notaroomba/frost/README.md

# Frost

A computer that fits into an altoids tin!
