notaroomba/frost/BOM.csv

Item | Price | Source
MIPI Camera (WN-WX19) | 10.58 | https://es.aliexpress.com/item/1005008622498846.html
Li-ion Battery | 8.98 | https://es.aliexpress.com/item/1005009973979747.html
Small Display 2.28 in | 6.4 | https://es.aliexpress.com/item/1005006185077108.html
