notaroomba/frost/hardware/board/assets/frost-Memory and Storage.pdf

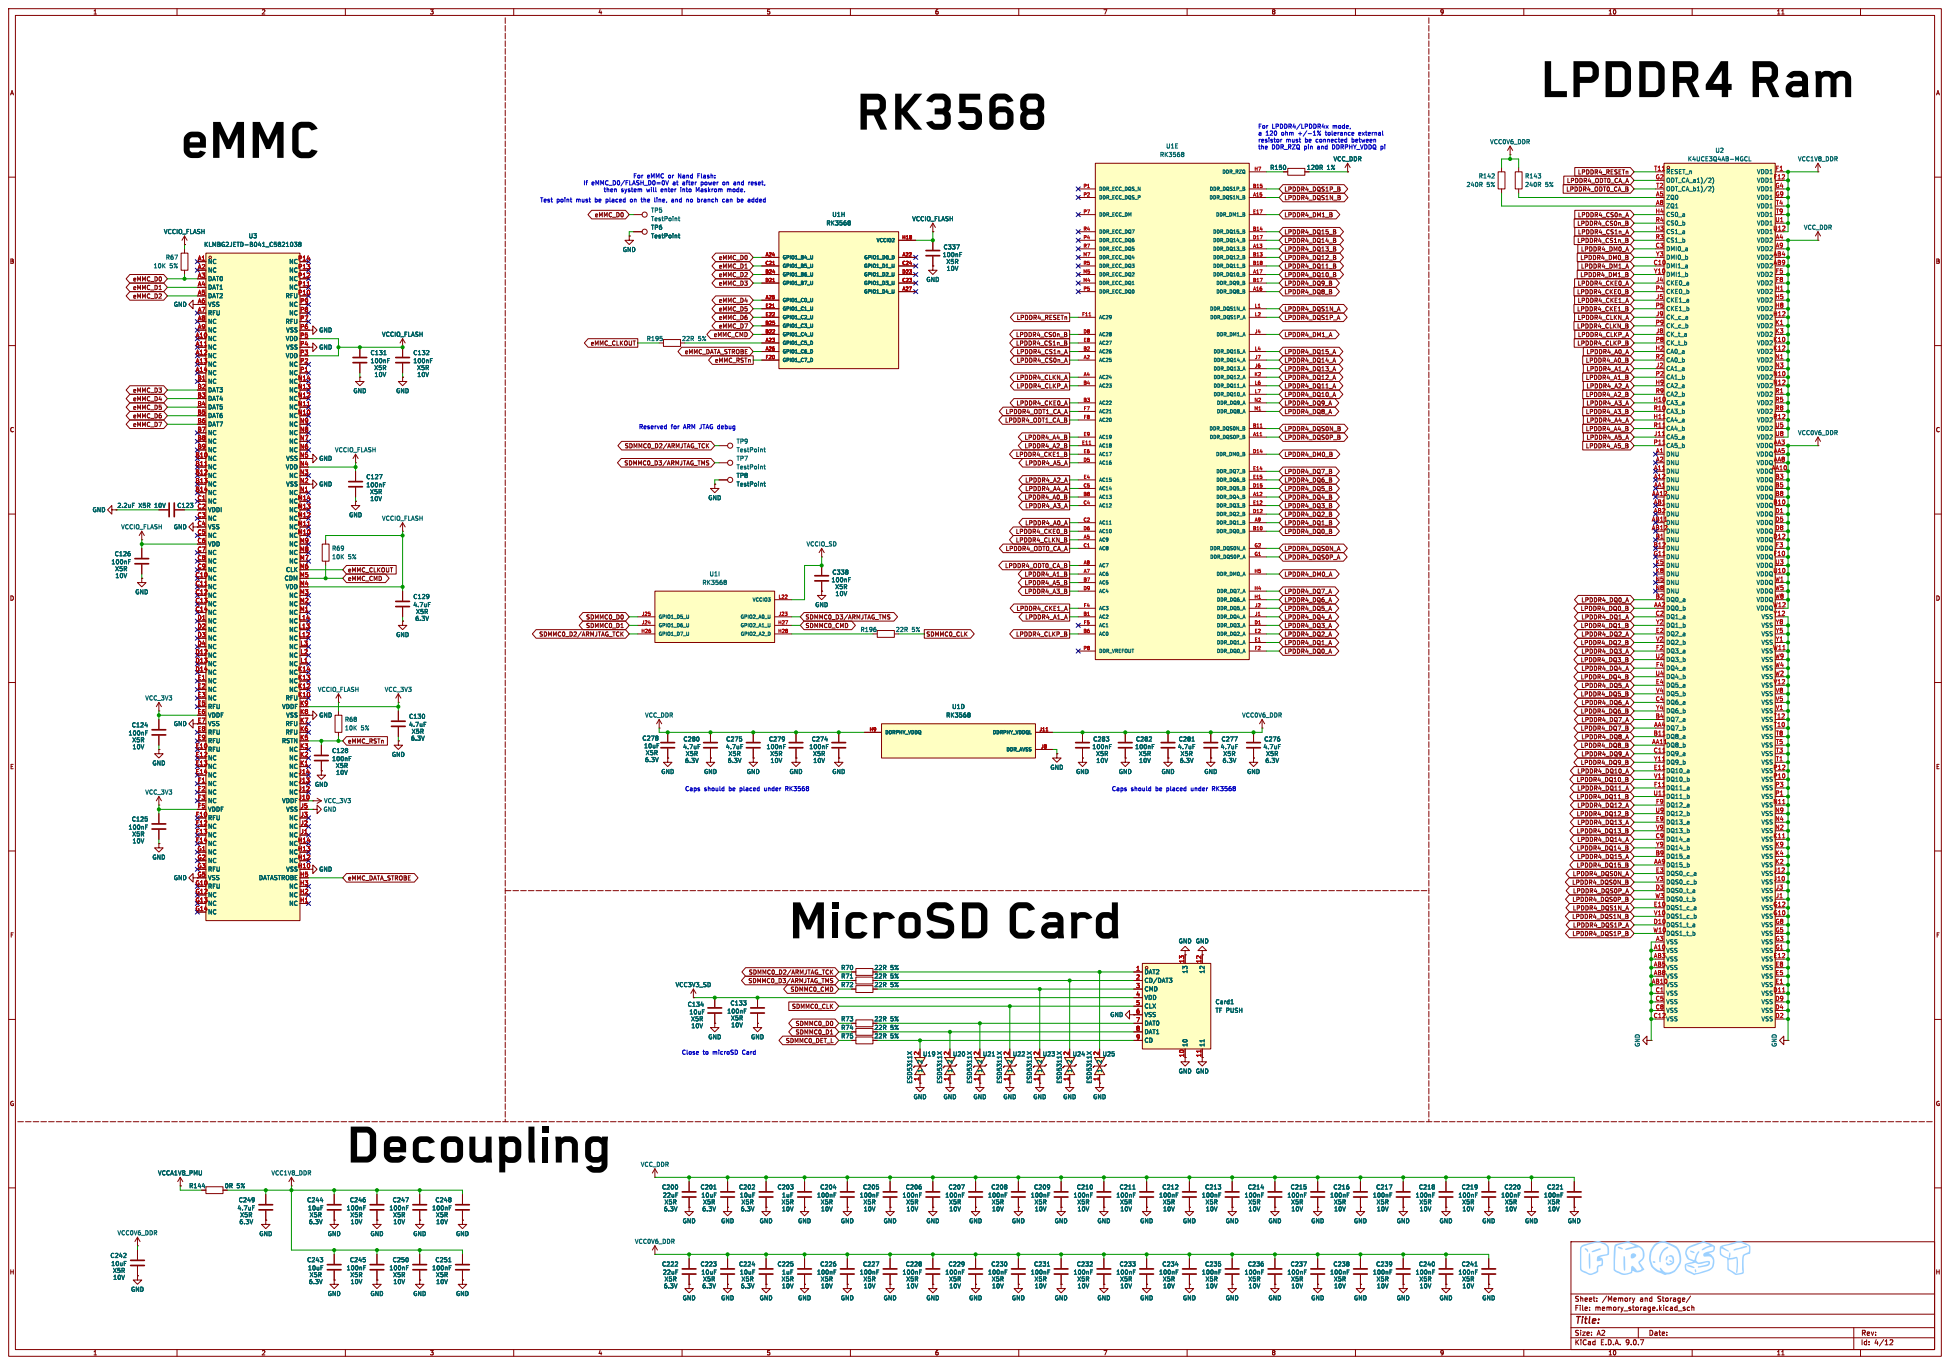
[picture p1: page 1]

RK3568 eMMC
then system will enter into Maskrom mode. Test point must be placed on the line, and no branch can be added Decoupling

the DDR_RZQ pin and DDRPHY_VDDQ pi

NCP14 NCP13 NCP12 NCP11 RFUP10 NC P9 NC P8 RFU P7 VSS P6 VDD P5 VSS P4 VDD P3 NC P2 NC P1 NCN14 NCN13 NCN12 NCN11 NCN10 NC N9 NC N8 NC N7 NC N6 VSS N5 VDD N4 NC N3 VSS N2 NC N1 NCM14 NCM13 NCM12 NCM11 NCM10 NC M9 NC M8 NC M7 CLK M6 CDM M5 VDD M4 NC M3 NC M2 NC M1 NCL14 NCL13 NCL12 NC L3 NC L2 NC L1 NCK14 NCK13 NCK12 RFUK10 VDDF K9 VSS K8 RFU K7 RFU K6 RSTN K5 NC K3 NC K2 NC K1 NCJ14 NCJ13 NCJ12 VDDFJ10 VSS J5 NC J3 NC J2 NC J1 NCH14 NCH13 NCH12 VSSH10 DATASTROBEH5 NC H3 NC H2 NC H1

VCCIO_FLASH
NC A1 NC A2 DAT0 A3 DAT1 A4 DAT2 A5 VSS A6 RFU A7 NC A8 NC A9 NC A10 NC A11 NC A12 NC A13 NC A14 NC B1 DAT3 B2 DAT4 B3 DAT5 B4 DAT6 B5 DAT7 B6 NC B7 NC B8 NC B9 NC B10 NC B11 NC B12 NC B13 NC B14 NC C1 VDDI C2 NC C3 VSS C4 NC C5 VDD C6 NC C7 NC C8 NC C9 NC C10 NC C11 NC C12 NC C13 NC C14 NC D1 NC D2 NC D3 NC D4 NC D12 NC D13 NC D14 NC E1 NC E2 NC E3 RFU E5 VDDF E6 VSS E7 RFU E8 RFU E9 RFU E10 NC E12 NC E13 NC E14 NC F1 NC F2 NC F3 VDDF F5 RFU F10 NC F12 NC F13 NC F14 NC G1 NC G2 RFU G3 VSS G5 RFU G10 NC G12 NC G13 NC G14
GND GND

U3 KLMBG2JETD-B041_C5821038

Reserved for ARM JTAG debug
6.3VGND GND

U3 VDDQ
U10 VDDQ W1 VDDQ W5 VDDQ W8 VDDQW12 VSS
