notaroomba/frost/hardware/board/assets/frost-Power.pdf

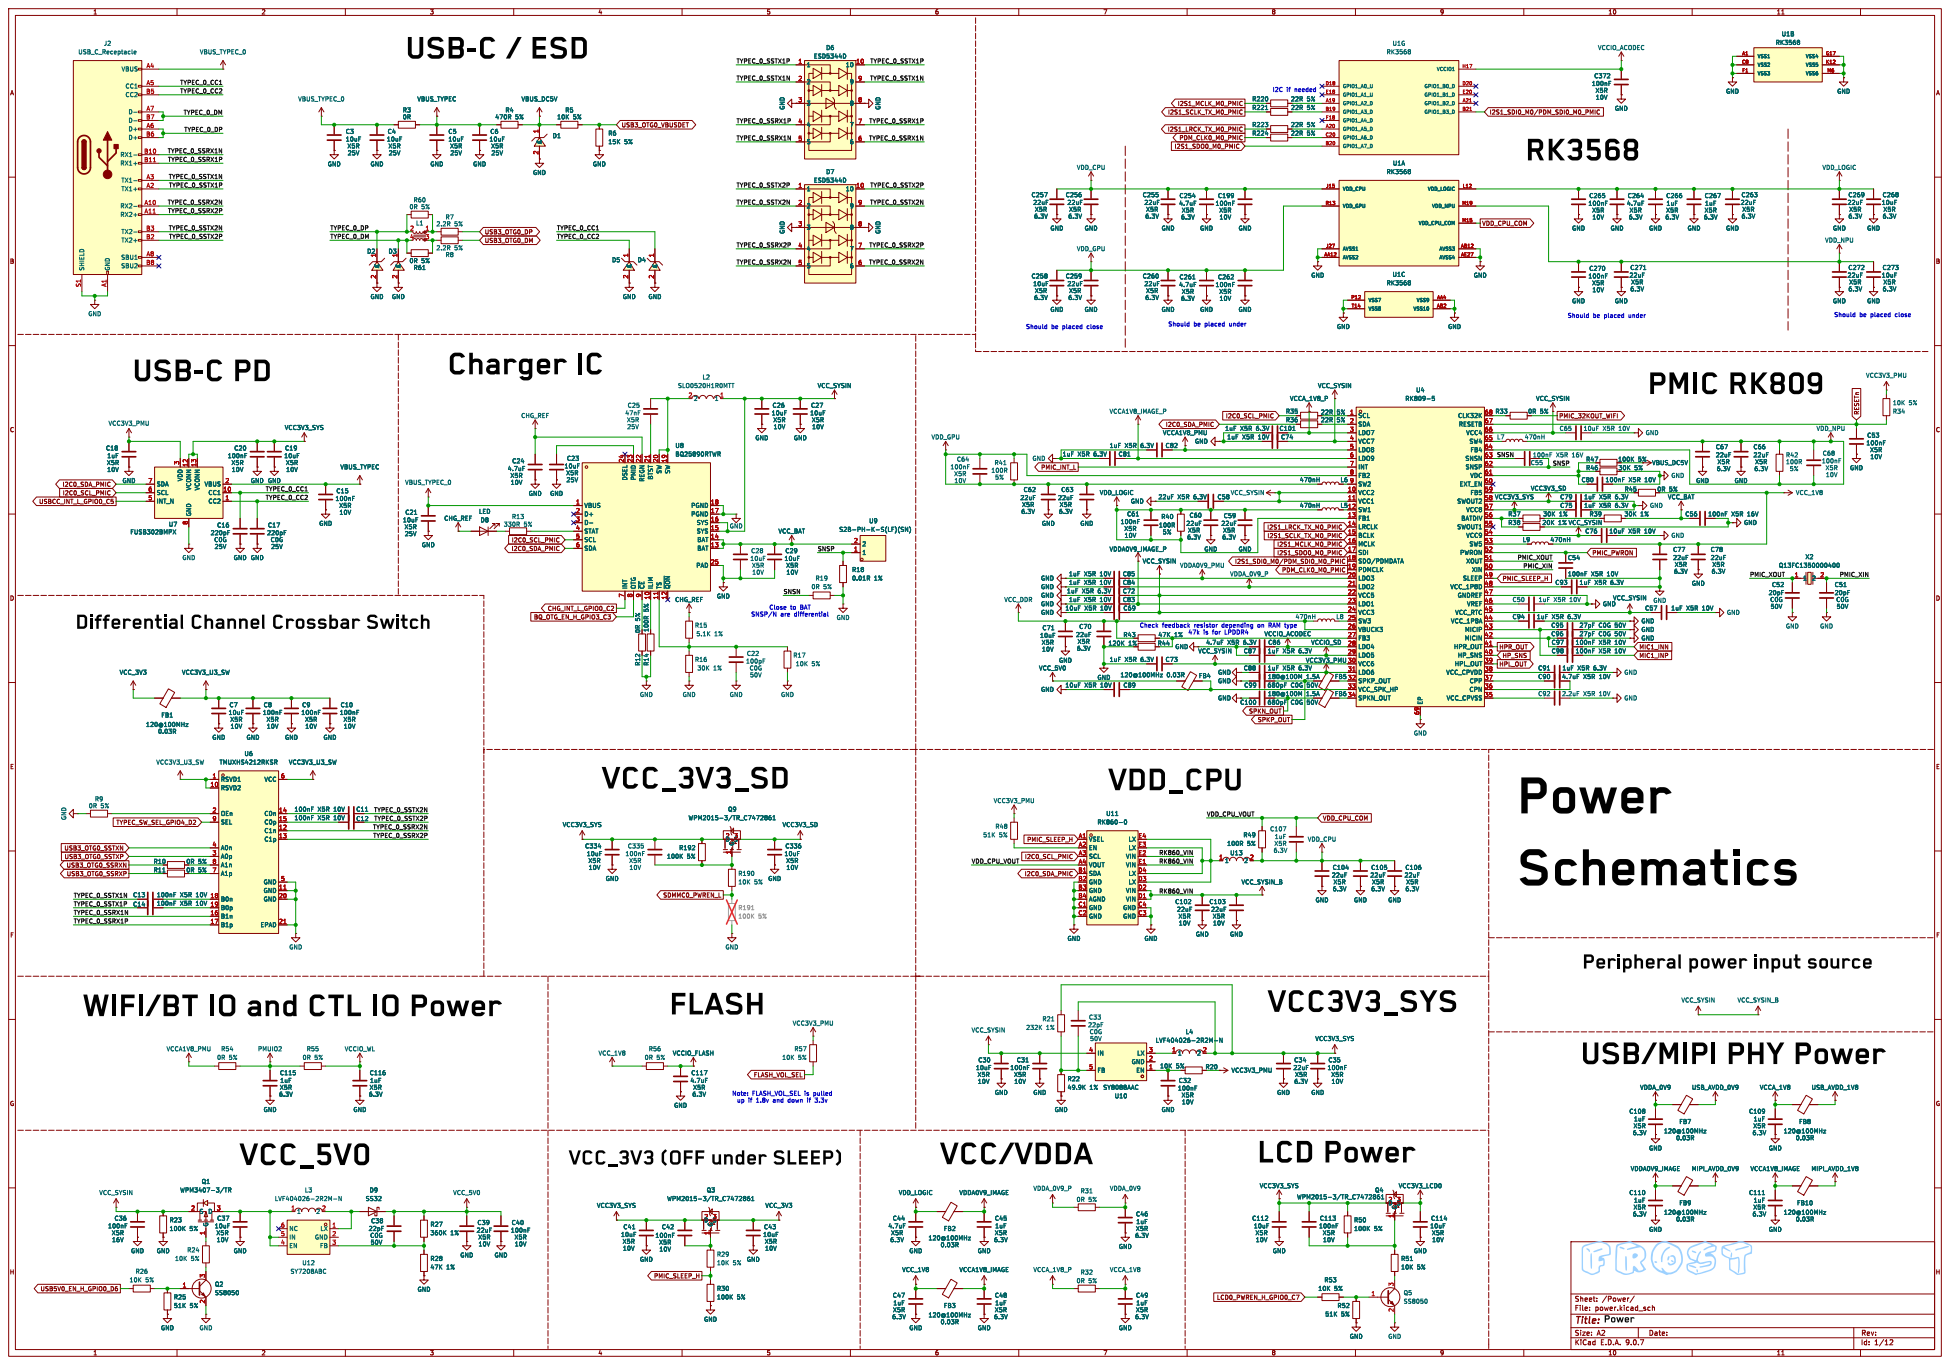
[picture p2: page 1]

47k is for LPDDR4 USB-C/ ESD

Should be placed under RK3568

Should be placed close VDD_CPU

Should be placed under ChargerIC

8 REGN 22 ~{CE} 9 BTST 21 ILIM 10 SW 20 TS 11 SW 19 ~{QON} 12 PGND 18 PGND 17 SYS 16 SYS 15 BAT 14 BAT 13 PAD 25 U8BQ25890RTWR

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

Close to BAT SNSP/N are differential VCC_5V0

LX D3 VIN D2 VIN D1 GND C4 GND C3 U11 RK860-0
VSEL A1 EN A2 SCL A3 VOUT A4 SDA B1 GND B2 GND B3 AGND B4 GND C1 GND C2

LX 1 GND 2 FB 3 NC 6
