notaroomba/frost/hardware/board/assets/frost-USB.pdf

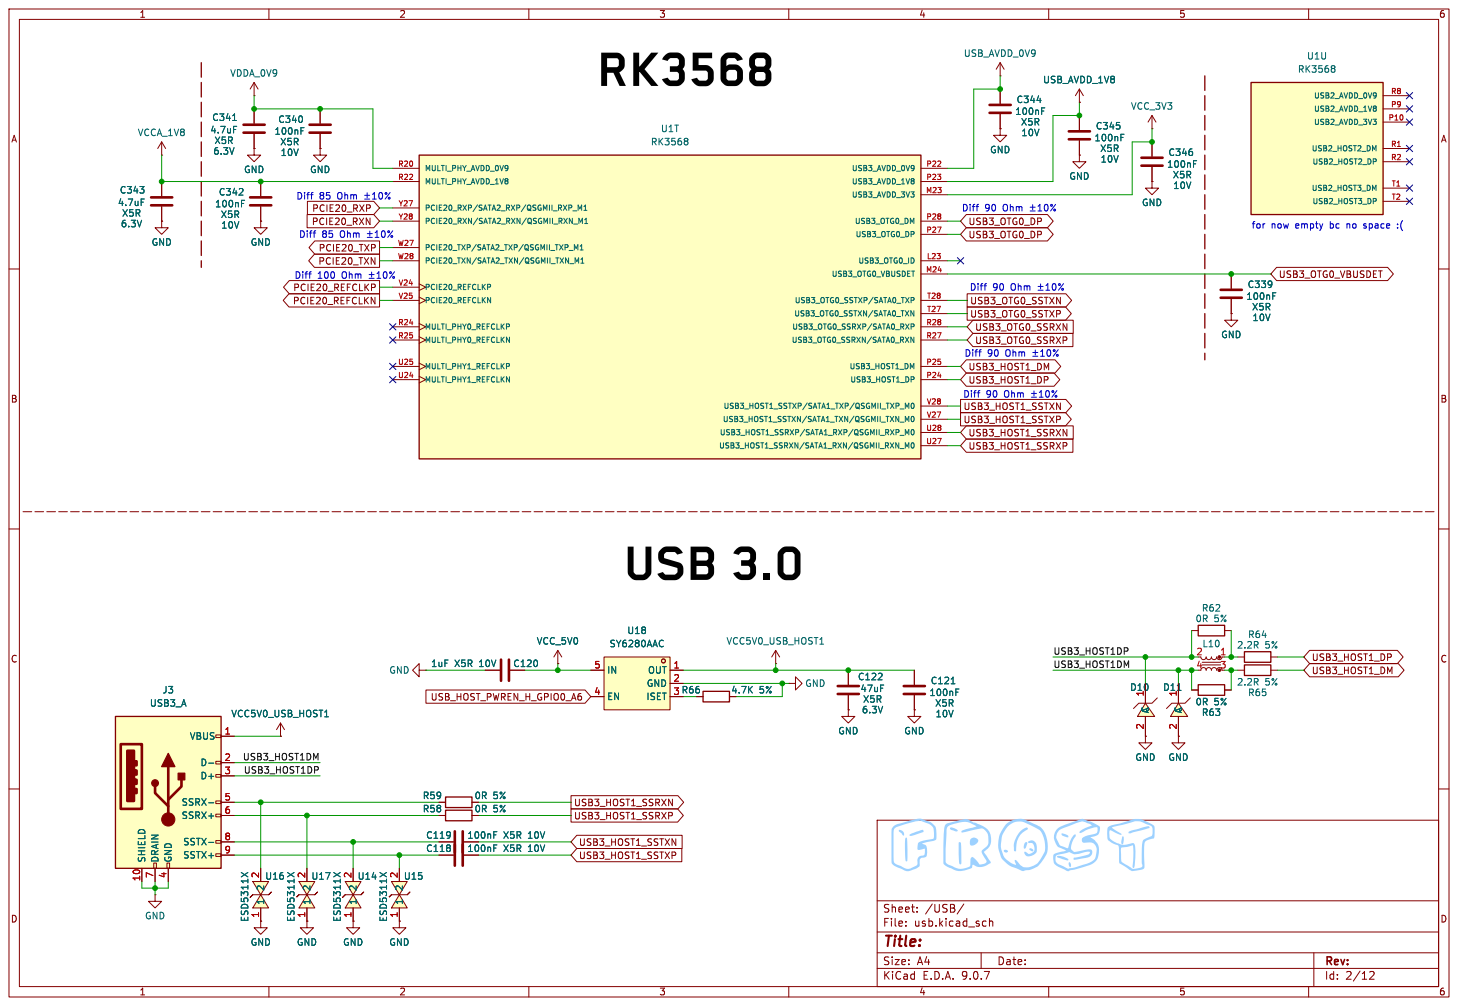
[picture p3: page 1]

for now empty bc no space :( GND

4 VBUS 1 D- 2 D+ 3 SSRX- 5 SSRX+ 6 SSTX- 8 SSTX+ 9

4 VBUS 1 D- 2 D+ 3 SSRX- 5 SSRX+ 6 SSTX- 8 SSTX+ 9 C119 100nF X5R 10V R58 0R 5%
