notaroomba/frost/hardware/board/assets/frost-WiFi and Bluetooth.pdf

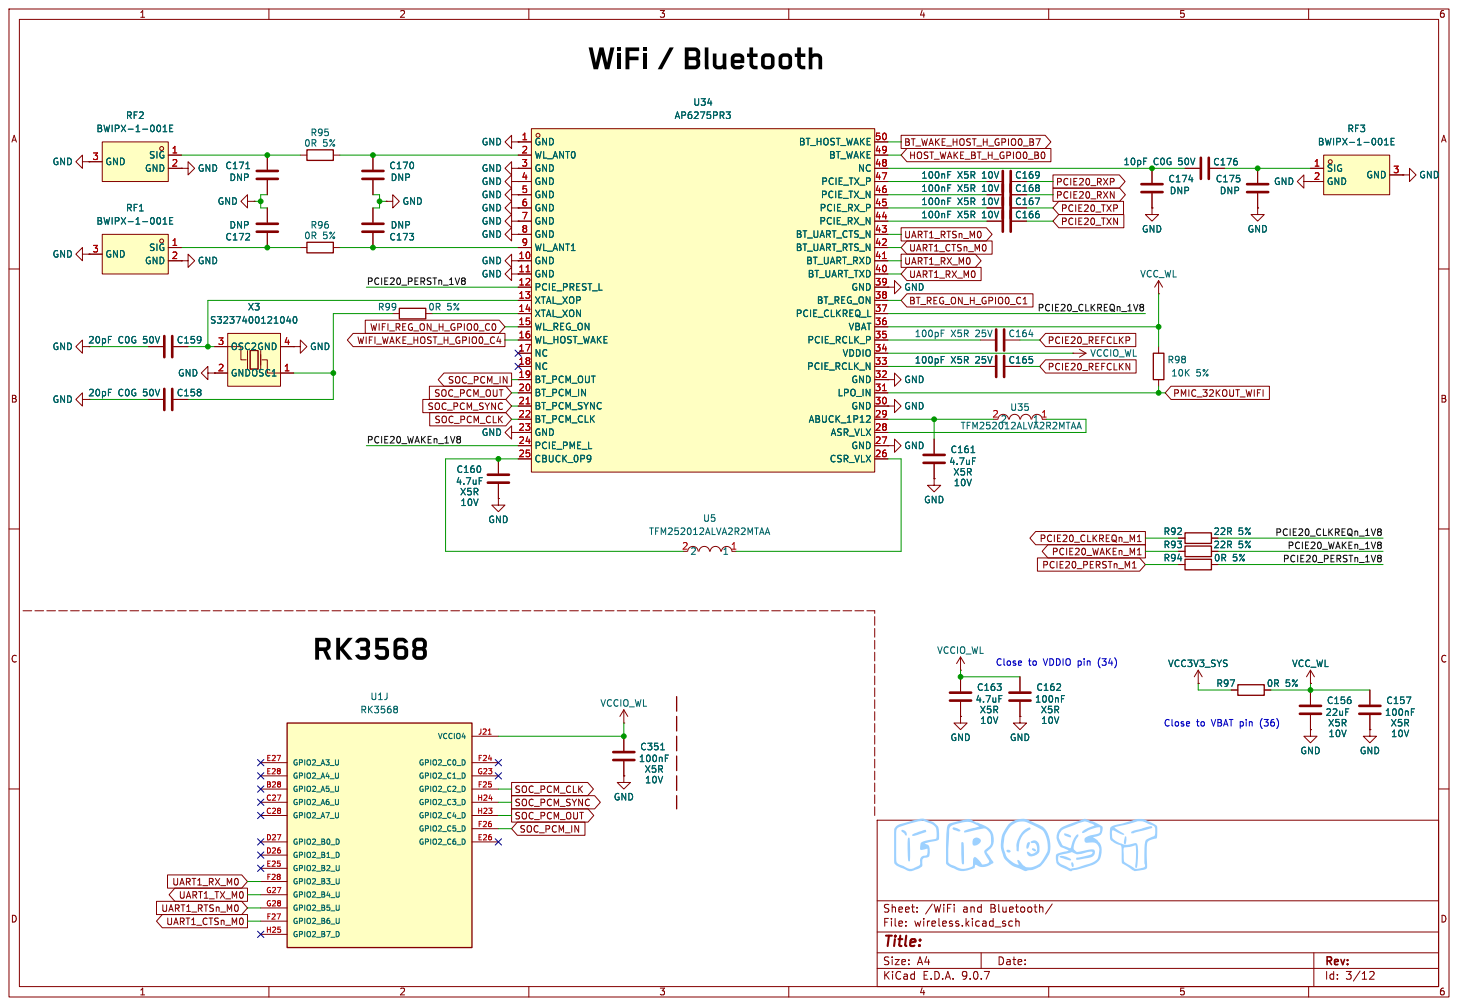
[picture p4: page 1]

3 GND
X3 S3237400121040 GND 4 OSC1 1 OSC2 3 GND 2 C171 DNP GND
GND

GND GND GND GND GND
