notaroomba/frost/hardware/board/frost.kicad_pcb

## KiCad design hardware/board/frost.kicad_pcb (2026-08-28)

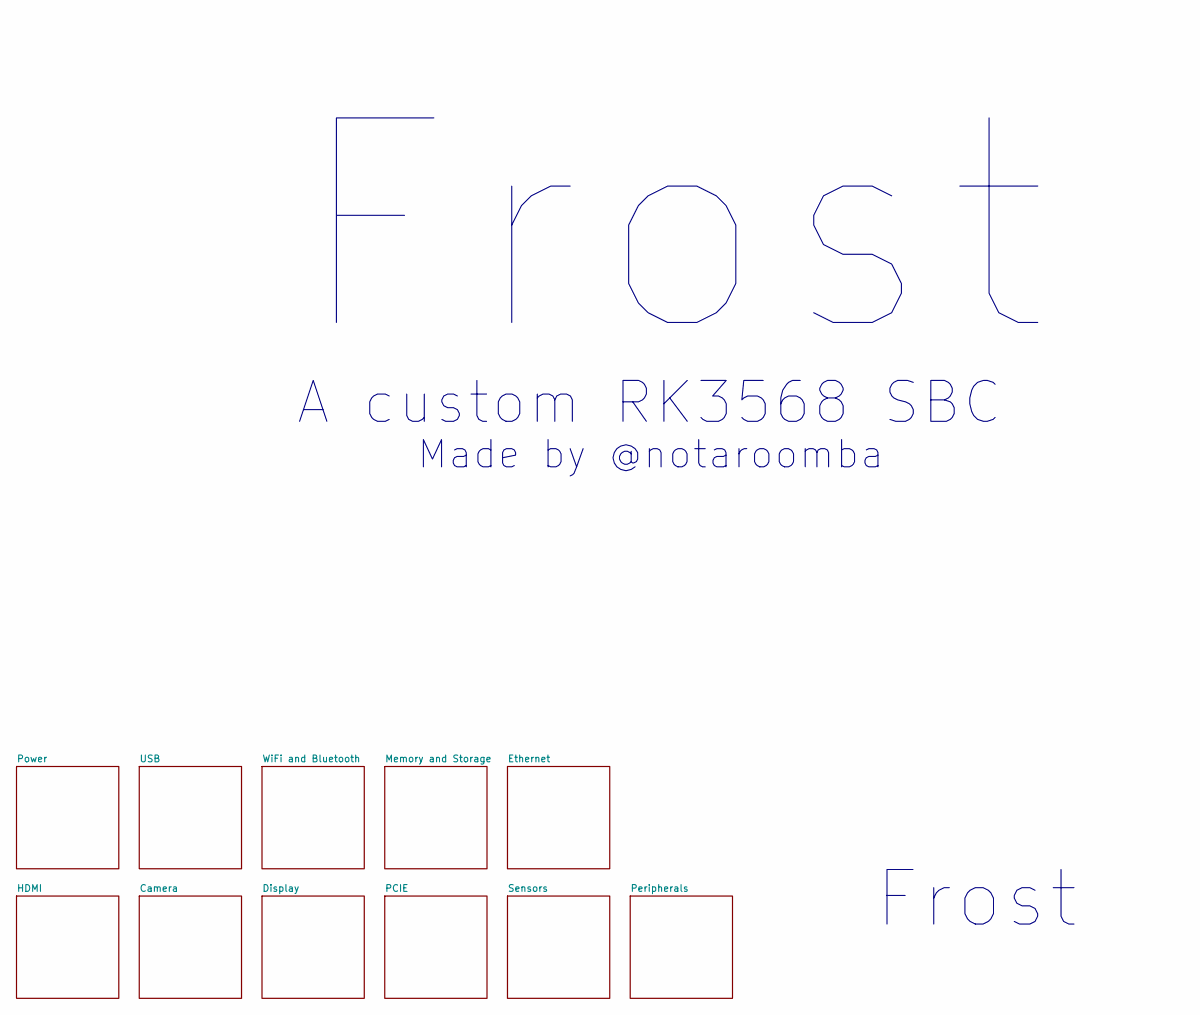
[picture p5: schematic frost.kicad_sch]

Notes on the sheet:
Frost
Made by @notaroomba
A custom RK3568 SBC

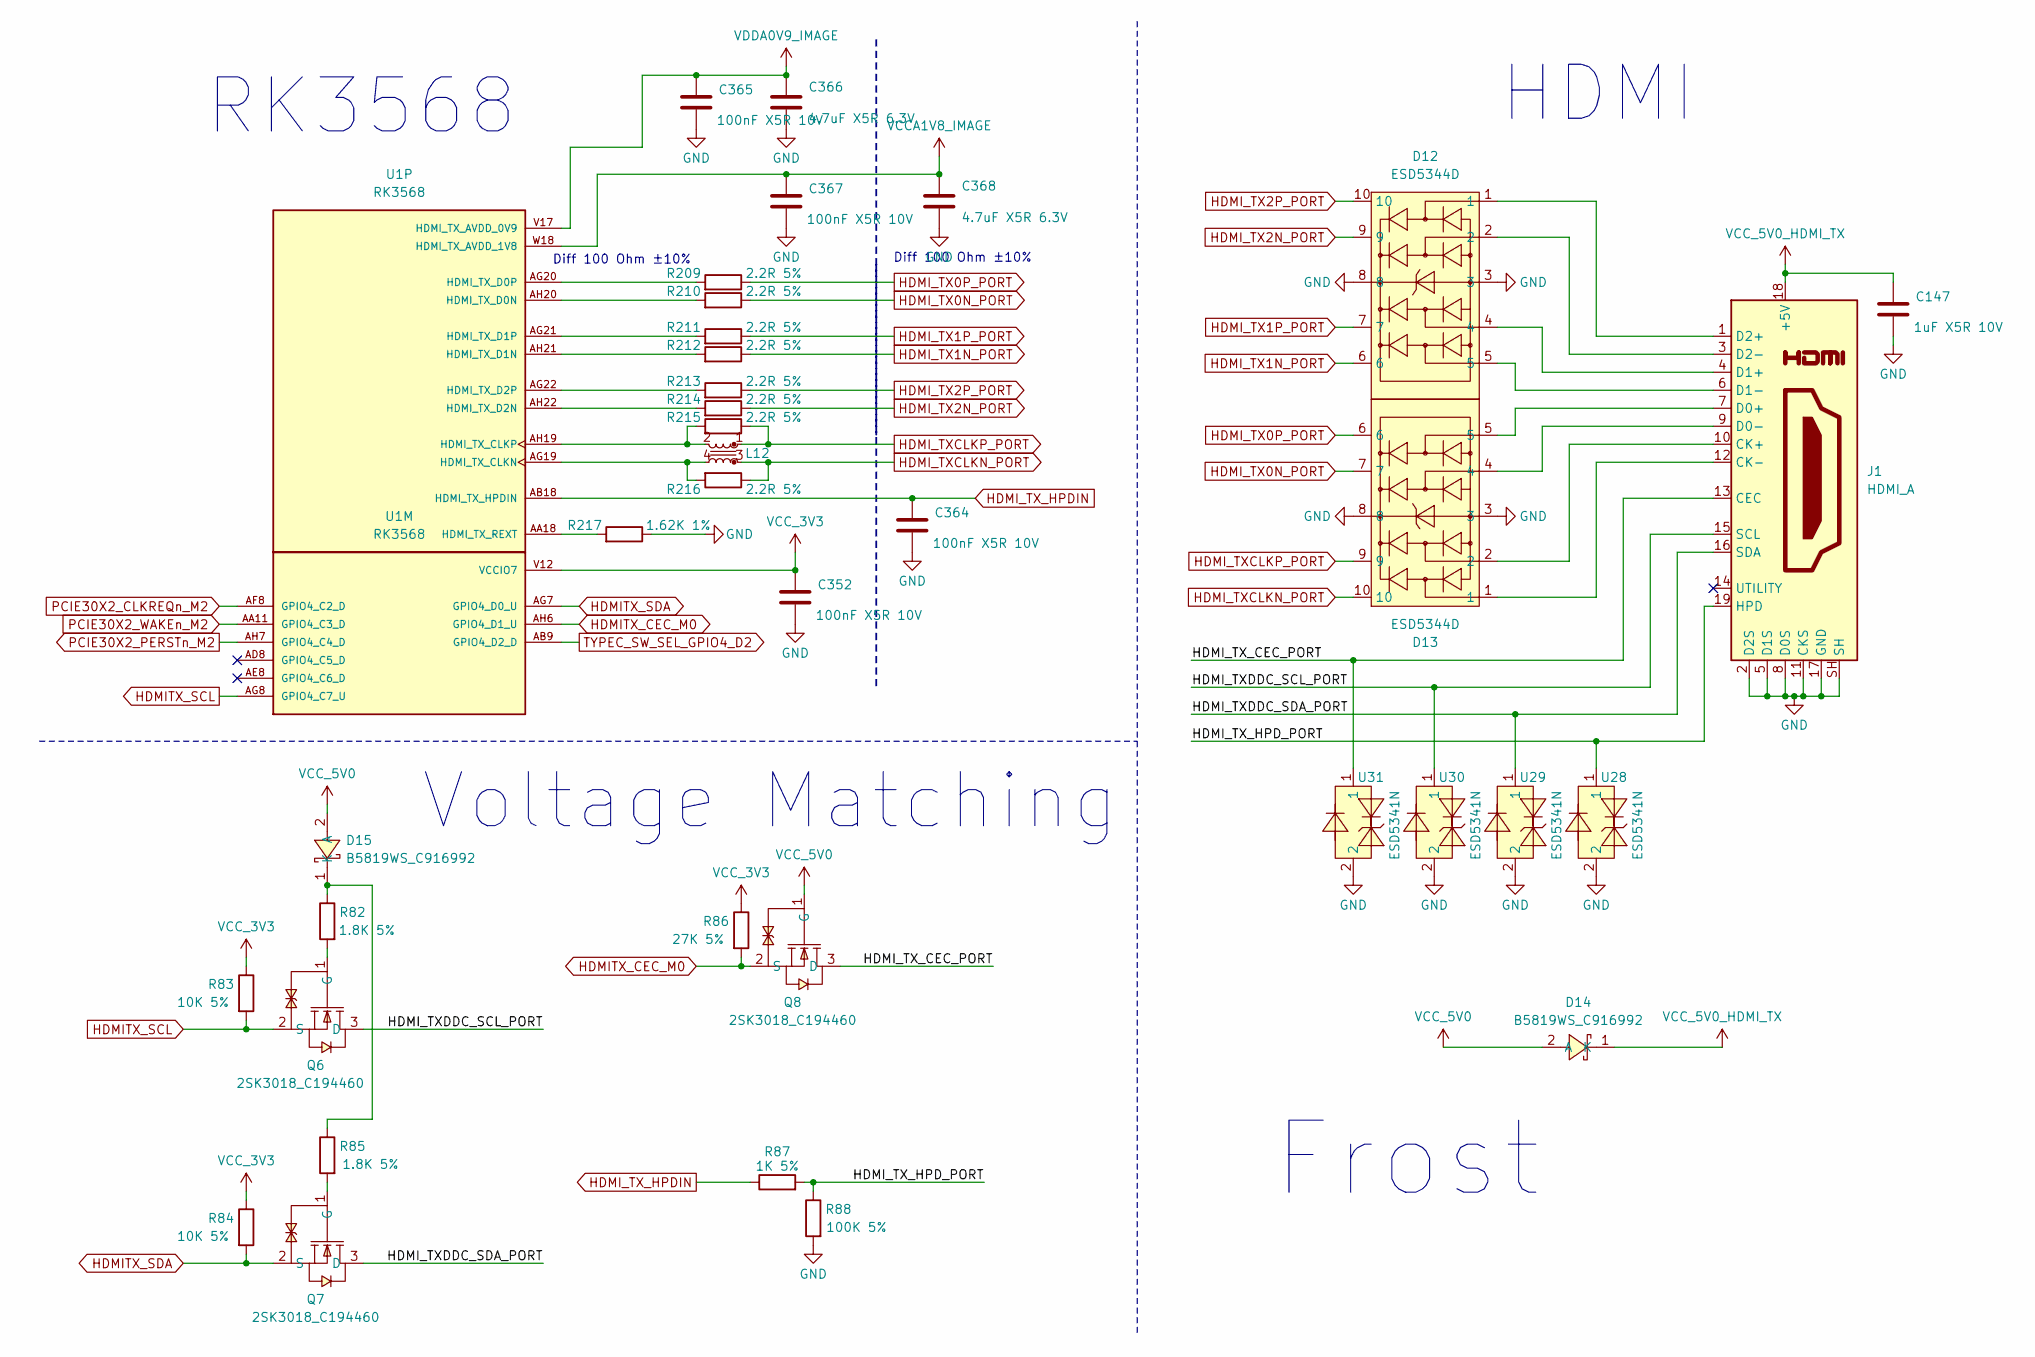
[picture p6: schematic hdmi.kicad_sch]

Parts:
C147: 1uF X5R 10V; C_0402_1005Metric
C352, C364, C365, C367: 100nF X5R 10V; C_0201_0603Metric
C366, C368: 4.7uF X5R 6.3V; C_0402_1005Metric
D12, D13: ESD5344D; DFN2510-10_L2.5-W1.0-P0.50-BL; LCSC Part C6562203
D14, D15: B5819WS_C916992; SOD-323_L1.7-W1.3-LS2.5-RD; LCSC Part C916992
J1: HDMI_A; HDMI_A_Amphenol_10029449-x01xLF_Horizontal
L12: L_Iron_Coupled_Small; FILTER-SMD_4P-L2.0-W1.2-BL_DLW21H
Q6, Q7, Q8: 2SK3018_C194460; SOT-323-3_L2.0-W1.3-P1.30-LS2.1-BR; LCSC Part C194460
R82, R85: 1.8K 5%; R_0402_1005Metric
R83, R84: 10K 5%; R_0402_1005Metric
R86: 27K 5%; R_0402_1005Metric
R87: 1K 5%; R_0402_1005Metric
R88: 100K 5%; R_0402_1005Metric
R209, R210, R211, R212, R213, R214, R215, R216: 2.2R 5%; R_0402_1005Metric
R217: 1.62K 1%; R_0201_0603Metric
U1: RK3568; BGA636C65P28X28_1900X1900X168; PARTREV 1.3; LCSC C3345225
U28, U29, U30, U31: ESD5341N; DFN1006-2L-RD; LCSC Part C3021106

Connections:
/HDMI/HDMI_TXDDC_SCL_PORT: J1.15 (SCL), Q6.3 (D), U30.1
/HDMI/HDMI_TXDDC_SDA_PORT: J1.16 (SDA), Q7.3 (D), U29.1
/HDMI/HDMI_TX_CEC_PORT: J1.13 (CEC), Q8.3 (D), U31.1
/HDMI/HDMI_TX_HPD_PORT: J1.19 (HPD), R87.2, R88.1, U28.1
HDMITX_CEC_M0: Q8.2 (S), R86.2, U1.AH6 (GPIO4_D1_U)
HDMITX_SCL: Q6.2 (S), R83.2, U1.AG8 (GPIO4_C7_U)
HDMITX_SDA: Q7.2 (S), R84.2, U1.AG7 (GPIO4_D0_U)
HDMI_TX0N_PORT: D13.7, R210.1
HDMI_TX0P_PORT: D13.6, R209.1
HDMI_TX1N_PORT: D12.6, R212.1
HDMI_TX1P_PORT: D12.7, R211.1
HDMI_TX2N_PORT: D12.9, R214.1
HDMI_TX2P_PORT: D12.10, R213.1
HDMI_TXCLKN_PORT: D13.10, L12.3, R216.1
HDMI_TXCLKP_PORT: D13.9, L12.1, R215.1
HDMI_TX_HPDIN: C364.1, R87.1, U1.AB18 (HDMI_TX_HPDIN)
unnamed: D15.1 (K), R82.1, R85.1
unnamed: D13.2, J1.10 (CK+)
unnamed: D13.1, J1.12 (CK-)
unnamed: D13.5, J1.7 (D0+)
unnamed: D13.4, J1.9 (D0-)
unnamed: D12.4, J1.4 (D1+)
unnamed: D12.5, J1.6 (D1-)
unnamed: D12.1, J1.1 (D2+)
unnamed: D12.2, J1.3 (D2-)
unnamed: Q6.1 (G), R82.2
unnamed: Q7.1 (G), R85.2
unnamed: L12.4, R216.2, U1.AG19 (HDMI_TX_CLKN)
unnamed: L12.2, R215.2, U1.AH19 (HDMI_TX_CLKP)
unnamed: R210.2, U1.AH20 (HDMI_TX_D0N)
unnamed: R209.2, U1.AG20 (HDMI_TX_D0P)
unnamed: R212.2, U1.AH21 (HDMI_TX_D1N)
unnamed: R211.2, U1.AG21 (HDMI_TX_D1P)
unnamed: R214.2, U1.AH22 (HDMI_TX_D2N)
unnamed: R213.2, U1.AG22 (HDMI_TX_D2P)
unnamed: R217.2, U1.AA18 (HDMI_TX_REXT)
PCIE30X2_CLKREQn_M2: U1.AF8 (GPIO4_C2_D); also elsewhere on the board
PCIE30X2_PERSTn_M2: U1.AH7 (GPIO4_C4_D); also elsewhere on the board
PCIE30X2_WAKEn_M2: U1.AA11 (GPIO4_C3_D); also elsewhere on the board
TYPEC_SW_SEL_GPIO4_D2: U1.AB9 (GPIO4_D2_D); also elsewhere on the board
VCCA1V8_IMAGE: C367.1, C368.1, U1.W18 (HDMI_TX_AVDD_1V8); also elsewhere on the board
VCC_3V3: C352.1, R83.1, R84.1, R86.1, U1.V12 (VCCIO7); also elsewhere on the board
VCC_5V0: D14.2 (A), D15.2 (A), Q8.1 (G); also elsewhere on the board
VCC_5V0_HDMI_TX: C147.1, D14.1 (K), J1.18 (+5V)
VDDA0V9_IMAGE: C365.1, C366.1, U1.V17 (HDMI_TX_AVDD_0V9), U1.V18 (HDMI_TX_AVDD_0V9); also elsewhere on the board

Notes on the sheet:
HDMI
RK3568
Voltage Matching
Frost
Diff 100 Ohm ±10%

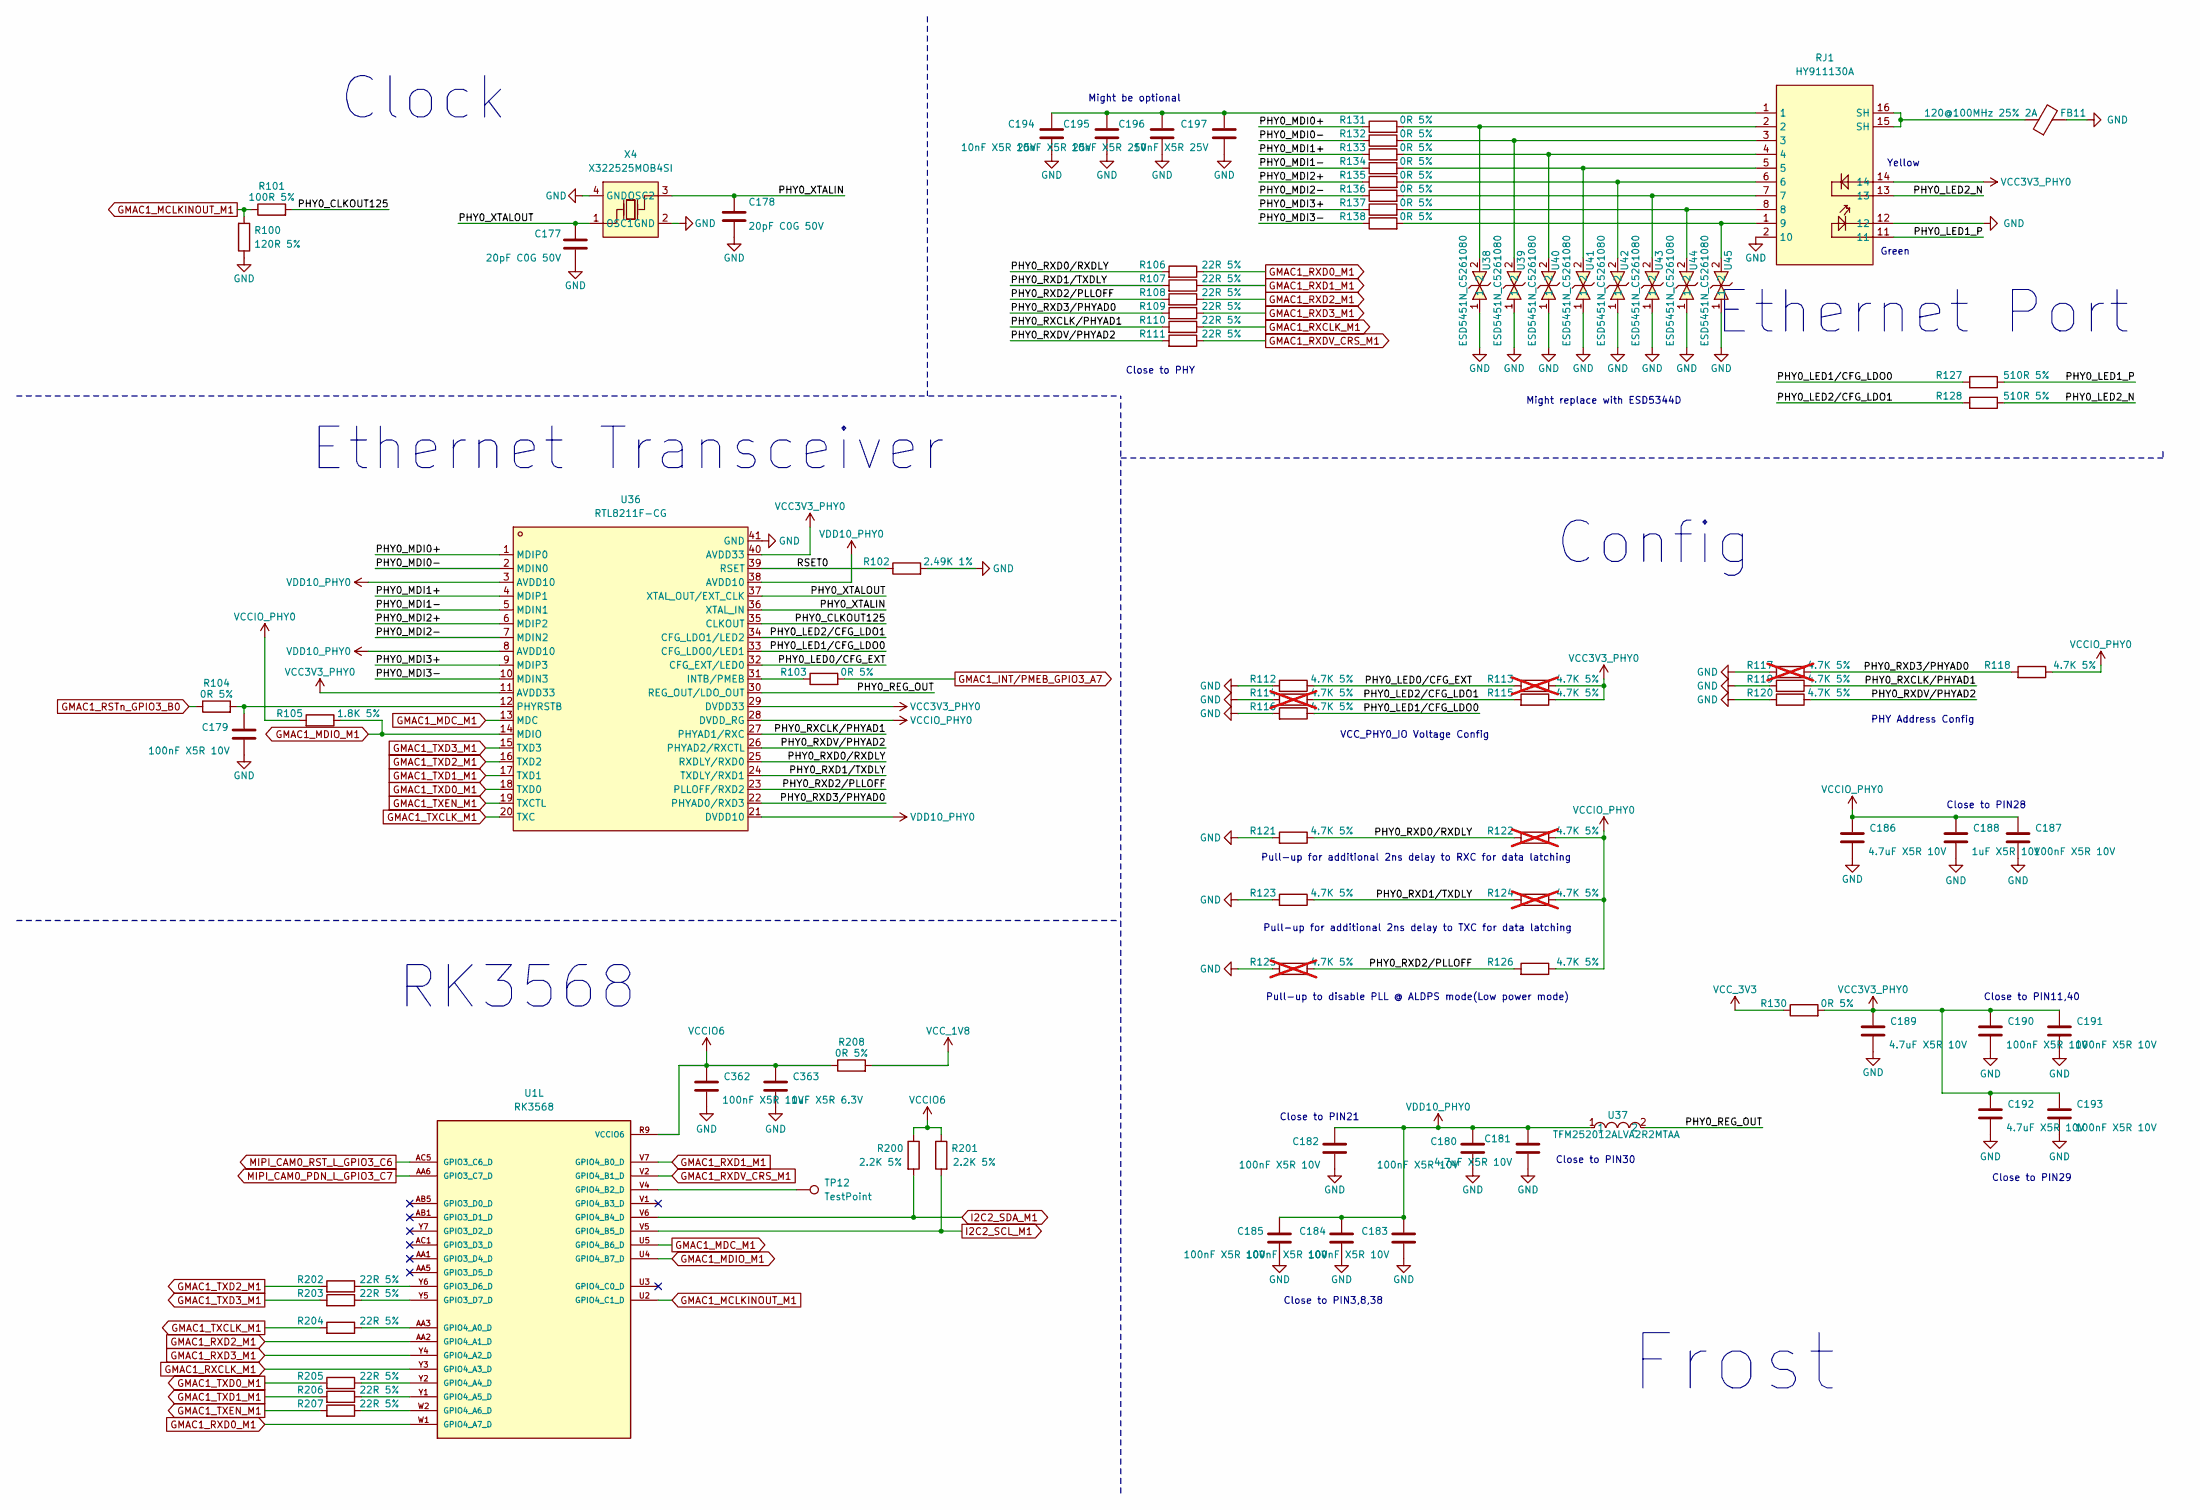
[picture p7: schematic ethernet.kicad_sch]

Parts:
C177, C178: 20pF C0G 50V; C_0402_1005Metric
C179, C180, C182, C183, C184, C185, C187, C190, C191, C193: 100nF X5R 10V; C_0402_1005Metric
C181, C186, C189, C192: 4.7uF X5R 10V; C_0603_1608Metric
C188: 1uF X5R 10V; C_0402_1005Metric
C194, C195, C196, C197: 10nF X5R 25V; C_0402_1005Metric
C362: 100nF X5R 10V; C_0201_0603Metric
C363: 1uF X5R 6.3V; C_0402_1005Metric
FB11: 120@100MHz 25% 2A; L_0603_1608Metric; LCSC C14709
R100: 120R 5%; R_0402_1005Metric
R101: 100R 5%; R_0402_1005Metric
R102: 2.49K 1%; R_0402_1005Metric
R103, R104, R130, R131, R132, R133, R134, R135, R136, R137, R138, R208: 0R 5%; R_0402_1005Metric
R105: 1.8K 5%; R_0402_1005Metric
R106, R107, R108, R109, R110, R111, R202, R203, R204, R205, R206, R207: 22R 5%; R_0402_1005Metric
R112, R115, R116, R118, R119, R120, R121, R123, R126: 4.7K 5%; R_0402_1005Metric
R113, R114, R117, R122, R124, R125: 4.7K 5%; R_0402_1005Metric; not fitted
R127, R128: 510R 5%; R_0402_1005Metric
R200, R201: 2.2K 5%; R_0402_1005Metric
RJ1: HY911130A; RJ45-TH_10P-P2.54-S2.54_L16.1-W21.4_HY911130A; LCSC Part C55679
TP12: TestPoint; TestPoint_Pad_D1.0mm
U1: RK3568; BGA636C65P28X28_1900X1900X168; PARTREV 1.3; LCSC C3345225
U36: RTL8211F-CG; WQFN-40_L5.0-W5.0-P0.4-BL-EP; LCSC Part C187932
U37: TFM252012ALVA2R2MTAA; L1008; LCSC Part C2047711
U38, U39, U40, U41, U42, U43, U44, U45: ESD5451N_C5261080; DFN1006-2L-BI; LCSC Part C5261080
X4: X322525MOB4SI; CRYSTAL-SMD_4P-L3.2-W2.5-BL; LCSC Part C9006

Connections:
/Ethernet/PHY0_CLKOUT125: R101.2, U36.35 (CLKOUT)
/Ethernet/PHY0_LED0/CFG_EXT: R112.1, R113.2, U36.32 (CFG_EXT/LED0)
/Ethernet/PHY0_LED1_P: R127.1, RJ1.11
/Ethernet/PHY0_LED1/CFG_LDO0: R116.1, R127.2, U36.33 (CFG_LDO0/LED1)
/Ethernet/PHY0_LED2_N: R128.1, RJ1.13
/Ethernet/PHY0_LED2/CFG_LDO1: R114.1, R115.2, R128.2, U36.34 (CFG_LDO1/LED2)
/Ethernet/PHY0_MDI0+: R131.1, U36.1 (MDIP0)
/Ethernet/PHY0_MDI0-: R132.1, U36.2 (MDIN0)
/Ethernet/PHY0_MDI1+: R133.1, U36.4 (MDIP1)
/Ethernet/PHY0_MDI1-: R134.1, U36.5 (MDIN1)
/Ethernet/PHY0_MDI2+: R135.1, U36.6 (MDIP2)
/Ethernet/PHY0_MDI2-: R136.1, U36.7 (MDIN2)
/Ethernet/PHY0_MDI3+: R137.1, U36.9 (MDIP3)
/Ethernet/PHY0_MDI3-: R138.1, U36.10 (MDIN3)
/Ethernet/PHY0_REG_OUT: U36.30 (REG_OUT/LDO_OUT), U37.2
/Ethernet/PHY0_RXCLK/PHYAD1: R110.2, R119.1, U36.27 (PHYAD1/RXC)
/Ethernet/PHY0_RXD0/RXDLY: R106.2, R121.1, R122.2, U36.25 (RXDLY/RXD0)
/Ethernet/PHY0_RXD1/TXDLY: R107.2, R123.1, R124.2, U36.24 (TXDLY/RXD1)
/Ethernet/PHY0_RXD2/PLLOFF: R108.2, R125.1, R126.2, U36.23 (PLLOFF/RXD2)
/Ethernet/PHY0_RXD3/PHYAD0: R109.2, R117.1, R118.2, U36.22 (PHYAD0/RXD3)
/Ethernet/PHY0_RXDV/PHYAD2: R111.2, R120.1, U36.26 (PHYAD2/RXCTL)
/Ethernet/PHY0_XTALIN: C178.1, U36.36 (XTAL_IN), X4.3 (OSC2)
/Ethernet/PHY0_XTALOUT: C177.1, U36.37 (XTAL_OUT/EXT_CLK), X4.1 (OSC1)
/Ethernet/RSET0: R102.1, U36.39 (RSET)
GMAC1_INT/PMEB_GPIO3_A7: R103.2
GMAC1_MCLKINOUT_M1: R100.2, R101.1, U1.U2 (GPIO4_C1_D)
GMAC1_MDC_M1: U1.U5 (GPIO4_B6_D), U36.13 (MDC)
GMAC1_MDIO_M1: R105.1, U1.U4 (GPIO4_B7_D), U36.14 (MDIO)
GMAC1_RSTn_GPIO3_B0: R104.1
GMAC1_RXCLK_M1: R110.1, U1.Y3 (GPIO4_A3_D)
GMAC1_RXD0_M1: R106.1, U1.W1 (GPIO4_A7_D)
GMAC1_RXD1_M1: R107.1, U1.V7 (GPIO4_B0_D)
GMAC1_RXD2_M1: R108.1, U1.AA2 (GPIO4_A1_D)
GMAC1_RXD3_M1: R109.1, U1.Y4 (GPIO4_A2_D)
GMAC1_RXDV_CRS_M1: R111.1, U1.V2 (GPIO4_B1_D)
GMAC1_TXCLK_M1: R204.2, U36.20 (TXC)
GMAC1_TXD0_M1: R205.2, U36.18 (TXD0)
GMAC1_TXD1_M1: R206.2, U36.17 (TXD1)
GMAC1_TXD2_M1: R202.2, U36.16 (TXD2)
GMAC1_TXD3_M1: R203.2, U36.15 (TXD3)
GMAC1_TXEN_M1: R207.2, U36.19 (TXCTL)
I2C2_SCL_M1: R201.2, U1.V5 (GPIO4_B5_D); also elsewhere on the board
I2C2_SDA_M1: R200.2, U1.V6 (GPIO4_B4_D); also elsewhere on the board
MIPI_CAM0_PDN_L_GPIO3_C7: U1.AA6 (GPIO3_C7_D)
MIPI_CAM0_RST_L_GPIO3_C6: U1.AC5 (GPIO3_C6_D); also elsewhere on the board
unnamed: FB11.1, RJ1.15 (SH), RJ1.16 (SH)
unnamed: R132.2, RJ1.3, U39.2
unnamed: R133.2, RJ1.4, U40.2
unnamed: R134.2, RJ1.5, U41.2
unnamed: R135.2, RJ1.6, U42.2
unnamed: R136.2, RJ1.7, U43.2
unnamed: R137.2, RJ1.8, U44.2
unnamed: R202.1, U1.Y6 (GPIO3_D6_D)
unnamed: R203.1, U1.Y5 (GPIO3_D7_D)
unnamed: R204.1, U1.AA3 (GPIO4_A0_D)
unnamed: R205.1, U1.Y2 (GPIO4_A4_D)
unnamed: R206.1, U1.Y1 (GPIO4_A5_D)
unnamed: R207.1, U1.W2 (GPIO4_A6_D)
unnamed: TP12.1, U1.V4 (GPIO4_B2_D)
unnamed: R103.1, U36.31 (INTB/PMEB)
unnamed: C179.1, R104.2, U36.12 (PHYRSTB)
VCC3V3_PHY0: C189.1, C190.1, C191.1, C192.1, C193.1, R113.1, R115.1, R130.2, RJ1.14, U36.11 (AVDD33), U36.29 (DVDD33), U36.40 (AVDD33)
VCCIO6: C362.1, C363.1, R200.1, R201.1, R208.1, U1.R9 (VCCIO6), U1.U9 (VCCIO6)
VCCIO_PHY0: C186.1, C187.1, C188.1, R105.2, R118.1, R122.1, R124.1, R126.1, U36.28 (DVDD_RG)
VCC_1V8: R208.2; also elsewhere on the board
VCC_3V3: R130.1; also elsewhere on the board
VDD10_PHY0: C180.1, C181.1, C182.1, C183.1, C184.1, C185.1, U36.3 (AVDD10), U36.8 (AVDD10), U36.21 (DVDD10), U36.38 (AVDD10), U37.1

Notes on the sheet:
Close to PIN29
Might replace with ESD5344D
Config
Might be optional
Close to PHY
Close to PIN30
Green
Ethernet Port
Pull-up to disable PLL @ ALDPS mode(Low power mode)
Pull-up for additional 2ns delay to TXC for data latching
Frost
Yellow
Close to PIN21
Clock
Pull-up for additional 2ns delay to RXC for data latching
Close to PIN28
RK3568
Close to PIN11,40
Ethernet Transceiver
PHY Address Config
Close to PIN3,8,38
VCC_PHY0_IO Voltage Config
