notaroomba/frost/hardware/board/frost.kicad_pcb

## KiCad design hardware/board/frost.kicad_pcb (continued)

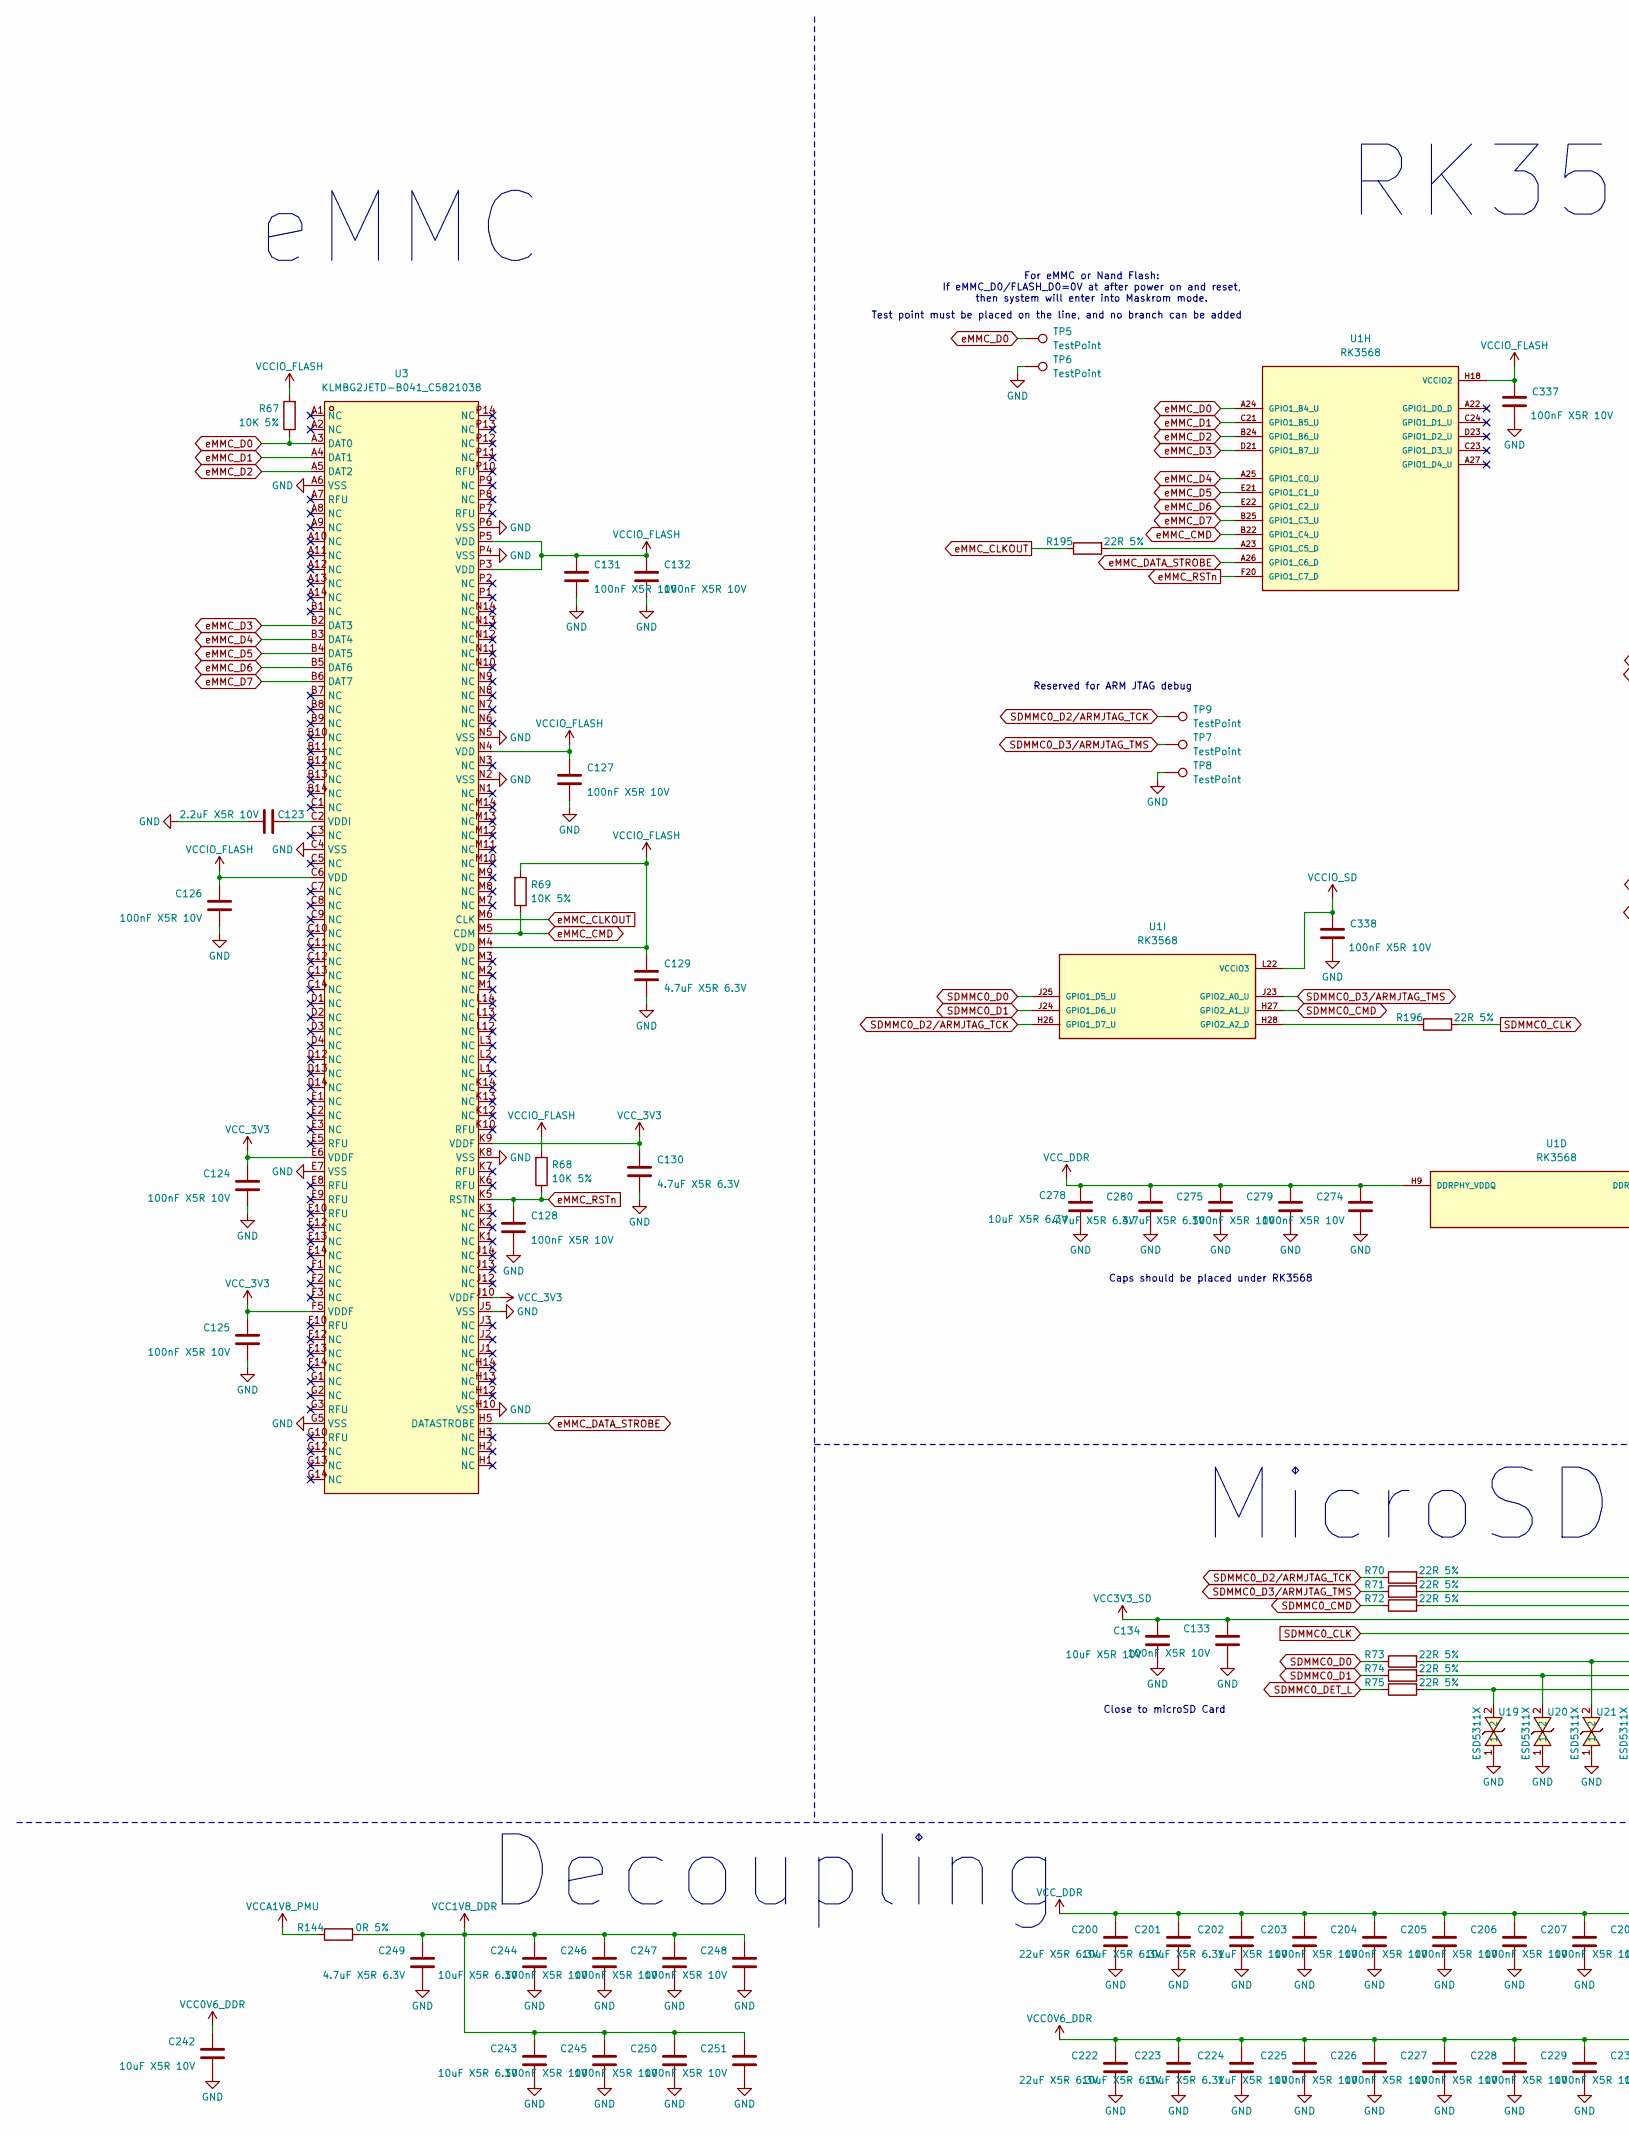
[picture p8: schematic memory_storage.kicad_sch, part in row 1, column 1]

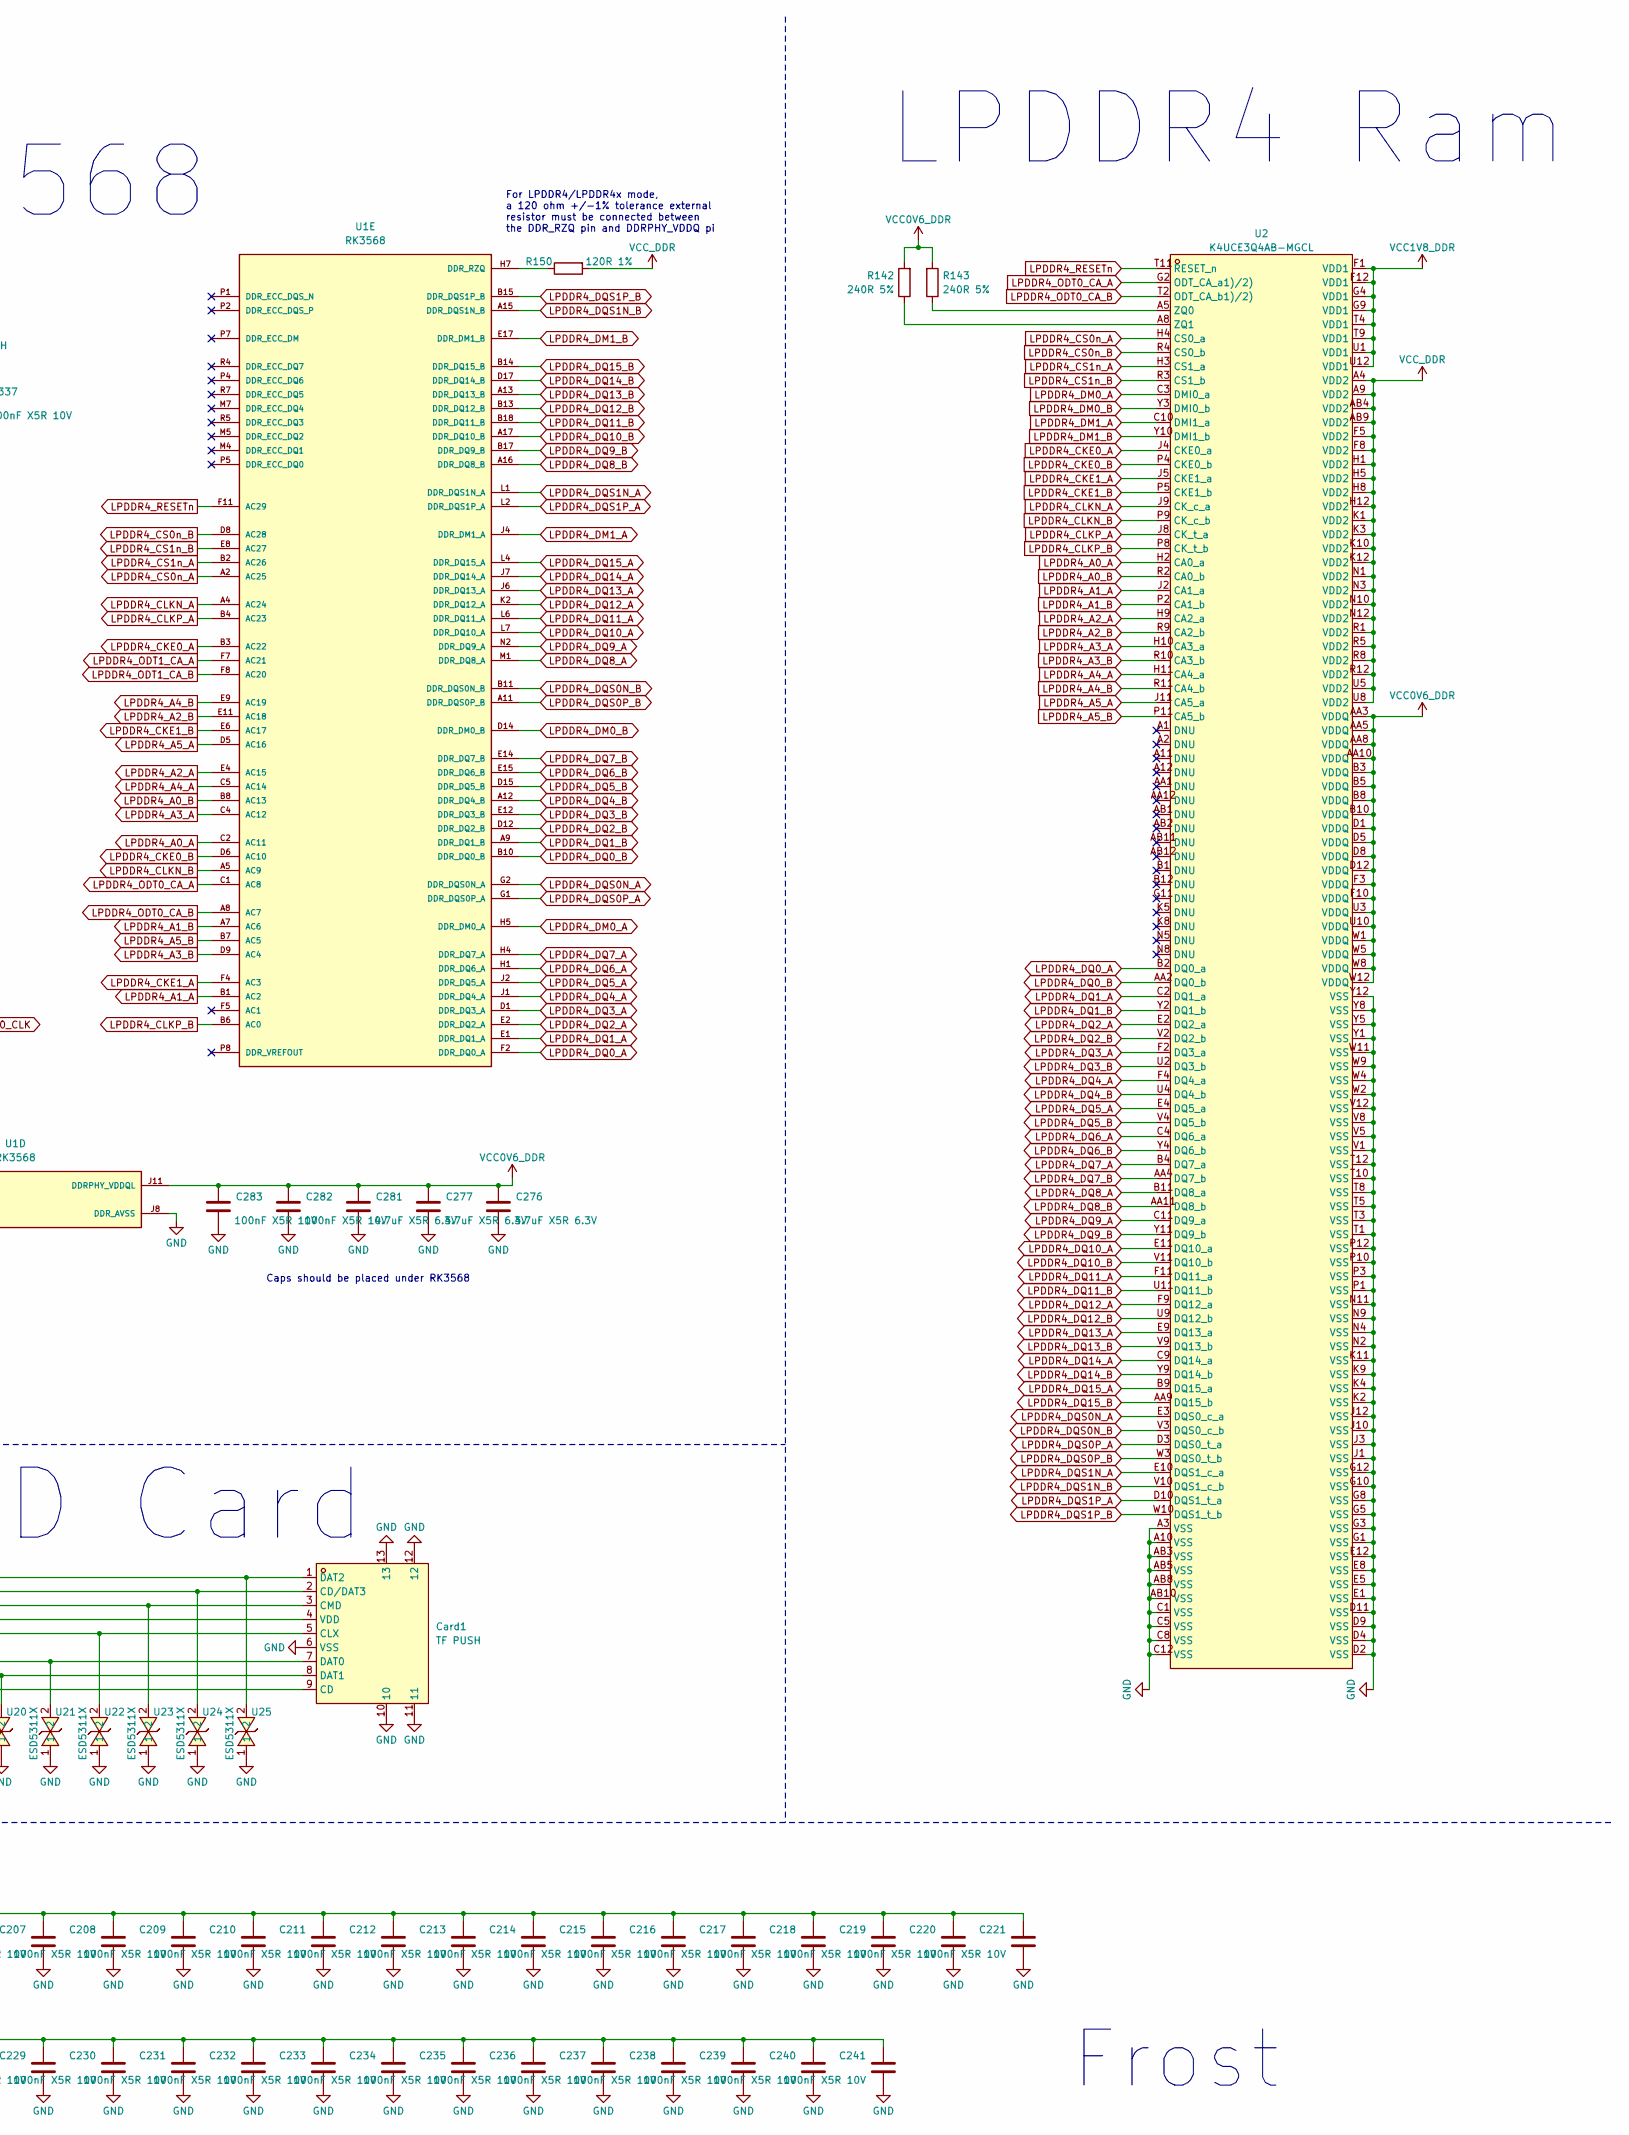
[picture p9: schematic memory_storage.kicad_sch, part in row 1, column 2]

Parts:
C123: 2.2uF X5R 10V; C_0402_1005Metric
C124, C125, C126, C127, C128, C131, C132, C133, C204, C205, C206, C207, C208, C209, C210, C211, C212, C213, C214, C215, C216, C217, C218, C219, C220, C221, C226, C227, C228, C229, C230, C231, C232, C233, C234, C235, C236, C237, C238, C239, C240, C241, C245, C246, C247, C248, C250, C251: 100nF X5R 10V; C_0402_1005Metric
C129, C130: 4.7uF X5R 6.3V; C_0603_1608Metric
C134, C242: 10uF X5R 10V; C_0603_1608Metric
C200, C222: 22uF X5R 6.3V; C_0603_1608Metric
C201, C202, C223, C224, C243, C244, C278: 10uF X5R 6.3V; C_0603_1608Metric
C203, C225: 1uF X5R 10V; C_0402_1005Metric
C249, C275, C276, C277, C280, C281: 4.7uF X5R 6.3V; C_0402_1005Metric
C274, C279, C282, C283, C337, C338: 100nF X5R 10V; C_0201_0603Metric
Card1: TF PUSH; TF-SMD_TF-PUSH; LCSC Part C393941
R67, R68, R69: 10K 5%; R_0402_1005Metric
R70, R71, R72, R73, R74, R75, R195, R196: 22R 5%; R_0402_1005Metric
R142, R143: 240R 5%; R_0402_1005Metric
R144: 0R 5%; R_0201_0603Metric
R150: 120R 1%; R_0201_0603Metric
TP5, TP6, TP7, TP8, TP9: TestPoint; TestPoint_Pad_D1.0mm
U1: RK3568; BGA636C65P28X28_1900X1900X168; PARTREV 1.3; LCSC C3345225
U2: K4UCE3Q4AB-MGCL; FBGA-200_L15.0-W10.0-BL_RS512M32LO4D1BDS-53BT; LCSC Part C29073172
U3: KLMBG2JETD-B041_C5821038; BGA-153_L13.0-W11.5-P0.50-TL_KLM8G1GEME-B041; LCSC Part C5821038
U19, U20, U21, U22, U23, U24, U25: ESD5311X; DFN1006-2L-BI; LCSC Part C2844730

Connections:
LPDDR4_A0_A: U1.C2 (AC11), U2.H2 (CA0_a)
LPDDR4_A0_B: U1.B8 (AC13), U2.R2 (CA0_b)
LPDDR4_A1_A: U1.B1 (AC2), U2.J2 (CA1_a)
LPDDR4_A1_B: U1.A7 (AC6), U2.P2 (CA1_b)
LPDDR4_A2_A: U1.E4 (AC15), U2.H9 (CA2_a)
LPDDR4_A2_B: U1.E11 (AC18), U2.R9 (CA2_b)
LPDDR4_A3_A: U1.C4 (AC12), U2.H10 (CA3_a)
LPDDR4_A3_B: U1.D9 (AC4), U2.R10 (CA3_b)
LPDDR4_A4_A: U1.C5 (AC14), U2.H11 (CA4_a)
LPDDR4_A4_B: U1.E9 (AC19), U2.R11 (CA4_b)
LPDDR4_A5_A: U1.D5 (AC16), U2.J11 (CA5_a)
LPDDR4_A5_B: U1.B7 (AC5), U2.P11 (CA5_b)
LPDDR4_CKE0_A: U1.B3 (AC22), U2.J4 (CKE0_a)
LPDDR4_CKE0_B: U1.D6 (AC10), U2.P4 (CKE0_b)
LPDDR4_CKE1_A: U1.F4 (AC3), U2.J5 (CKE1_a)
LPDDR4_CKE1_B: U1.E6 (AC17), U2.P5 (CKE1_b)
LPDDR4_CLKN_A: U1.A4 (AC24), U2.J9 (CK_c_a)
LPDDR4_CLKN_B: U1.A5 (AC9), U2.P9 (CK_c_b)
LPDDR4_CLKP_A: U1.B4 (AC23), U2.J8 (CK_t_a)
LPDDR4_CLKP_B: U1.B6 (AC0), U2.P8 (CK_t_b)
LPDDR4_CS0n_A: U1.A2 (AC25), U2.H4 (CS0_a)
LPDDR4_CS0n_B: U1.D8 (AC28), U2.R4 (CS0_b)
LPDDR4_CS1n_A: U1.B2 (AC26), U2.H3 (CS1_a)
LPDDR4_CS1n_B: U1.E8 (AC27), U2.R3 (CS1_b)
LPDDR4_DM0_A: U1.H5 (DDR_DM0_A), U2.C3 (DMI0_a)
LPDDR4_DM0_B: U1.D14 (DDR_DM0_B), U2.Y3 (DMI0_b)
LPDDR4_DM1_A: U1.J4 (DDR_DM1_A), U2.C10 (DMI1_a)
LPDDR4_DM1_B: U1.E17 (DDR_DM1_B), U2.Y10 (DMI1_b)
LPDDR4_DQ0_A: U1.F2 (DDR_DQ0_A), U2.B2 (DQ0_a)
LPDDR4_DQ0_B: U1.B10 (DDR_DQ0_B), U2.AA2 (DQ0_b)
LPDDR4_DQ1_A: U1.E1 (DDR_DQ1_A), U2.C2 (DQ1_a)
LPDDR4_DQ1_B: U1.A9 (DDR_DQ1_B), U2.Y2 (DQ1_b)
LPDDR4_DQ2_A: U1.E2 (DDR_DQ2_A), U2.E2 (DQ2_a)
LPDDR4_DQ2_B: U1.D12 (DDR_DQ2_B), U2.V2 (DQ2_b)
LPDDR4_DQ3_A: U1.D1 (DDR_DQ3_A), U2.F2 (DQ3_a)
LPDDR4_DQ3_B: U1.E12 (DDR_DQ3_B), U2.U2 (DQ3_b)
LPDDR4_DQ4_A: U1.J1 (DDR_DQ4_A), U2.F4 (DQ4_a)
LPDDR4_DQ4_B: U1.A12 (DDR_DQ4_B), U2.U4 (DQ4_b)
LPDDR4_DQ5_A: U1.J2 (DDR_DQ5_A), U2.E4 (DQ5_a)
LPDDR4_DQ5_B: U1.D15 (DDR_DQ5_B), U2.V4 (DQ5_b)
LPDDR4_DQ6_A: U1.H1 (DDR_DQ6_A), U2.C4 (DQ6_a)
LPDDR4_DQ6_B: U1.E15 (DDR_DQ6_B), U2.Y4 (DQ6_b)
LPDDR4_DQ7_A: U1.H4 (DDR_DQ7_A), U2.B4 (DQ7_a)
LPDDR4_DQ7_B: U1.E14 (DDR_DQ7_B), U2.AA4 (DQ7_b)
LPDDR4_DQ8_A: U1.M1 (DDR_DQ8_A), U2.B11 (DQ8_a)
LPDDR4_DQ8_B: U1.A16 (DDR_DQ8_B), U2.AA11 (DQ8_b)
LPDDR4_DQ9_A: U1.N2 (DDR_DQ9_A), U2.C11 (DQ9_a)
LPDDR4_DQ9_B: U1.B17 (DDR_DQ9_B), U2.Y11 (DQ9_b)
LPDDR4_DQ10_A: U1.L7 (DDR_DQ10_A), U2.E11 (DQ10_a)
LPDDR4_DQ10_B: U1.A17 (DDR_DQ10_B), U2.V11 (DQ10_b)
LPDDR4_DQ11_A: U1.L6 (DDR_DQ11_A), U2.F11 (DQ11_a)
LPDDR4_DQ11_B: U1.B18 (DDR_DQ11_B), U2.U11 (DQ11_b)
LPDDR4_DQ12_A: U1.K2 (DDR_DQ12_A), U2.F9 (DQ12_a)
LPDDR4_DQ12_B: U1.B13 (DDR_DQ12_B), U2.U9 (DQ12_b)
LPDDR4_DQ13_A: U1.J6 (DDR_DQ13_A), U2.E9 (DQ13_a)
LPDDR4_DQ13_B: U1.A13 (DDR_DQ13_B), U2.V9 (DQ13_b)
LPDDR4_DQ14_A: U1.J7 (DDR_DQ14_A), U2.C9 (DQ14_a)
LPDDR4_DQ14_B: U1.D17 (DDR_DQ14_B), U2.Y9 (DQ14_b)
LPDDR4_DQ15_A: U1.L4 (DDR_DQ15_A), U2.B9 (DQ15_a)
LPDDR4_DQ15_B: U1.B14 (DDR_DQ15_B), U2.AA9 (DQ15_b)
LPDDR4_DQS0N_A: U1.G2 (DDR_DQS0N_A), U2.E3 (DQS0_c_a)
LPDDR4_DQS0N_B: U1.B11 (DDR_DQS0N_B), U2.V3 (DQS0_c_b)
LPDDR4_DQS0P_A: U1.G1 (DDR_DQS0P_A), U2.D3 (DQS0_t_a)
LPDDR4_DQS0P_B: U1.A11 (DDR_DQS0P_B), U2.W3 (DQS0_t_b)
LPDDR4_DQS1N_A: U1.L1 (DDR_DQS1N_A), U2.E10 (DQS1_c_a)
LPDDR4_DQS1N_B: U1.A15 (DDR_DQS1N_B), U2.V10 (DQS1_c_b)
LPDDR4_DQS1P_A: U1.L2 (DDR_DQS1P_A), U2.D10 (DQS1_t_a)
LPDDR4_DQS1P_B: U1.B15 (DDR_DQS1P_B), U2.W10 (DQS1_t_b)
LPDDR4_ODT0_CA_A: U1.C1 (AC8), U2.G2 (ODT_CA_a1)/2))
LPDDR4_ODT0_CA_B: U1.A8 (AC7), U2.T2 (ODT_CA_b1)/2))
LPDDR4_ODT1_CA_A: U1.F7 (AC21)
LPDDR4_ODT1_CA_B: U1.F8 (AC20)
LPDDR4_RESETn: U1.F11 (AC29), U2.T11 (RESET_n)
unnamed: Card1.9 (CD), R75.2, U19.2
unnamed: Card1.2 (CD/DAT3), R71.2, U24.2
unnamed: Card1.3 (CMD), R72.2, U23.2
unnamed: Card1.7 (DAT0), R73.2, U21.2
unnamed: Card1.8 (DAT1), R74.2, U20.2
unnamed: Card1.1 (DAT2), R70.2, U25.2
unnamed: R150.1, U1.H7 (DDR_RZQ)
unnamed: R195.2, U1.A23 (GPIO1_C5_D)
unnamed: R196.1, U1.H28 (GPIO2_A2_D)
unnamed: R143.1, U2.A5 (ZQ0)
unnamed: R142.1, U2.A8 (ZQ1)
unnamed: C123.1, U3.C2 (VDDI)
SDMMC0_CLK: Card1.5 (CLX), R196.2, U22.2
SDMMC0_CMD: R72.1, U1.H27 (GPIO2_A1_U)
SDMMC0_D0: R73.1, U1.J25 (GPIO1_D5_U)
SDMMC0_D1: R74.1, U1.J24 (GPIO1_D6_U)
SDMMC0_D2/ARMJTAG_TCK: R70.1, TP9.1, U1.H26 (GPIO1_D7_U)
SDMMC0_D3/ARMJTAG_TMS: R71.1, TP7.1, U1.J23 (GPIO2_A0_U)
SDMMC0_DET_L: R75.1; also elsewhere on the board
VCC0V6_DDR: C222.1, C223.1, C224.1, C225.1, C226.1, C227.1, C228.1, C229.1, C230.1, C231.1, C232.1, C233.1, C234.1, C235.1, C236.1, C237.1, C238.1, C239.1, C240.1, C241.1, C242.1, C276.1, C277.1, C281.1, C282.1, C283.1, R142.2, R143.2, U1.J11 (DDRPHY_VDDQL), U1.J12 (DDRPHY_VDDQL), U1.J14 (DDRPHY_VDDQL), U1.K10 (DDRPHY_VDDQL), U1.L10 (DDRPHY_VDDQL), U1.M10 (DDRPHY_VDDQL), U2.AA3 (VDDQ), U2.AA5 (VDDQ), U2.AA8 (VDDQ), U2.AA10 (VDDQ), U2.B3 (VDDQ), U2.B5 (VDDQ), U2.B8 (VDDQ), U2.B10 (VDDQ), U2.D1 (VDDQ), U2.D5 (VDDQ), U2.D8 (VDDQ), U2.D12 (VDDQ), U2.F3 (VDDQ), U2.F10 (VDDQ), U2.U3 (VDDQ), U2.U10 (VDDQ), U2.W1 (VDDQ), U2.W5 (VDDQ), U2.W8 (VDDQ), U2.W12 (VDDQ)
VCC1V8_DDR: C243.1, C244.1, C245.1, C246.1, C247.1, C248.1, C249.1, C250.1, C251.1, R144.2, U2.F1 (VDD1), U2.F12 (VDD1), U2.G4 (VDD1), U2.G9 (VDD1), U2.T4 (VDD1), U2.T9 (VDD1), U2.U1 (VDD1), U2.U12 (VDD1)
VCC3V3_SD: C133.1, C134.1, Card1.4 (VDD); also elsewhere on the board
VCCA1V8_PMU: R144.1; also elsewhere on the board
VCCIO_FLASH: C126.1, C127.1, C129.1, C131.1, C132.1, C337.1, R67.2, R68.2, R69.2, U1.H18 (VCCIO2), U3.C6 (VDD), U3.M4 (VDD), U3.N4 (VDD), U3.P3 (VDD), U3.P5 (VDD); also elsewhere on the board
VCCIO_SD: C338.1, U1.L22 (VCCIO3); also elsewhere on the board
VCC_3V3: C124.1, C125.1, C130.1, U3.E6 (VDDF), U3.F5 (VDDF), U3.J10 (VDDF), U3.K9 (VDDF); also elsewhere on the board
VCC_DDR: C200.1, C201.1, C202.1, C203.1, C204.1, C205.1, C206.1, C207.1, C208.1, C209.1, C210.1, C211.1, C212.1, C213.1, C214.1, C215.1, C216.1, C217.1, C218.1, C219.1, C220.1, C221.1, C274.1, C275.1, C278.1, C279.1, C280.1, R150.2, U1.H9 (DDRPHY_VDDQ), U1.H11 (DDRPHY_VDDQ), U1.H12 (DDRPHY_VDDQ), U1.H14 (DDRPHY_VDDQ), U1.H15 (DDRPHY_VDDQ), U1.J9 (DDRPHY_VDDQ), U1.L9 (DDRPHY_VDDQ), U1.M9 (DDRPHY_VDDQ), U2.A4 (VDD2), U2.A9 (VDD2), U2.AB4 (VDD2), U2.AB9 (VDD2), U2.F5 (VDD2), U2.F8 (VDD2), U2.H1 (VDD2), U2.H5 (VDD2), U2.H8 (VDD2), U2.H12 (VDD2), U2.K1 (VDD2), U2.K3 (VDD2), U2.K10 (VDD2), U2.K12 (VDD2), U2.N1 (VDD2), U2.N3 (VDD2), U2.N10 (VDD2), U2.N12 (VDD2), U2.R1 (VDD2), U2.R5 (VDD2), U2.R8 (VDD2), U2.R12 (VDD2), U2.U5 (VDD2), U2.U8 (VDD2); also elsewhere on the board
eMMC_CLKOUT: R195.1, U3.M6 (CLK)
eMMC_CMD: R69.1, U1.B22 (GPIO1_C4_U), U3.M5 (CDM)
eMMC_D0: R67.1, TP5.1, U1.A24 (GPIO1_B4_U), U3.A3 (DAT0)
eMMC_D1: U1.C21 (GPIO1_B5_U), U3.A4 (DAT1)
eMMC_D2: U1.B24 (GPIO1_B6_U), U3.A5 (DAT2)
eMMC_D3: U1.D21 (GPIO1_B7_U), U3.B2 (DAT3)
eMMC_D4: U1.A25 (GPIO1_C0_U), U3.B3 (DAT4)
eMMC_D5: U1.E21 (GPIO1_C1_U), U3.B4 (DAT5)
eMMC_D6: U1.E22 (GPIO1_C2_U), U3.B5 (DAT6)
eMMC_D7: U1.B25 (GPIO1_C3_U), U3.B6 (DAT7)
eMMC_DATA_STROBE: U1.A26 (GPIO1_C6_D), U3.H5 (DATASTROBE)
eMMC_RSTn: C128.1, R68.1, U1.F20 (GPIO1_C7_D), U3.K5 (RSTN)

Notes on the sheet:
Caps should be placed under RK3568
Test point must be placed on the line, and no branch can be added
LPDDR4 Ram
Reserved for ARM JTAG debug
Close to microSD Card
Decoupling
For LPDDR4/LPDDR4x mode, a 120 ohm +/-1% tolerance external resistor must be connected between the DDR_RZQ pin and DDRPHY_VDDQ pi
For eMMC or Nand Flash: If eMMC_D0/FLASH_D0=0V at after power on and reset, then system will enter into Maskrom mode.
eMMC
MicroSD Card
Frost
RK3568

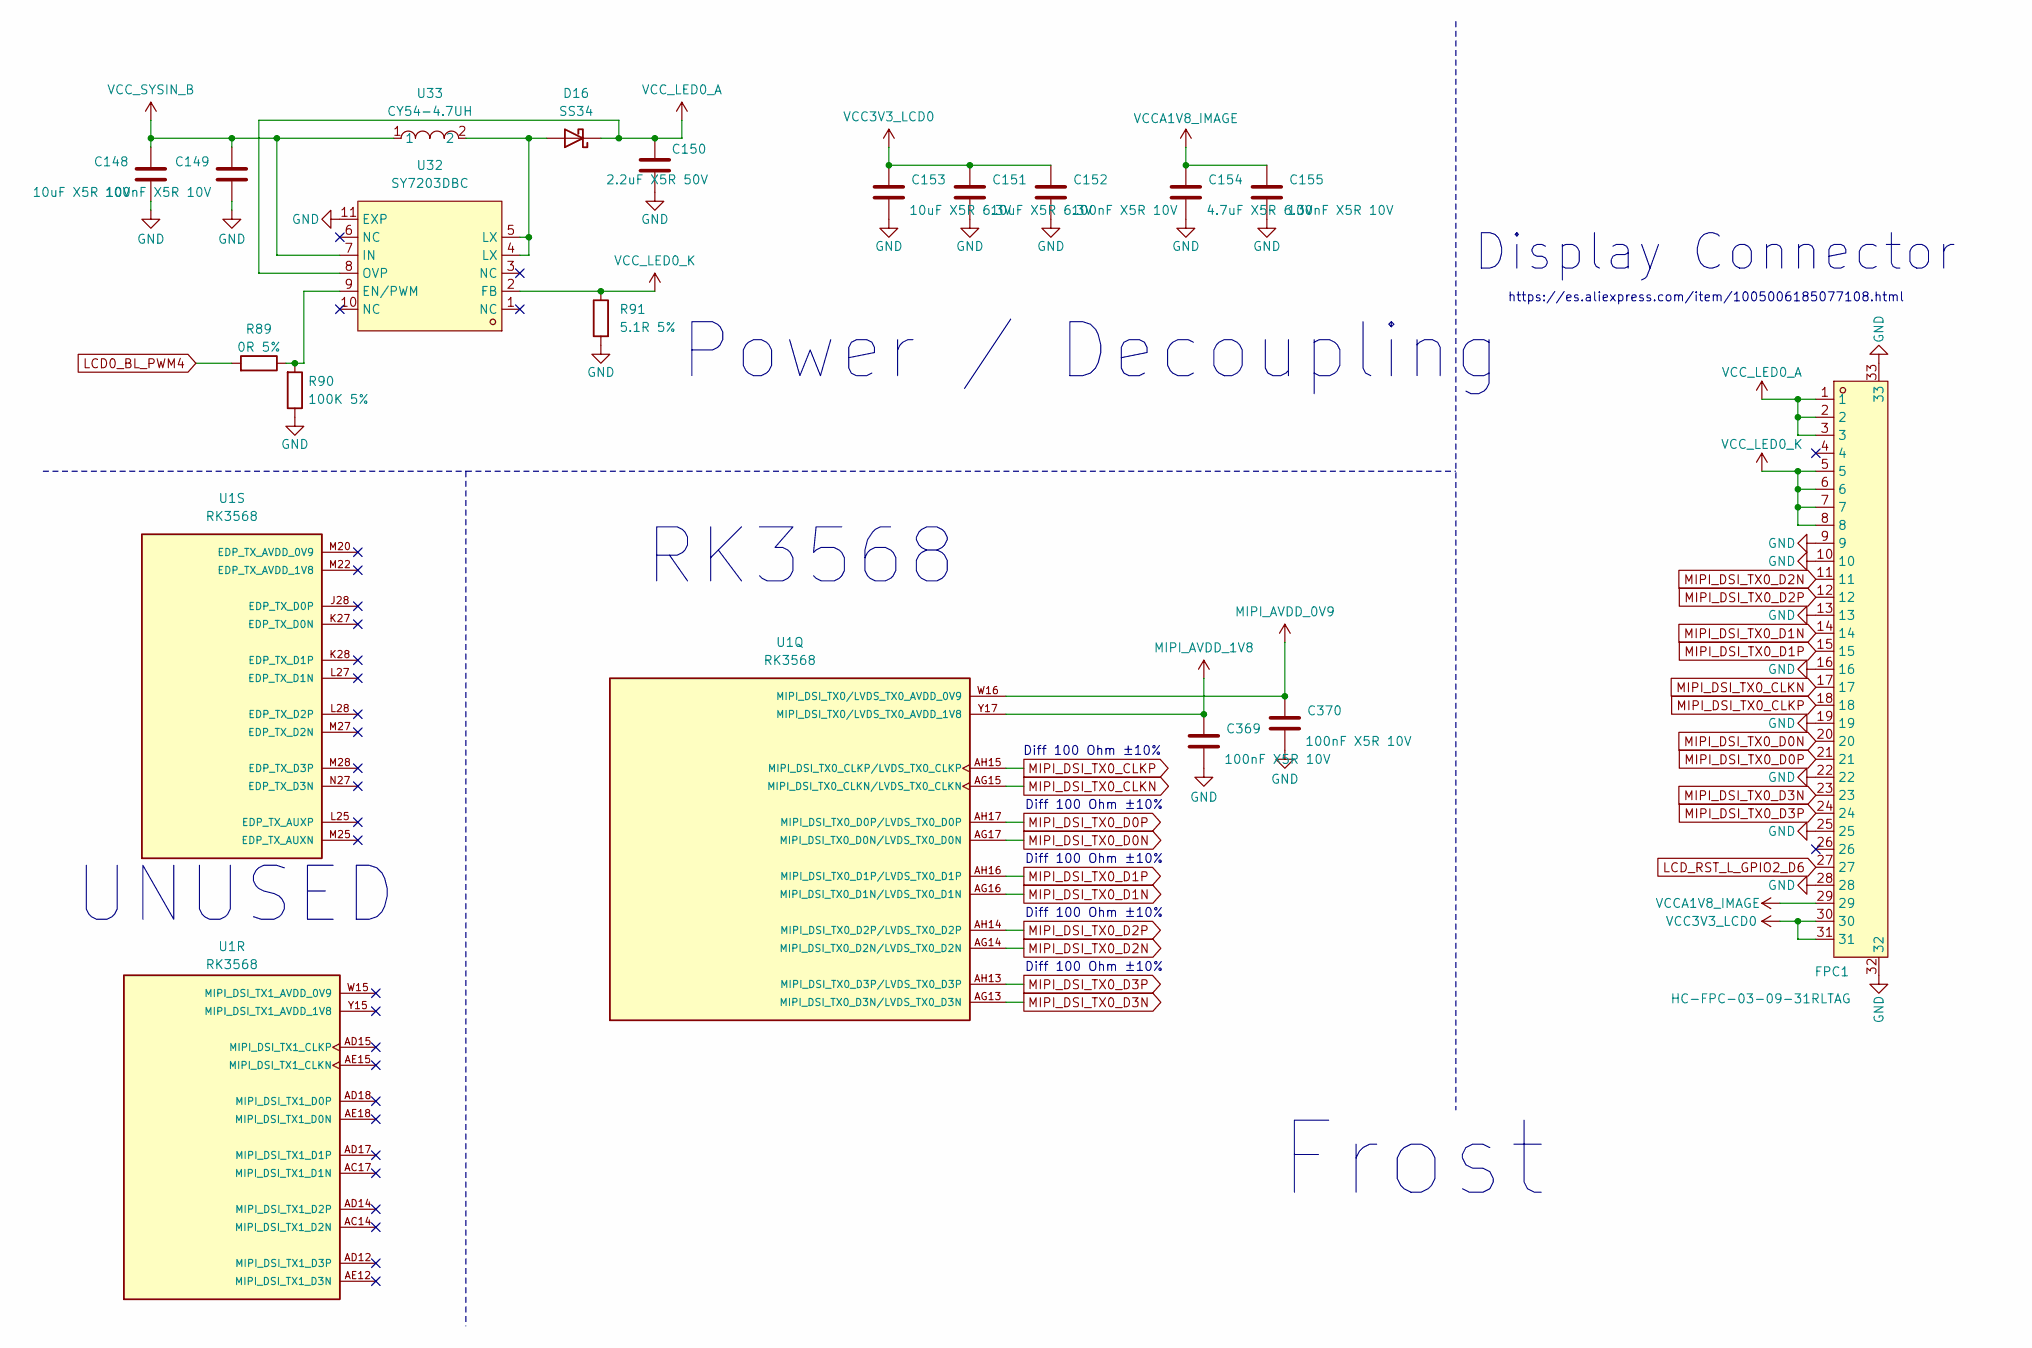
[picture p10: schematic display.kicad_sch]

Parts:
C148: 10uF X5R 10V; C_0603_1608Metric
C149, C152, C155: 100nF X5R 10V; C_0402_1005Metric
C150: 2.2uF X5R 50V; C_0805_2012Metric
C151, C153: 10uF X5R 6.3V; C_0603_1608Metric
C154: 4.7uF X5R 6.3V; C_0603_1608Metric
C369, C370: 100nF X5R 10V; C_0201_0603Metric
D16: SS34; D_SMA
FPC1: HC-FPC-03-09-31RLTAG; FPC-SMD_31P-P0.30_HC-FPC-03-09-31RLTAG; LCSC Part C5213720
R89: 0R 5%; R_0402_1005Metric
R90: 100K 5%; R_0402_1005Metric
R91: 5.1R 5%; R_1206_3216Metric
U1: RK3568; BGA636C65P28X28_1900X1900X168; PARTREV 1.3; LCSC C3345225
U32: SY7203DBC; DFN-10_L3.0-W3.0-P0.50-BL-EP2.4; LCSC Part C125894
U33: CY54-4.7UH; IND-SMD_L5.8-W5.2; LCSC Part C2929429

Connections:
LCD0_BL_PWM4: R89.2; also elsewhere on the board
LCD_RST_L_GPIO2_D6: FPC1.27; also elsewhere on the board
MIPI_AVDD_0V9: C370.1, U1.W16 (MIPI_DSI_TX0/LVDS_TX0_AVDD_0V9); also elsewhere on the board
MIPI_AVDD_1V8: C369.1, U1.Y17 (MIPI_DSI_TX0/LVDS_TX0_AVDD_1V8); also elsewhere on the board
MIPI_DSI_TX0_CLKN: FPC1.17, U1.AG15 (MIPI_DSI_TX0_CLKN/LVDS_TX0_CLKN)
MIPI_DSI_TX0_CLKP: FPC1.18, U1.AH15 (MIPI_DSI_TX0_CLKP/LVDS_TX0_CLKP)
MIPI_DSI_TX0_D0N: FPC1.20, U1.AG17 (MIPI_DSI_TX0_D0N/LVDS_TX0_D0N)
MIPI_DSI_TX0_D0P: FPC1.21, U1.AH17 (MIPI_DSI_TX0_D0P/LVDS_TX0_D0P)
MIPI_DSI_TX0_D1N: FPC1.14, U1.AG16 (MIPI_DSI_TX0_D1N/LVDS_TX0_D1N)
MIPI_DSI_TX0_D1P: FPC1.15, U1.AH16 (MIPI_DSI_TX0_D1P/LVDS_TX0_D1P)
MIPI_DSI_TX0_D2N: FPC1.11, U1.AG14 (MIPI_DSI_TX0_D2N/LVDS_TX0_D2N)
MIPI_DSI_TX0_D2P: FPC1.12, U1.AH14 (MIPI_DSI_TX0_D2P/LVDS_TX0_D2P)
MIPI_DSI_TX0_D3N: FPC1.23, U1.AG13 (MIPI_DSI_TX0_D3N/LVDS_TX0_D3N)
MIPI_DSI_TX0_D3P: FPC1.24, U1.AH13 (MIPI_DSI_TX0_D3P/LVDS_TX0_D3P)
unnamed: D16.2 (A), U32.4 (LX), U32.5 (LX), U33.2
unnamed: R89.1, R90.2, U32.9 (EN/PWM)
VCC3V3_LCD0: C151.1, C152.1, C153.1, FPC1.30, FPC1.31; also elsewhere on the board
VCCA1V8_IMAGE: C154.1, C155.1, FPC1.29; also elsewhere on the board
VCC_LED0_A: C150.1, D16.1 (K), FPC1.1, FPC1.2, FPC1.3, U32.8 (OVP)
VCC_LED0_K: FPC1.5, FPC1.6, FPC1.7, FPC1.8, R91.1, U32.2 (FB)
VCC_SYSIN: C148.1, C149.1, U32.7 (IN), U33.1; also elsewhere on the board

Notes on the sheet:
Diff 100 Ohm ±10%
Frost
RK3568
Power / Decoupling
Display Connector
UNUSED
https://es.aliexpress.com/item/1005006185077108.html

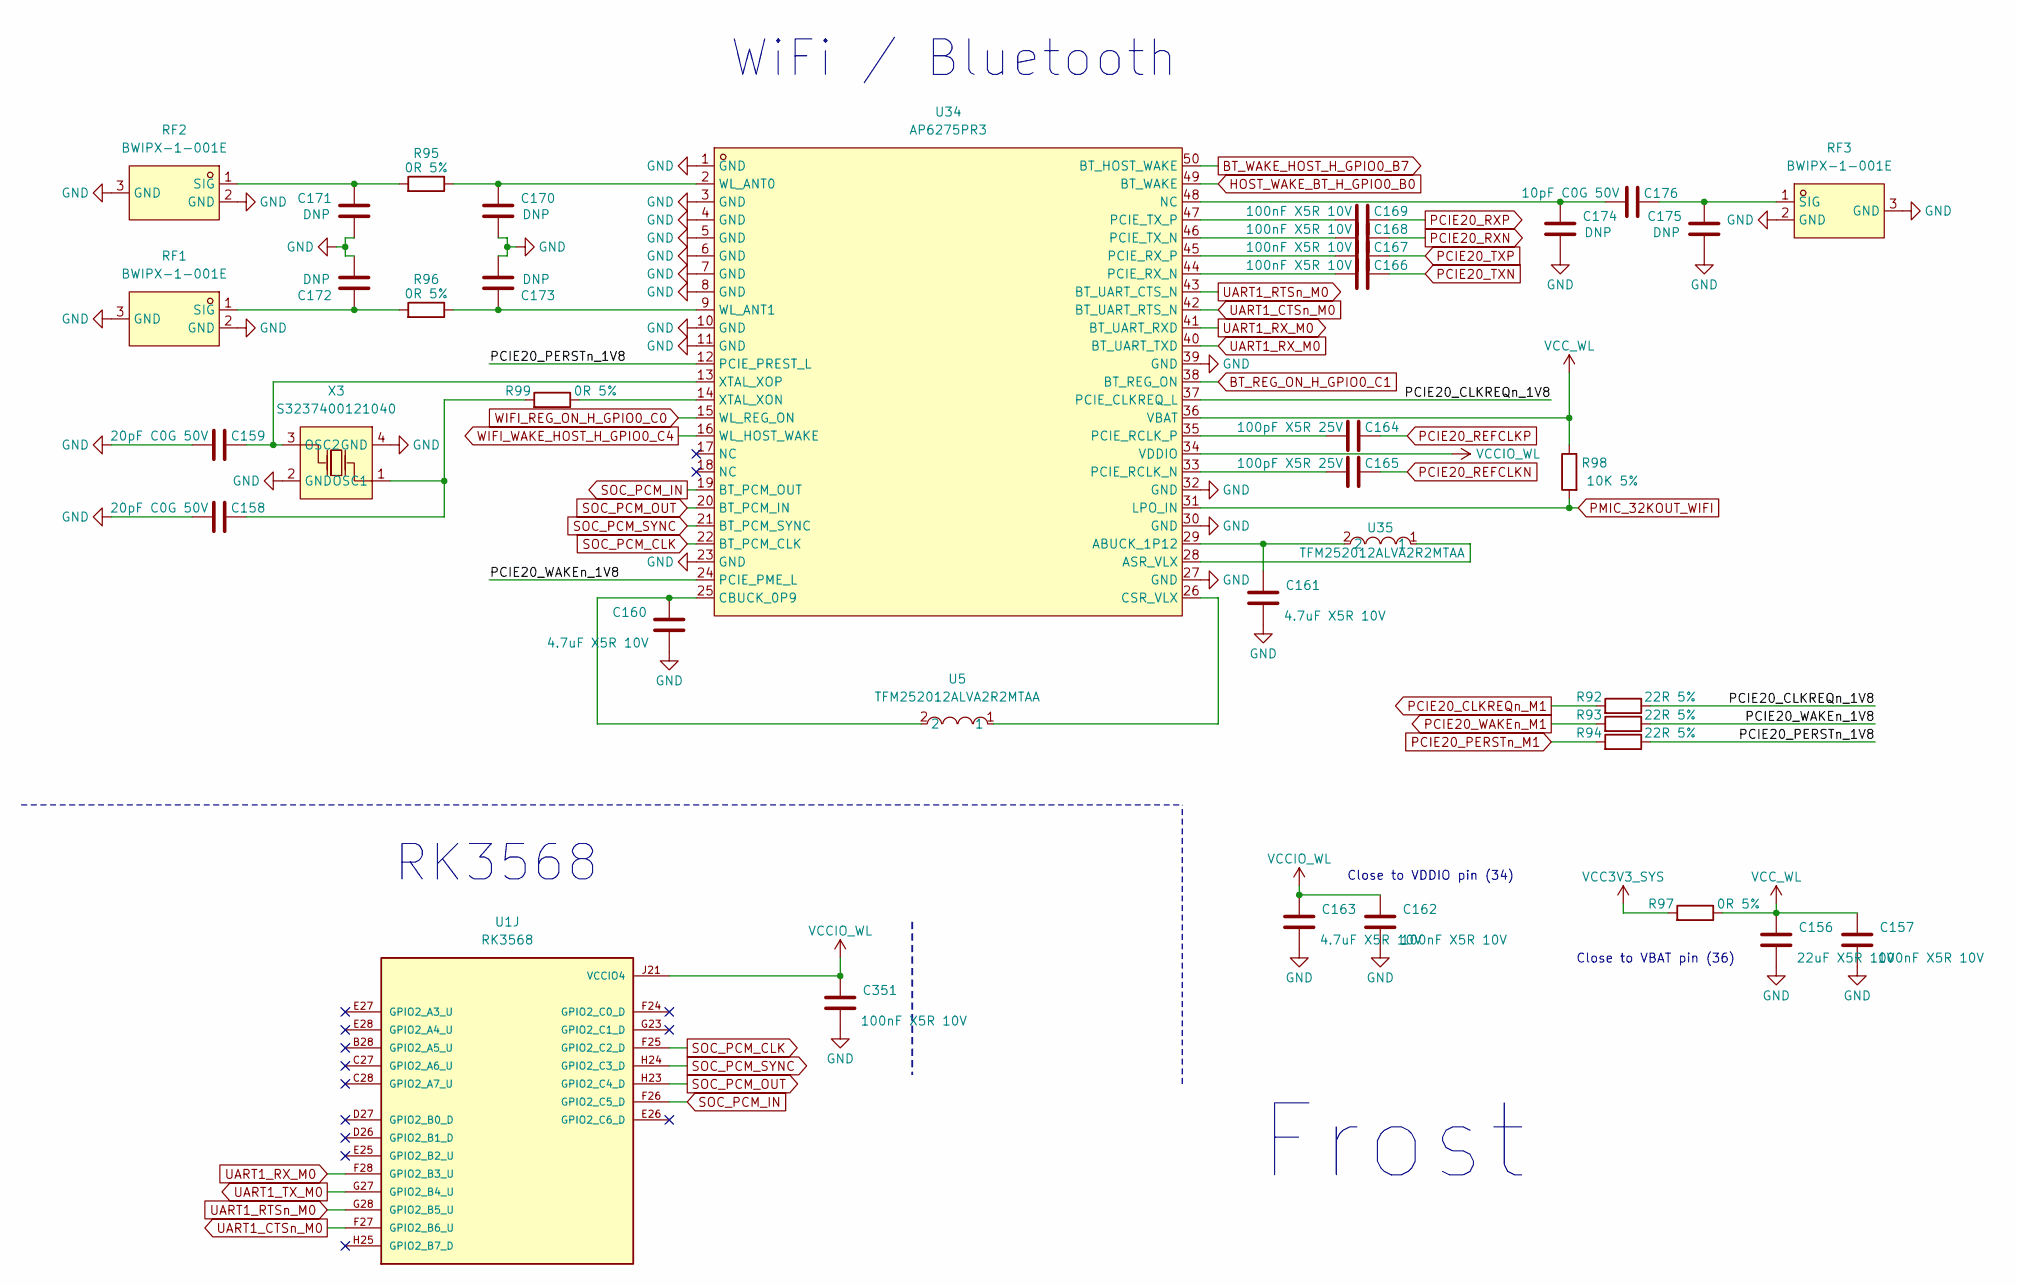
[picture p11: schematic wireless.kicad_sch]

Parts:
C156: 22uF X5R 10V; C_0805_2012Metric
C157, C162: 100nF X5R 10V; C_0402_1005Metric
C158, C159: 20pF C0G 50V; C_0402_1005Metric
C160, C161, C163: 4.7uF X5R 10V; C_0603_1608Metric
C164, C165: 100pF X5R 25V; C_0201_0603Metric
C166, C167, C168, C169, C351: 100nF X5R 10V; C_0201_0603Metric
C170, C171, C172, C173, C174, C175: DNP; C_0402_1005Metric
C176: 10pF C0G 50V; C_0201_0603Metric
R92, R93, R94: 22R 5%; R_0402_1005Metric
R95, R96, R97: 0R 5%; R_0603_1608Metric
R98: 10K 5%; R_0402_1005Metric
R99: 0R 5%; R_0402_1005Metric
RF1, RF2, RF3: BWIPX-1-001E; IPEX-SMD_BWIPX-1-001E; LCSC Part C496552
U1: RK3568; BGA636C65P28X28_1900X1900X168; PARTREV 1.3; LCSC C3345225
U5, U35: TFM252012ALVA2R2MTAA; L1008; LCSC Part C2047711
U34: AP6275PR3; WIRELM-SMD_AMPAK_AP6275P; LCSC Part C2984106
X3: S3237400121040; CRYSTAL-SMD_4P-L3.2-W2.5-BL; LCSC Part C426987

Connections:
/WiFi and Bluetooth/PCIE20_CLKREQn_1V8: R92.1, U34.37 (PCIE_CLKREQ_L)
/WiFi and Bluetooth/PCIE20_PERSTn_1V8: R94.1, U34.12 (PCIE_PREST_L)
/WiFi and Bluetooth/PCIE20_WAKEn_1V8: R93.1, U34.24 (PCIE_PME_L)
BT_REG_ON_H_GPIO0_C1: U34.38 (BT_REG_ON); also elsewhere on the board
BT_WAKE_HOST_H_GPIO0_B7: U34.50 (BT_HOST_WAKE); also elsewhere on the board
HOST_WAKE_BT_H_GPIO0_B0: U34.49 (BT_WAKE); also elsewhere on the board
unnamed: C174.1, C176.2, U34.48 (NC)
unnamed: C172.1, R96.2, RF1.1 (SIG)
unnamed: C171.1, R95.2, RF2.1 (SIG)
unnamed: C175.1, C176.1, RF3.1 (SIG)
unnamed: C161.1, U34.29 (ABUCK_1P12), U35.2
unnamed: U34.28 (ASR_VLX), U35.1
unnamed: C160.1, U5.2, U34.25 (CBUCK_0P9)
unnamed: U5.1, U34.26 (CSR_VLX)
unnamed: C165.2, U34.33 (PCIE_RCLK_N)
unnamed: C164.2, U34.35 (PCIE_RCLK_P)
unnamed: C166.2, U34.44 (PCIE_RX_N)
unnamed: C167.2, U34.45 (PCIE_RX_P)
unnamed: C168.2, U34.46 (PCIE_TX_N)
unnamed: C169.2, U34.47 (PCIE_TX_P)
unnamed: C170.1, R95.1, U34.2 (WL_ANT0)
unnamed: C173.1, R96.1, U34.9 (WL_ANT1)
unnamed: R99.1, U34.14 (XTAL_XON)
unnamed: C159.1, U34.13 (XTAL_XOP), X3.3 (OSC2)
unnamed: C158.1, R99.2, X3.1 (OSC1)
PCIE20_CLKREQn_M1: R92.2; also elsewhere on the board
PCIE20_PERSTn_M1: R94.2; also elsewhere on the board
PCIE20_REFCLKN: C165.1; also elsewhere on the board
PCIE20_REFCLKP: C164.1; also elsewhere on the board
PCIE20_RXN: C168.1; also elsewhere on the board
PCIE20_RXP: C169.1; also elsewhere on the board
PCIE20_TXN: C166.1; also elsewhere on the board
PCIE20_TXP: C167.1; also elsewhere on the board
PCIE20_WAKEn_M1: R93.2; also elsewhere on the board
PMIC_32KOUT_WIFI: R98.2, U34.31 (LPO_IN); also elsewhere on the board
SOC_PCM_CLK: U1.F25 (GPIO2_C2_D), U34.22 (BT_PCM_CLK)
SOC_PCM_IN: U1.F26 (GPIO2_C5_D), U34.19 (BT_PCM_OUT)
SOC_PCM_OUT: U1.H23 (GPIO2_C4_D), U34.20 (BT_PCM_IN)
SOC_PCM_SYNC: U1.H24 (GPIO2_C3_D), U34.21 (BT_PCM_SYNC)
UART1_CTSn_M0: U1.F27 (GPIO2_B6_U), U34.42 (BT_UART_RTS_N)
UART1_RTSn_M0: U1.G28 (GPIO2_B5_U), U34.43 (BT_UART_CTS_N)
UART1_RX_M0: U1.F28 (GPIO2_B3_U), U34.40 (BT_UART_TXD), U34.41 (BT_UART_RXD)
UART1_TX_M0: U1.G27 (GPIO2_B4_U)
VCC3V3_SYS: R97.2; also elsewhere on the board
VCCIO_WL: C162.1, C163.1, C351.1, U1.J21 (VCCIO4), U34.34 (VDDIO); also elsewhere on the board
VCC_WL: C156.1, C157.1, R97.1, R98.1, U34.36 (VBAT)
WIFI_REG_ON_H_GPIO0_C0: U34.15 (WL_REG_ON); also elsewhere on the board
WIFI_WAKE_HOST_H_GPIO0_C4: U34.16 (WL_HOST_WAKE); also elsewhere on the board

Notes on the sheet:
Close to VBAT pin (36)
WiFi / Bluetooth
Close to VDDIO pin (34)
Frost
RK3568
