notaroomba/frost/hardware/board/frost.kicad_pcb

## KiCad design hardware/board/frost.kicad_pcb (continued)

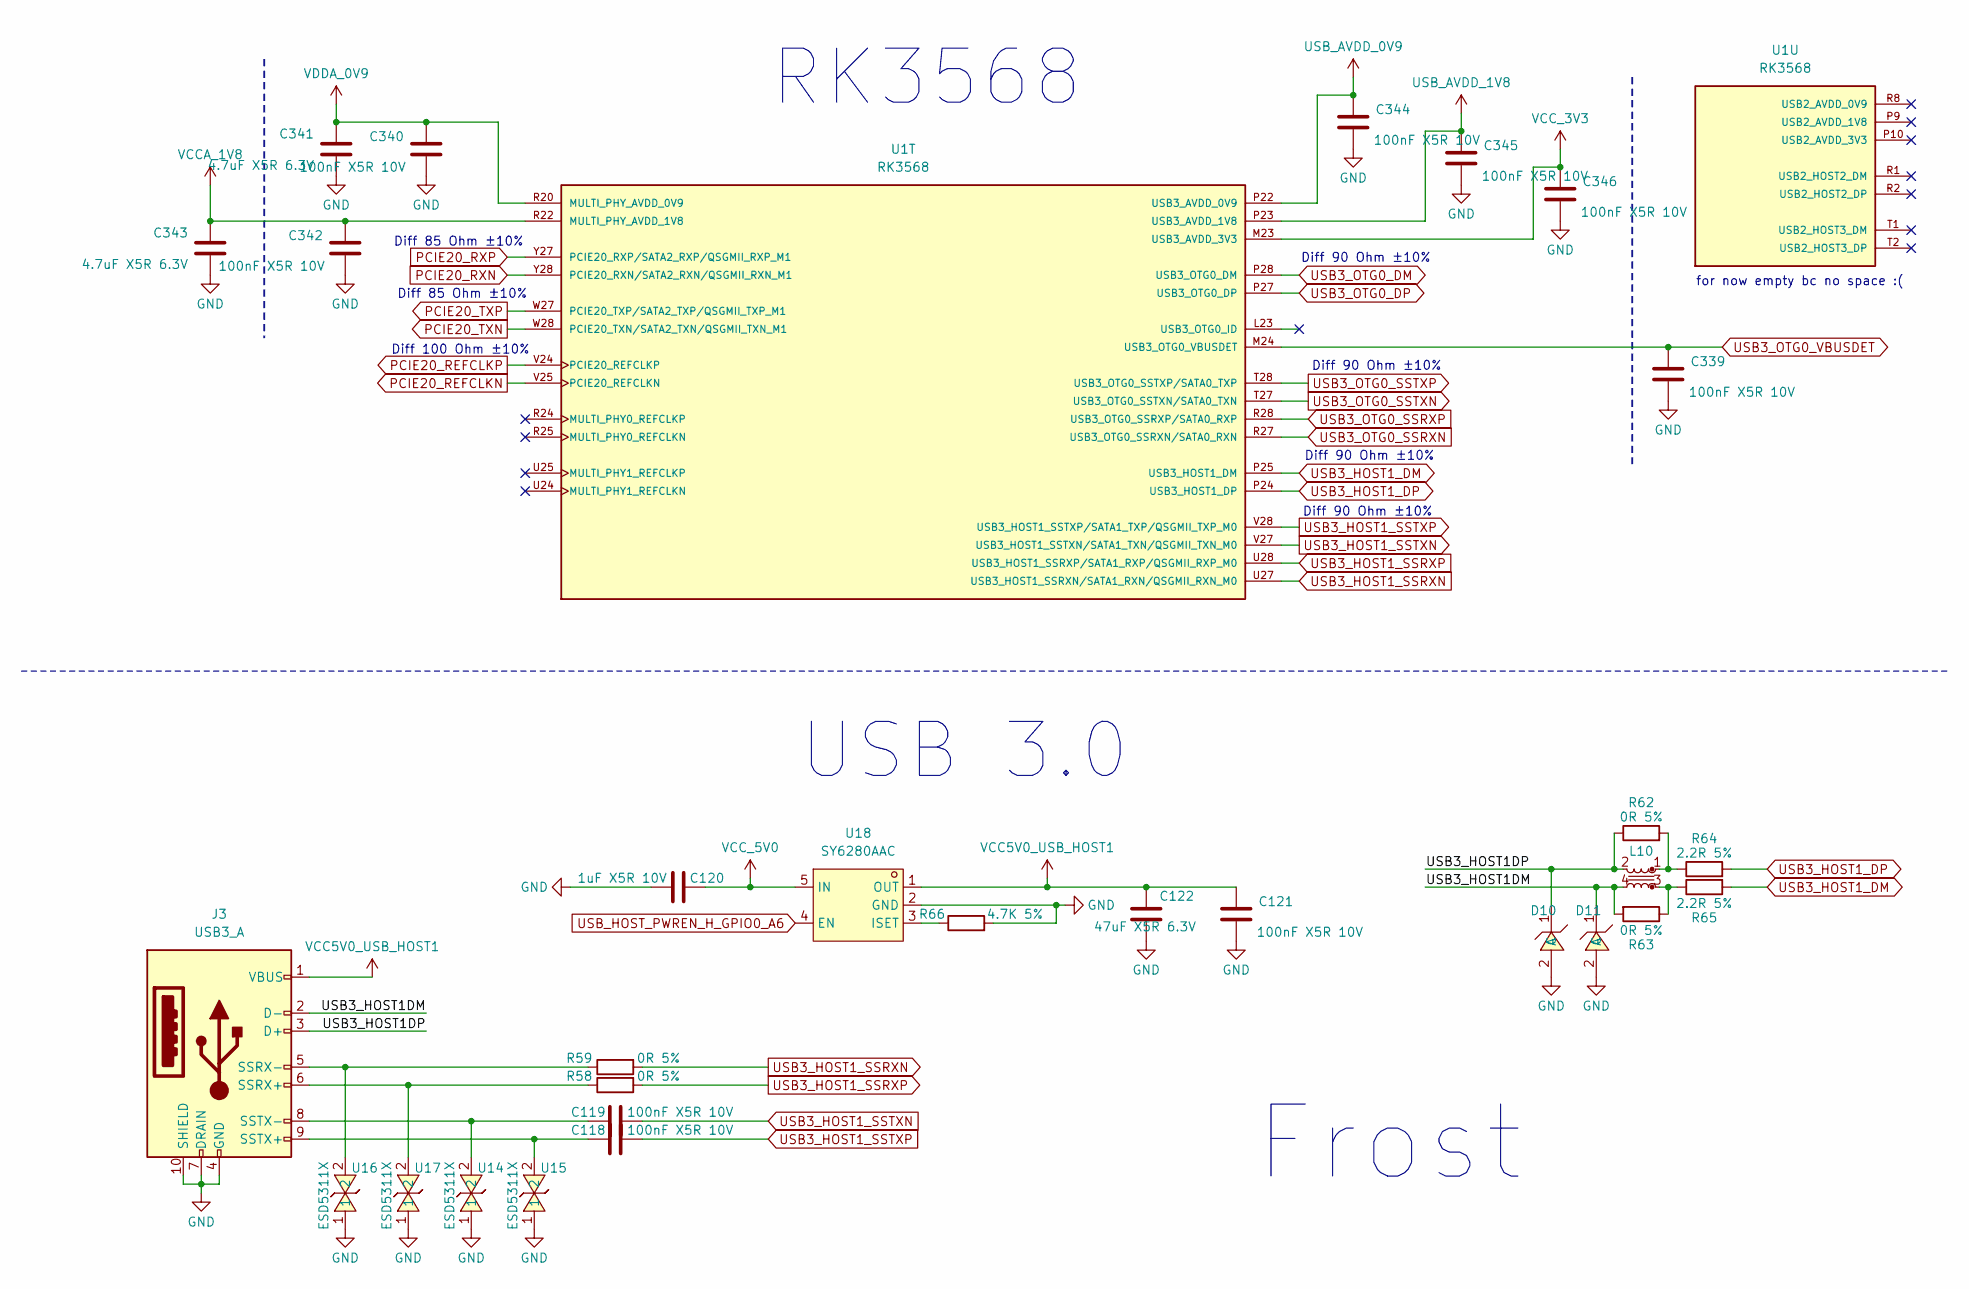
[picture p12: schematic usb.kicad_sch]

Parts:
C118, C119, C340, C342, C344, C345, C346: 100nF X5R 10V; C_0201_0603Metric
C120: 1uF X5R 10V; C_0402_1005Metric
C121, C339: 100nF X5R 10V; C_0402_1005Metric
C122: 47uF X5R 6.3V; C_0805_2012Metric
C341, C343: 4.7uF X5R 6.3V; C_0402_1005Metric
D10, D11: BZT52C5V1_C173407; SOD-123_L2.7-W1.6-LS3.7-RD; LCSC Part C173407
J3: USB3_A; USB-A-SMD_U-A-39SS-W-1
L10: L_Iron_Coupled_Small; FILTER-SMD_4P-L2.0-W1.2-BL_DLW21H
R58, R59: 0R 5%; R_0201_0603Metric
R62, R63: 0R 5%; R_0402_1005Metric
R64, R65: 2.2R 5%; R_0402_1005Metric
R66: 4.7K 5%; R_0402_1005Metric
U1: RK3568; BGA636C65P28X28_1900X1900X168; PARTREV 1.3; LCSC C3345225
U14, U15, U16, U17: ESD5311X; DFN1006-2L-BI; LCSC Part C2844730
U18: SY6280AAC; SOT-23-5_L3.0-W1.7-P0.95-LS2.8-BL; LCSC Part C55136

Connections:
/USB/USB3_HOST1DM: D11.1 (C), J3.2 (D-), L10.4, R63.2
/USB/USB3_HOST1DP: D10.1 (C), J3.3 (D+), L10.2, R62.1
unnamed: J3.6 (SSRX+), R58.1, U17.2
unnamed: J3.5 (SSRX-), R59.1, U16.2
unnamed: C118.1, J3.9 (SSTX+), U15.2
unnamed: C119.1, J3.8 (SSTX-), U14.2
unnamed: L10.1, R62.2, R64.1
unnamed: L10.3, R63.1, R65.1
unnamed: R66.1, U18.3 (ISET)
PCIE20_REFCLKN: U1.V25 (PCIE20_REFCLKN); also elsewhere on the board
PCIE20_REFCLKP: U1.V24 (PCIE20_REFCLKP); also elsewhere on the board
PCIE20_RXN: U1.Y28 (PCIE20_RXN/SATA2_RXN/QSGMII_RXN_M1); also elsewhere on the board
PCIE20_RXP: U1.Y27 (PCIE20_RXP/SATA2_RXP/QSGMII_RXP_M1); also elsewhere on the board
PCIE20_TXN: U1.W28 (PCIE20_TXN/SATA2_TXN/QSGMII_TXN_M1); also elsewhere on the board
PCIE20_TXP: U1.W27 (PCIE20_TXP/SATA2_TXP/QSGMII_TXP_M1); also elsewhere on the board
USB3_HOST1_DM: R65.2, U1.P25 (USB3_HOST1_DM)
USB3_HOST1_DP: R64.2, U1.P24 (USB3_HOST1_DP)
USB3_HOST1_SSRXN: R59.2, U1.U27 (USB3_HOST1_SSRXN/SATA1_RXN/QSGMII_RXN_M0)
USB3_HOST1_SSRXP: R58.2, U1.U28 (USB3_HOST1_SSRXP/SATA1_RXP/QSGMII_RXP_M0)
USB3_HOST1_SSTXN: C119.2, U1.V27 (USB3_HOST1_SSTXN/SATA1_TXN/QSGMII_TXN_M0)
USB3_HOST1_SSTXP: C118.2, U1.V28 (USB3_HOST1_SSTXP/SATA1_TXP/QSGMII_TXP_M0)
USB3_OTG0_DM: U1.P28 (USB3_OTG0_DM); also elsewhere on the board
USB3_OTG0_DP: U1.P27 (USB3_OTG0_DP); also elsewhere on the board
USB3_OTG0_SSRXN: U1.R27 (USB3_OTG0_SSRXN/SATA0_RXN); also elsewhere on the board
USB3_OTG0_SSRXP: U1.R28 (USB3_OTG0_SSRXP/SATA0_RXP); also elsewhere on the board
USB3_OTG0_SSTXN: U1.T27 (USB3_OTG0_SSTXN/SATA0_TXN); also elsewhere on the board
USB3_OTG0_SSTXP: U1.T28 (USB3_OTG0_SSTXP/SATA0_TXP); also elsewhere on the board
USB3_OTG0_VBUSDET: C339.1, U1.M24 (USB3_OTG0_VBUSDET); also elsewhere on the board
USB_AVDD_0V9: C344.1, U1.P22 (USB3_AVDD_0V9); also elsewhere on the board
USB_AVDD_1V8: C345.1, U1.P23 (USB3_AVDD_1V8); also elsewhere on the board
USB_HOST_PWREN_H_GPIO0_A6: U18.4 (EN); also elsewhere on the board
VCC5V0_USB_HOST1: C121.1, C122.2, J3.1 (VBUS), U18.1 (OUT)
VCCA_1V8: C342.1, C343.1, U1.R22 (MULTI_PHY_AVDD_1V8); also elsewhere on the board
VCC_3V3: C346.1, U1.M23 (USB3_AVDD_3V3); also elsewhere on the board
VCC_5V0: C120.2, U18.5 (IN); also elsewhere on the board
VDDA_0V9: C340.1, C341.1, U1.R20 (MULTI_PHY_AVDD_0V9), U1.R21 (MULTI_PHY_AVDD_0V9); also elsewhere on the board

Notes on the sheet:
Frost
Diff 85 Ohm ±10%
for now empty bc no space :(
Diff 90 Ohm ±10%
USB 3.0
Diff 100 Ohm ±10%
RK3568

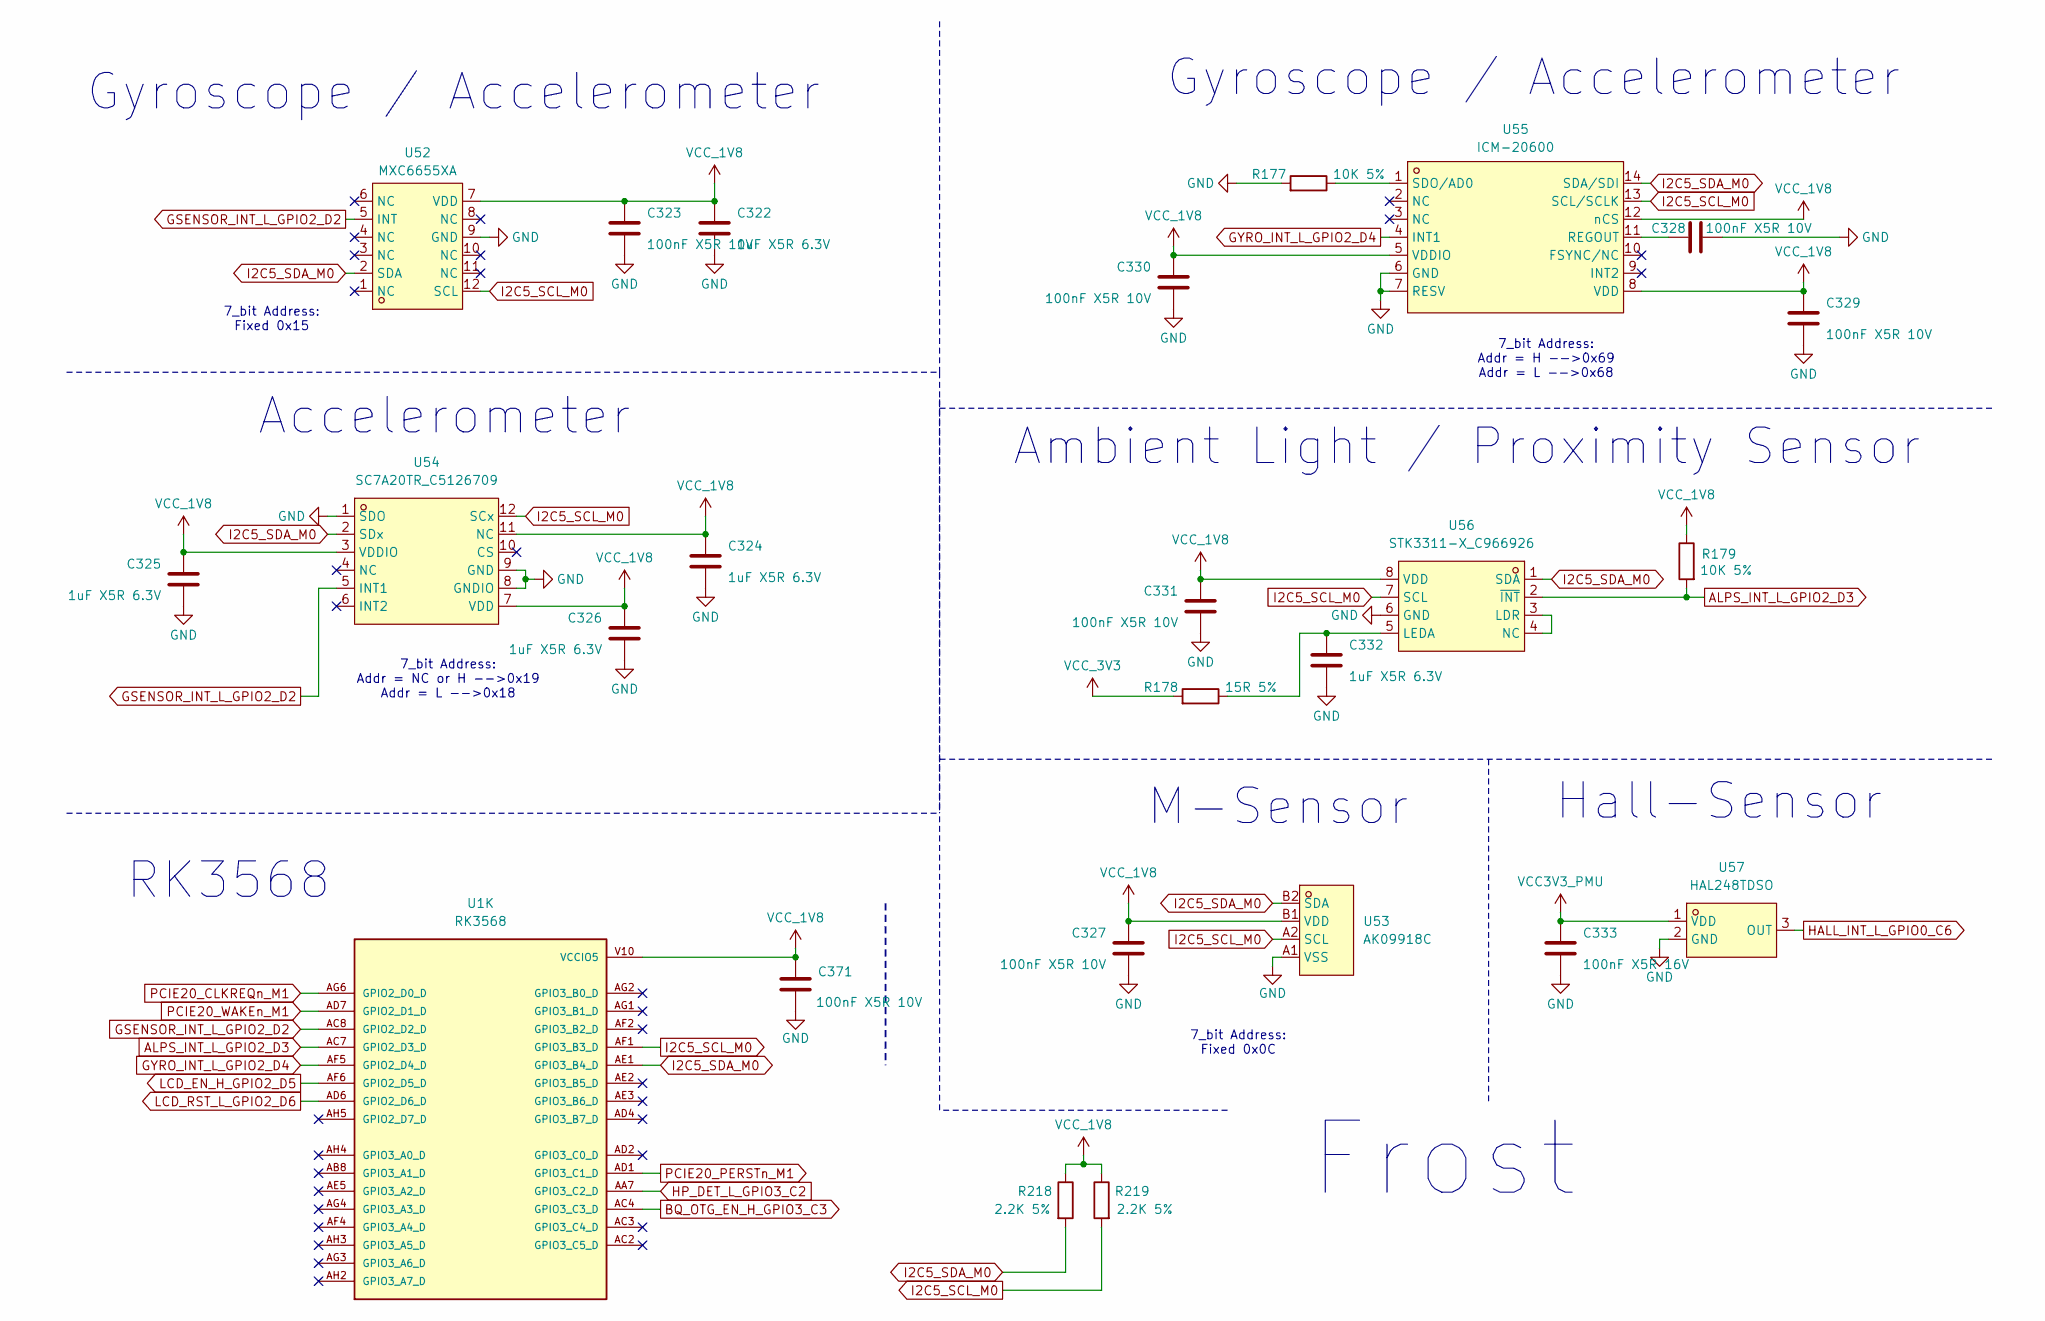
[picture p13: schematic sensors.kicad_sch]

Parts:
C322, C324, C325, C326, C332: 1uF X5R 6.3V; C_0402_1005Metric
C323, C327, C328, C329, C330, C331: 100nF X5R 10V; C_0402_1005Metric
C333: 100nF X5R 16V; C_0402_1005Metric
C371: 100nF X5R 10V; C_0201_0603Metric
R177, R179: 10K 5%; R_0402_1005Metric
R178: 15R 5%; R_0402_1005Metric
R218, R219: 2.2K 5%; R_0402_1005Metric
U1: RK3568; BGA636C65P28X28_1900X1900X168; PARTREV 1.3; LCSC C3345225
U52: MXC6655XA; LGA-12_L2.0-W2.0-P0.50-TL_BOSCH_BMA490L; LCSC Part C5189050
U53: AK09918C; WLCSP-4_L0.8-W0.8-R2-C2-P0.40-BL-1; LCSC Part C2655004
U54: SC7A20TR_C5126709; LGA-12_L2.0-W2.0-P0.50-BL; LCSC Part C5126709
U55: ICM-20600; LGA-14_L3.0-W2.5-P0.50-BL; LCSC Part C124140
U56: STK3311-X_C966926; LGA-8_L4.0-W2.4-P0.97-BR; LCSC Part C966926
U57: HAL248TDSO; SOT-23-3_L2.9-W1.6-P1.90-LS2.8-BR-CW; LCSC Part C19089538

Connections:
ALPS_INT_L_GPIO2_D3: R179.2, U1.AC7 (GPIO2_D3_D), U56.2 (~INT)
BQ_OTG_EN_H_GPIO3_C3: U1.AC4 (GPIO3_C3_D); also elsewhere on the board
GSENSOR_INT_L_GPIO2_D2: U1.AC8 (GPIO2_D2_D), U52.5 (INT), U54.5 (INT1)
GYRO_INT_L_GPIO2_D4: U1.AF5 (GPIO2_D4_D), U55.4 (INT1)
HALL_INT_L_GPIO0_C6: U57.3 (OUT); also elsewhere on the board
HP_DET_L_GPIO3_C2: U1.AA7 (GPIO3_C2_D); also elsewhere on the board
I2C5_SCL_M0: R219.2, U1.AF1 (GPIO3_B3_D), U52.12 (SCL), U53.A2 (SCL), U54.12 (SCx), U55.13 (SCL/SCLK), U56.7 (SCL)
I2C5_SDA_M0: R218.2, U1.AE1 (GPIO3_B4_D), U52.2 (SDA), U53.B2 (SDA), U54.2 (SDx), U55.14 (SDA/SDI), U56.1 (SDA)
LCD_EN_H_GPIO2_D5: U1.AF6 (GPIO2_D5_D)
LCD_RST_L_GPIO2_D6: U1.AD6 (GPIO2_D6_D); also elsewhere on the board
unnamed: C328.1, U55.11 (REGOUT)
unnamed: R177.1, U55.1 (SDO/AD0)
unnamed: U56.3 (LDR), U56.4 (NC)
unnamed: C332.1, R178.1, U56.5 (LEDA)
PCIE20_CLKREQn_M1: U1.AG6 (GPIO2_D0_D); also elsewhere on the board
PCIE20_PERSTn_M1: U1.AD1 (GPIO3_C1_D); also elsewhere on the board
PCIE20_WAKEn_M1: U1.AD7 (GPIO2_D1_D); also elsewhere on the board
VCC3V3_PMU: C333.1, U57.1 (VDD); also elsewhere on the board
VCC_1V8: C322.1, C323.1, C324.1, C325.1, C326.1, C327.1, C329.1, C330.1, C331.1, C371.1, R179.1, R218.1, R219.1, U1.V10 (VCCIO5), U1.V11 (VCCIO5), U52.7 (VDD), U53.B1 (VDD), U54.3 (VDDIO), U54.7 (VDD), U54.11 (NC), U55.5 (VDDIO), U55.8 (VDD), U55.12 (nCS), U56.8 (VDD); also elsewhere on the board
VCC_3V3: R178.2; also elsewhere on the board

Notes on the sheet:
RK3568
Frost
Gyroscope / Accelerometer
Ambient Light / Proximity Sensor
7_bit Address: Fixed 0x15
M-Sensor
Hall-Sensor
7_bit Address: Fixed 0x0C
7_bit Address: Addr = H -->0x69 Addr = L -->0x68
Accelerometer
7_bit Address: Addr = NC or H -->0x19 Addr = L -->0x18
