notaroomba/frost/hardware/board/frost.kicad_pcb

## KiCad design hardware/board/frost.kicad_pcb (continued)

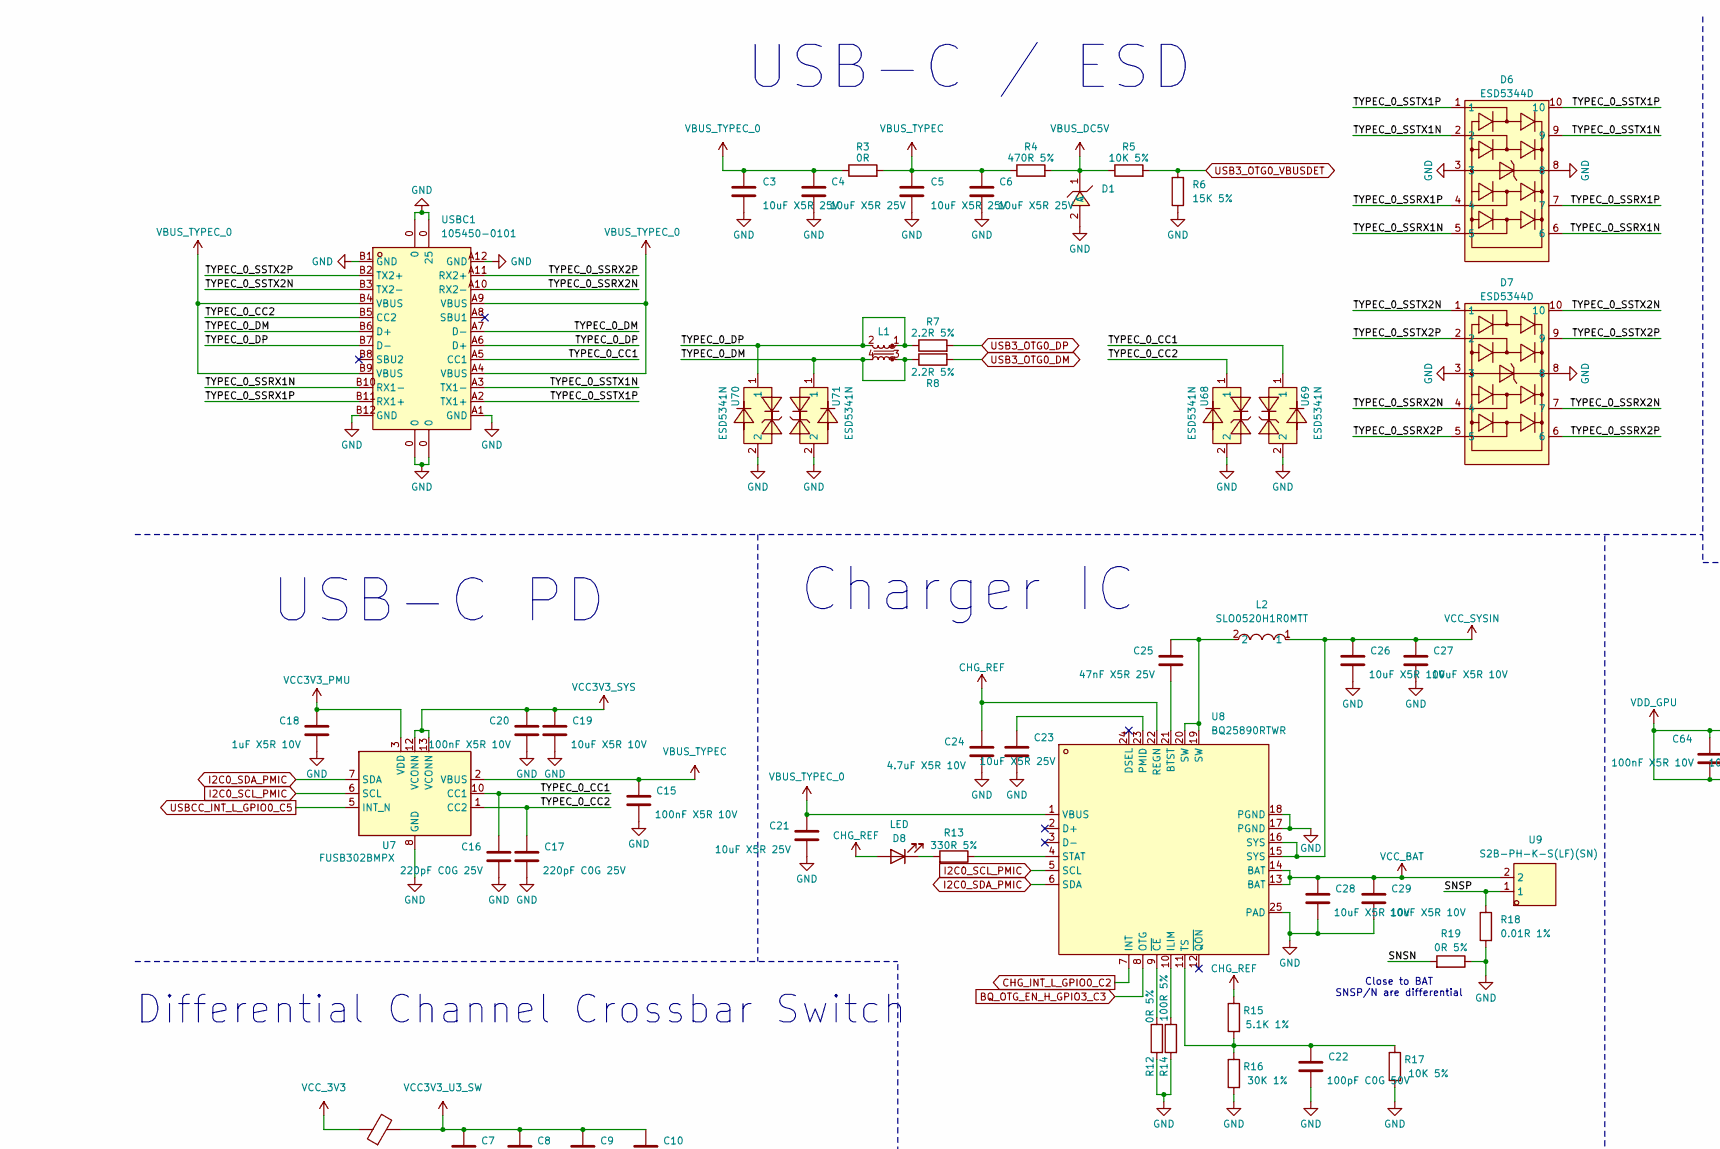
[picture p14: schematic power.kicad_sch, part in row 1, column 1]

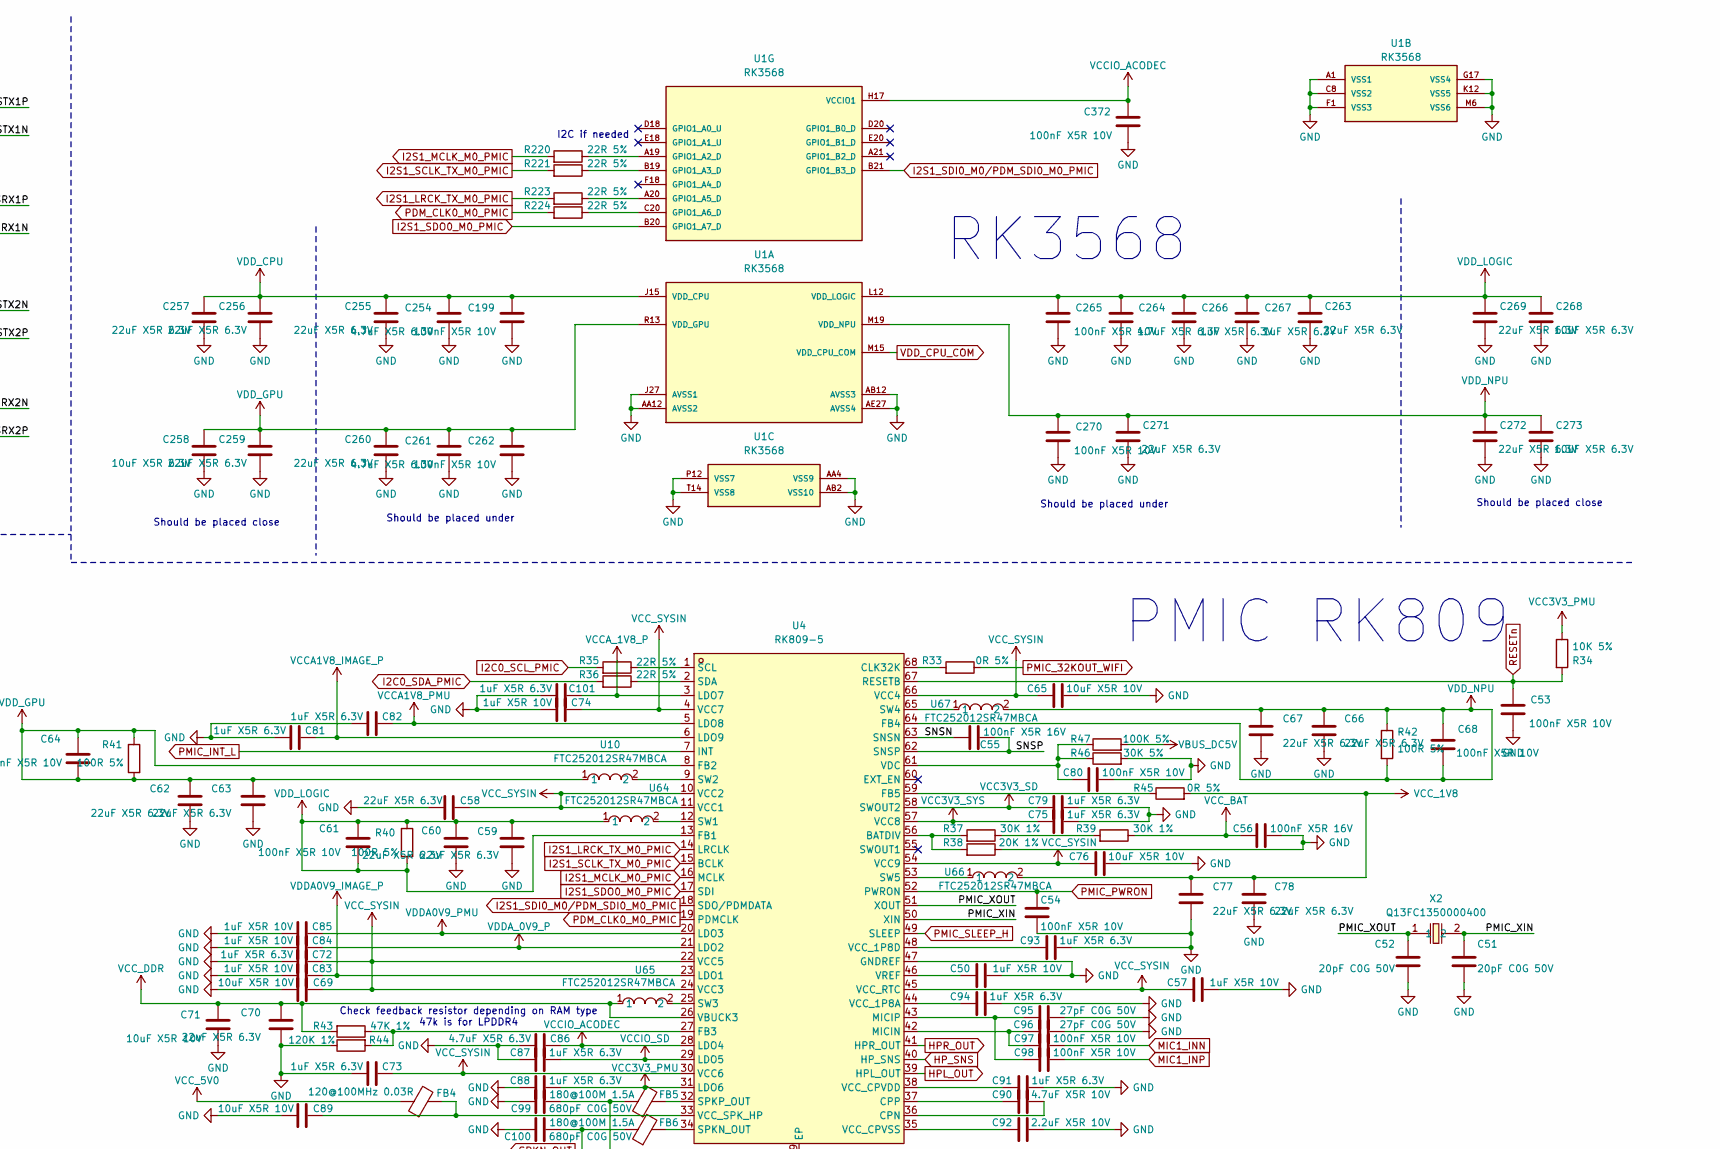
[picture p15: schematic power.kicad_sch, part in row 1, column 2]

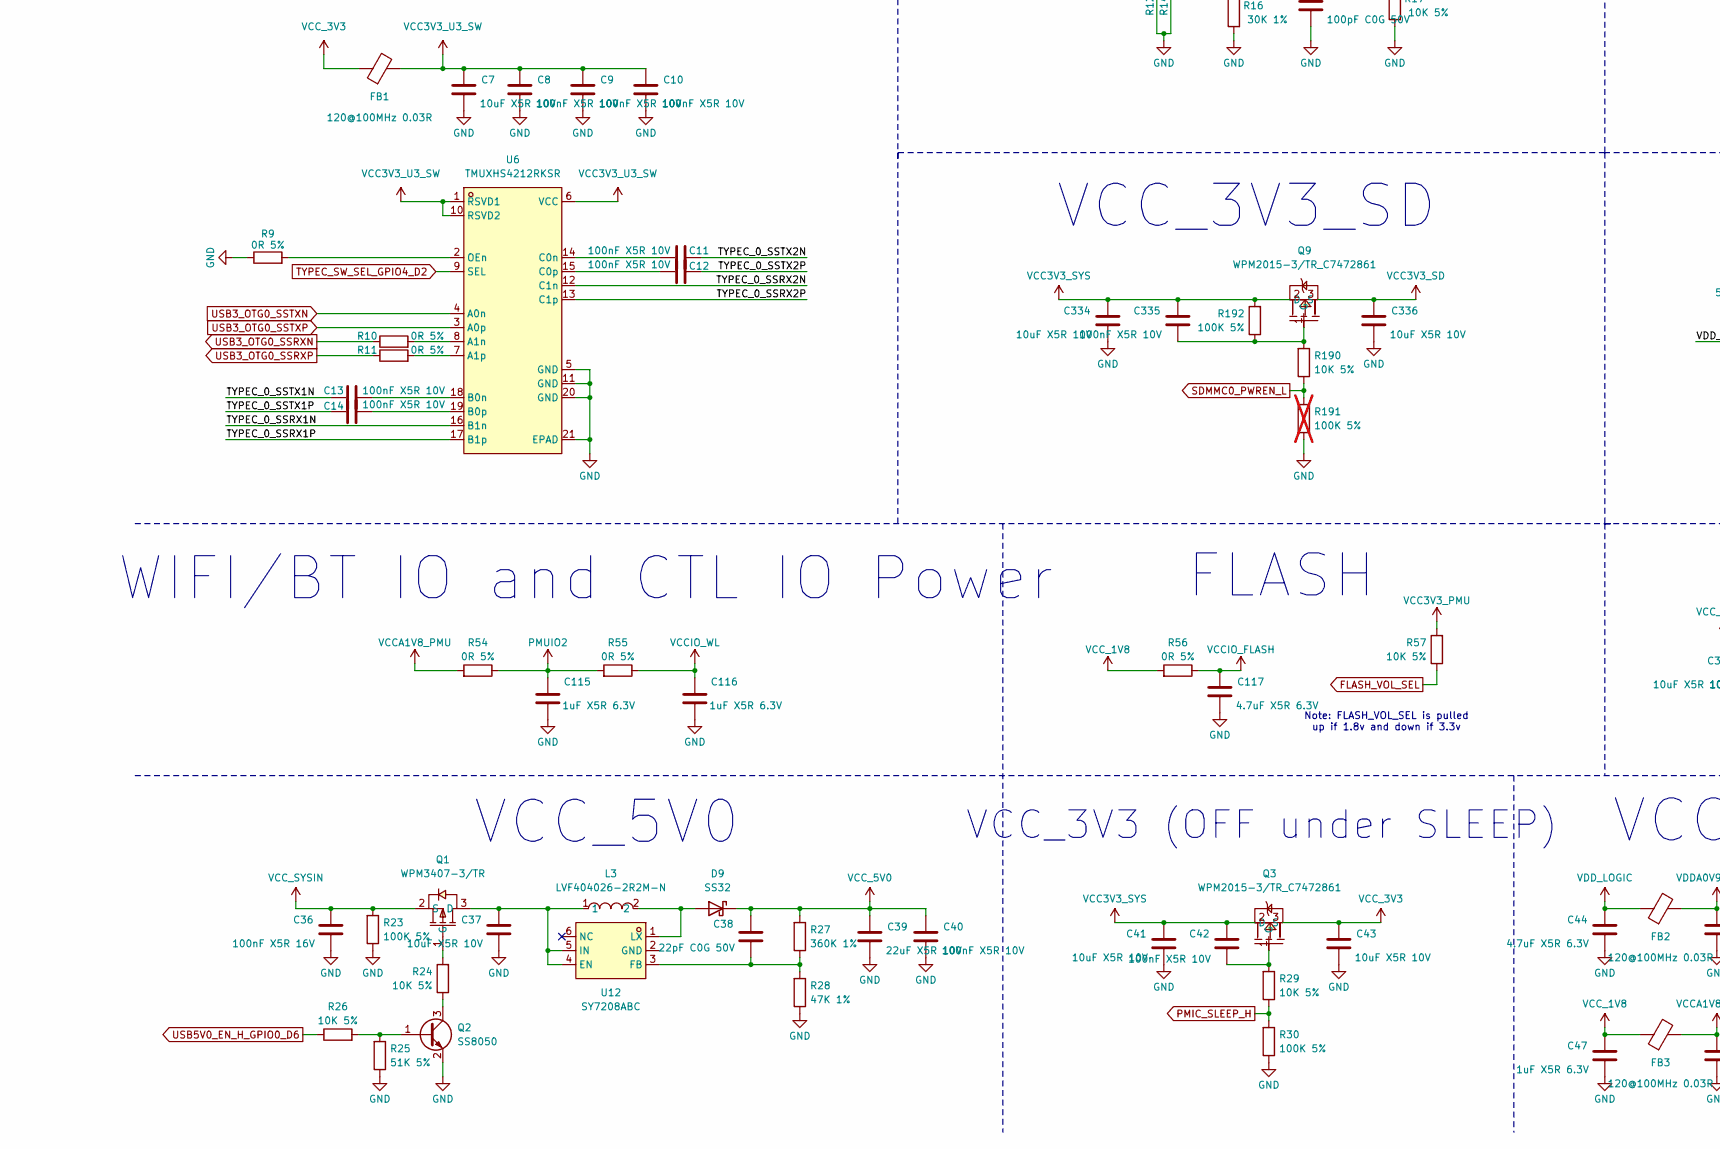
[picture p16: schematic power.kicad_sch, part in row 2, column 1]

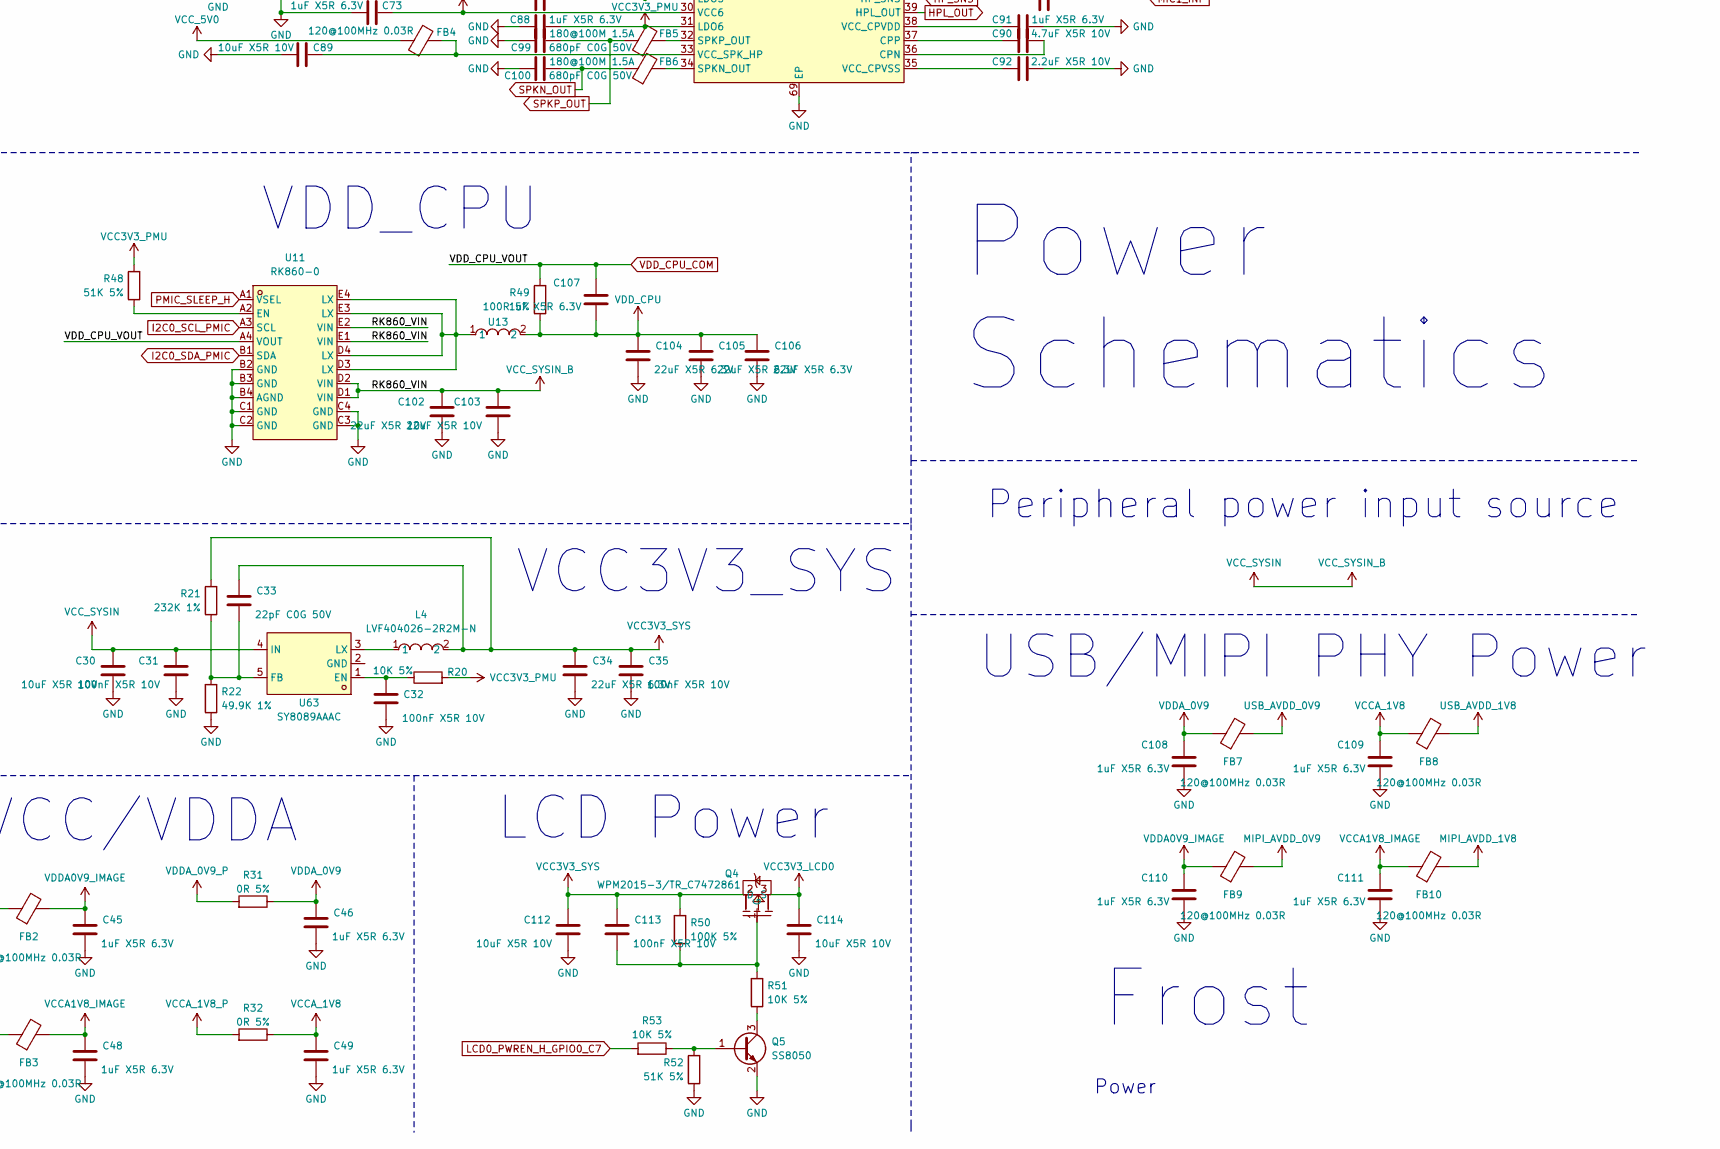
[picture p17: schematic power.kicad_sch, part in row 2, column 2]

Parts:
C3, C4, C5, C6, C21, C23: 10uF X5R 25V; C_0805_2012Metric
C7, C19, C30, C41, C43, C65, C69, C71, C76, C89, C112, C114, C334, C336: 10uF X5R 10V; C_0603_1608Metric
C8, C9, C10, C15, C20, C31, C32, C35, C40, C42, C53, C54, C61, C64, C68, C80, C97, C98, C113, C199, C335: 100nF X5R 10V; C_0402_1005Metric
C11, C12, C13, C14, C262, C265, C270, C372: 100nF X5R 10V; C_0201_0603Metric
C16, C17: 220pF C0G 25V; C_0402_1005Metric
C18, C50, C57, C74, C83, C84, C85: 1uF X5R 10V; C_0402_1005Metric
C22: 100pF C0G 50V; C_0402_1005Metric
C24: 4.7uF X5R 10V; C_0402_1005Metric
C25: 47nF X5R 25V; C_0402_1005Metric
C26, C27, C28, C29, C37: 10uF X5R 10V; C_0805_2012Metric
C33, C38: 22pF C0G 50V; C_0402_1005Metric
C34, C58, C59, C60, C62, C63, C66, C67, C70, C77, C78, C104, C105, C106, C255, C256, C257, C259, C260, C263, C269, C271, C272: 22uF X5R 6.3V; C_0603_1608Metric
C36, C55, C56: 100nF X5R 16V; C_0402_1005Metric
C39, C102, C103: 22uF X5R 10V; C_0805_2012Metric
C44, C86, C254, C261, C264: 4.7uF X5R 6.3V; C_0402_1005Metric
C45, C46, C47, C48, C49, C72, C73, C75, C79, C81, C82, C87, C88, C91, C93, C94, C101, C107, C108, C109, C110, C111, C115, C116, C266, C267: 1uF X5R 6.3V; C_0402_1005Metric
C51, C52: 20pF C0G 50V; C_0402_1005Metric
C90: 4.7uF X5R 10V; C_0603_1608Metric
C92: 2.2uF X5R 10V; C_0402_1005Metric
C95, C96: 27pF C0G 50V; C_0402_1005Metric
C99, C100: 680pF C0G 50V; C_0402_1005Metric
C117: 4.7uF X5R 6.3V; C_0603_1608Metric
C258, C268, C273: 10uF X5R 6.3V; C_0603_1608Metric
D1: BZT52C5V1_C173407; SOD-123_L2.7-W1.6-LS3.7-RD; LCSC Part C173407
D6, D7: ESD5344D; DFN2510-10_L2.5-W1.0-P0.50-BL; LCSC Part C6562203
D8: LED; LED_0603_1608Metric
D9: SS32; D_SMA
FB1, FB2, FB3, FB4, FB7, FB8, FB9, FB10: 120@100MHz 0.03R; L_0603_1608Metric; LCSC C85831
FB5, FB6: 180@100M 1.5A; L_0603_1608Metric; LCSC C268312
L1: L_Iron_Coupled_Small; FILTER-SMD_4P-L2.0-W1.2-BL_DLW21H
L2: SLO0520H1R0MTT; IND-SMD_L5.4-W5.1; LCSC Part C325980
L3, L4: LVF404026-2R2M-N; IND-SMD_L4.0-W4.0; LCSC Part C2847115
Q1: WPM3407-3/TR; SOT-23-3_L3.0-W1.7-P0.95-LS2.9-BR; LCSC Part C167139
Q2, Q5: SS8050; SOT-23
Q3, Q4, Q9: WPM2015-3/TR_C7472861; SOT-23-3_L2.9-W1.3-P1.90-LS2.4-BR; LCSC Part C7472861
R3: 0R; R_1206_3216Metric
R4: 470R 5%; R_0805_2012Metric
R5, R17, R20, R24, R26, R29, R34, R51, R53, R57, R190: 10K 5%; R_0402_1005Metric
R6: 15K 5%; R_0402_1005Metric
R7, R8: 2.2R 5%; R_0402_1005Metric
R9, R12, R19, R31, R32, R33, R45, R54, R55, R56: 0R 5%; R_0402_1005Metric
R10, R11: 0R 5%; R_0201_0603Metric
R13: 330R 5%; R_0402_1005Metric
R14, R40, R41, R42, R49: 100R 5%; R_0402_1005Metric
R15: 5.1K 1%; R_0402_1005Metric
R16, R37, R39: 30K 1%; R_0402_1005Metric
R18: 0.01R 1%; R_1206_3216Metric
R21: 232K 1%; R_0402_1005Metric
R22: 49.9K 1%; R_0402_1005Metric
R23, R30, R47, R50, R192: 100K 5%; R_0402_1005Metric
R25, R48, R52: 51K 5%; R_0402_1005Metric
R27: 360K 1%; R_0402_1005Metric
R28, R43: 47K 1%; R_0402_1005Metric
R35, R36, R220, R221, R223, R224: 22R 5%; R_0402_1005Metric
R38: 20K 1%; R_0402_1005Metric
R44: 120K 1%; R_0402_1005Metric
R46: 30K 5%; R_0402_1005Metric
R191: 100K 5%; R_0402_1005Metric; not fitted
U1: RK3568; BGA636C65P28X28_1900X1900X168; PARTREV 1.3; LCSC C3345225
U4: RK809-5; QFN-68_L7.0-W7.0-P0.35-BL-EP5.5; LCSC Part C2939628
U6: TMUXHS4212RKSR; TQFN-20_L4.5-W2.5-P0.50-BL-EP3.0; LCSC Part C2869871
U7: FUSB302BMPX; WQFN-14-1EP_2.5x2.5mm_P0.5mm_EP1.45x1.45mm
U8: BQ25890RTWR; WQFN-24_L4.0-W4.0-P0.50-BL-EP; LCSC Part C130451
U9: S2B-PH-K-S(LF)(SN); CONN-TH_S2B-PH-K-S-LF-SN; LCSC Part C173752
U10, U64, U65, U66, U67: FTC252012SR47MBCA; IND-SMD_L2.5-W2.0; LCSC Part C5832368
U11: RK860-0; WLCSP-20_L2.0-W1.6-R5-C4-P0.40-TL; LCSC Part C19188628
U12: SY7208ABC; SOT-23-6_L2.9-W1.6-P0.95-LS2.8-BR; LCSC Part C80514
U13: FTC252012SR24MBCA; IND-SMD_L2.5-W2.0_MHCHL2520; LCSC Part C5832366
U63: SY8089AAAC; SOT-23-5_L3.0-W1.7-P0.95-LS2.8-BR; LCSC Part C78988
U68, U69, U70, U71: ESD5341N; DFN1006-2L-RD; LCSC Part C3021106
USBC1: 105450-0101; USB-C-SMD_TYPE-C-USB-18; LCSC Part C134092
X2: Q13FC1350000400; FC-135R_L3.2-W1.5; LCSC Part C32346

Connections:
/Power/PMIC_XIN: C51.1, U4.50 (XIN), X2.2
/Power/PMIC_XOUT: C52.1, U4.51 (XOUT), X2.1
/Power/SNSN: C55.1, R19.2, U4.63 (SNSN)
/Power/SNSP: C55.2, R18.1, U4.62 (SNSP), U9.1
/Power/TYPEC_0_CC1: C16.1, U7.10 (CC1), U7.11 (CC1), U69.1, USBC1.A5 (CC1)
/Power/TYPEC_0_CC2: C17.1, U7.1 (CC2), U7.14 (CC2), U68.1, USBC1.B5 (CC2)
/Power/TYPEC_0_DM: L1.3, L1.4, R8.1, U71.1, USBC1.A7 (D-), USBC1.B6 (D+)
/Power/TYPEC_0_DP: L1.1, L1.2, R7.1, U70.1, USBC1.A6 (D+), USBC1.B7 (D-)
/Power/TYPEC_0_SSRX1N: D6.5, D6.6, U6.16 (B1n), USBC1.B10 (RX1-)
/Power/TYPEC_0_SSRX1P: D6.4, D6.7, U6.17 (B1p), USBC1.B11 (RX1+)
/Power/TYPEC_0_SSRX2N: D7.4, D7.7, U6.12 (C1n), USBC1.A10 (RX2-)
/Power/TYPEC_0_SSRX2P: D7.5, D7.6, U6.13 (C1p), USBC1.A11 (RX2+)
/Power/TYPEC_0_SSTX1N: C13.1, D6.2, D6.9, USBC1.A3 (TX1-)
/Power/TYPEC_0_SSTX1P: C14.1, D6.1, D6.10, USBC1.A2 (TX1+)
/Power/TYPEC_0_SSTX2N: C11.1, D7.1, D7.10, USBC1.B3 (TX2-)
/Power/TYPEC_0_SSTX2P: C12.1, D7.2, D7.9, USBC1.B2 (TX2+)
BQ_OTG_EN_H_GPIO3_C3: U8.8 (OTG); also elsewhere on the board
CHG_INT_L_GPIO0_C2: U8.7 (INT); also elsewhere on the board
CHG_REF: C24.1, D8.2 (A), R15.1, U8.22 (REGN)
FLASH_VOL_SEL: R57.1; also elsewhere on the board
HPL_OUT: U4.39 (HPL_OUT); also elsewhere on the board
HPR_OUT: U4.41 (HPR_OUT); also elsewhere on the board
HP_SNS: U4.40 (HP_SNS); also elsewhere on the board
I2C0_SCL_PMIC: R35.2, U7.6 (SCL), U8.5 (SCL), U11.A3 (SCL); also elsewhere on the board
I2C0_SDA_PMIC: R36.2, U7.7 (SDA), U8.6 (SDA), U11.B1 (SDA); also elsewhere on the board
I2S1_LRCK_TX_M0_PMIC: R223.2, U4.14 (LRCLK)
I2S1_MCLK_M0_PMIC: R220.2, U4.16 (MCLK)
I2S1_SCLK_TX_M0_PMIC: R221.2, U4.15 (BCLK)
I2S1_SDI0_M0/PDM_SDI0_M0_PMIC: U1.B21 (GPIO1_B3_D), U4.18 (SDO/PDMDATA)
I2S1_SDO0_M0_PMIC: U1.B20 (GPIO1_A7_D), U4.17 (SDI)
LCD0_PWREN_H_GPIO0_C7: R53.2; also elsewhere on the board
MIC1_INN: C97.1; also elsewhere on the board
MIC1_INP: C98.1
MIPI_AVDD_0V9: FB9.2; also elsewhere on the board
MIPI_AVDD_1V8: FB10.2; also elsewhere on the board
unnamed: C25.1, L2.2, U8.19 (SW), U8.20 (SW)
unnamed: D8.1 (K), R13.2
unnamed: D9.2 (A), L3.2, U12.1 (LX)
unnamed: C37.1, L3.1, Q1.3 (D), U12.4 (EN), U12.5 (IN)
unnamed: Q1.1 (G), R24.2
unnamed: Q2.1 (B), R25.2, R26.2
unnamed: Q2.3 (C), R24.1
unnamed: C42.2, Q3.1 (G), R29.2
unnamed: C113.2, Q4.1 (G), R50.1, R51.2
unnamed: Q5.1 (B), R52.2, R53.1
unnamed: Q5.3 (C), R51.1
unnamed: C335.2, Q9.1 (G), R190.2, R192.1
unnamed: R37.1, R39.2
unnamed: R220.1, U1.A19 (GPIO1_A2_D)
unnamed: R221.1, U1.B19 (GPIO1_A3_D)
unnamed: R223.1, U1.A20 (GPIO1_A5_D)
unnamed: R224.1, U1.C20 (GPIO1_A6_D)
unnamed: R37.2, R38.2, U4.56 (BATDIV)
unnamed: R33.2, U4.68 (CLK32K)
unnamed: C90.2, U4.36 (CPN)
unnamed: C90.1, U4.37 (CPP)
unnamed: R43.1, R44.2, U4.27 (FB3)
unnamed: R45.1, U4.59 (FB5)
unnamed: C96.1, C97.2, U4.42 (MICIN)
unnamed: C95.1, C98.2, U4.43 (MICIP)
unnamed: R35.1, U4.1 (SCL)
unnamed: R36.1, U4.2 (SDA)
unnamed: FB6.2, U4.34 (SPKN_OUT)
unnamed: FB5.2, U4.32 (SPKP_OUT)
unnamed: U4.12 (SW1), U64.2
unnamed: U4.9 (SW2), U10.2
unnamed: U4.25 (SW3), U65.2
unnamed: U4.65 (SW4), U67.1
unnamed: U4.53 (SW5), U66.1
unnamed: C94.1, U4.44 (VCC_1P8A)
unnamed: C93.1, U4.48 (VCC_1P8D)
unnamed: C91.1, U4.38 (VCC_CPVDD)
unnamed: C92.1, U4.35 (VCC_CPVSS)
unnamed: C89.1, FB4.2, U4.33 (VCC_SPK_HP)
unnamed: C80.2, R46.1, R47.1, U4.61 (VDC)
unnamed: C50.1, U4.46 (VREF)
unnamed: R10.2, U6.8 (A1n)
unnamed: R11.2, U6.7 (A1p)
unnamed: C13.2, U6.18 (B0n)
unnamed: C14.2, U6.19 (B0p)
unnamed: C11.2, U6.14 (C0n)
unnamed: C12.2, U6.15 (C0p)
unnamed: R9.2, U6.2 (OEn)
unnamed: C25.2, U8.21 (BTST)
unnamed: R14.1, U8.10 (ILIM)
unnamed: C23.2, U8.23 (PMID)
unnamed: R13.1, U8.4 (STAT)
unnamed: C22.1, R15.2, R16.1, R17.1, U8.11 (TS)
unnamed: R12.1, U8.9 (~CE)
unnamed: R48.1, U11.A2 (EN)
unnamed: U11.D3 (LX), U11.D4 (LX), U11.E3 (LX), U11.E4 (LX), U13.1
unnamed: C38.2, R27.1, R28.2, U12.3 (FB)
unnamed: C32.1, R20.1, U63.1 (EN)
unnamed: C33.2, R21.1, R22.2, U63.5 (FB)
unnamed: L4.1, U63.3 (LX)
PDM_CLK0_M0_PMIC: R224.2, U4.19 (PDMCLK)
PMIC_32KOUT_WIFI: R33.1; also elsewhere on the board
PMIC_INT_L: U4.7 (INT); also elsewhere on the board
PMIC_PWRON: C54.1, U4.52 (PWRON); also elsewhere on the board
PMIC_SLEEP_H: R29.1, R30.2, U4.49 (SLEEP), U11.A1 (VSEL); also elsewhere on the board
PMUIO2: C115.1, R54.1, R55.2; also elsewhere on the board
RESETn: C53.1, R34.2, U4.67 (RESETB); also elsewhere on the board
SDMMC0_PWREN_L: R190.1, R191.2; also elsewhere on the board
SPKN_OUT: C100.2, FB6.1
SPKP_OUT: C99.2, FB5.1
TYPEC_SW_SEL_GPIO4_D2: U6.9 (SEL); also elsewhere on the board
USB3_OTG0_DM: R8.2; also elsewhere on the board
USB3_OTG0_DP: R7.2; also elsewhere on the board
USB3_OTG0_SSRXN: R10.1; also elsewhere on the board
USB3_OTG0_SSRXP: R11.1; also elsewhere on the board
USB3_OTG0_SSTXN: U6.4 (A0n); also elsewhere on the board
USB3_OTG0_SSTXP: U6.3 (A0p); also elsewhere on the board
USB3_OTG0_VBUSDET: R5.2, R6.2; also elsewhere on the board
USB5V0_EN_H_GPIO0_D6: R26.1; also elsewhere on the board
USBCC_INT_L_GPIO0_C5: U7.5 (INT_N); also elsewhere on the board
USB_AVDD_0V9: FB7.2; also elsewhere on the board
USB_AVDD_1V8: FB8.2; also elsewhere on the board
VBUS_DC5V: D1.1 (C), R4.2, R5.1, R47.2
VBUS_TYPEC: C5.1, C6.1, C15.1, R3.2, R4.1, U7.2 (VBUS)
VBUS_TYPEC_0: C3.1, C4.1, C21.1, R3.1, U8.1 (VBUS), USBC1.A4 (VBUS), USBC1.A9 (VBUS), USBC1.B4 (VBUS), USBC1.B9 (VBUS)
VCC3V3_LCD0: C114.1, Q4.3 (D); also elsewhere on the board
VCC3V3_PMU: C18.1, C88.1, R20.2, R34.1, R48.2, R57.2, U4.31 (LDO6), U7.3 (VDD), U7.4 (VDD); also elsewhere on the board
VCC3V3_SD: C79.2, C336.1, Q9.3 (D), U4.58 (SWOUT2); also elsewhere on the board
VCC3V3_SYS: C19.1, C20.1, C33.1, C34.1, C35.1, C41.1, C42.1, C75.2, C112.1, C113.1, C334.1, C335.1, L4.2, Q3.2 (S), Q4.2 (S), Q9.2 (S), R21.2, R50.2, R192.2, U4.57 (VCC8), U7.12 (VCONN), U7.13 (VCONN); also elsewhere on the board
VCC3V3_U3_SW: C7.1, C8.1, C9.1, C10.1, FB1.2, U6.1 (RSVD1), U6.6 (VCC), U6.10 (RSVD2)
VCCA1V8_IMAGE: C48.1, C111.1, FB3.2, FB10.1; also elsewhere on the board
VCCA1V8_IMAGE_P: C81.2, U4.6 (LDO9); also elsewhere on the board
VCCA1V8_PMU: C82.2, R54.2, U4.5 (LDO8); also elsewhere on the board
VCCA_1V8: C49.1, C109.1, FB8.1, R32.1; also elsewhere on the board
VCCA_1V8_P: C101.2, R32.2, U4.3 (LDO7)
VCCIO_ACODEC: C86.2, C372.1, U1.H17 (VCCIO1), U4.28 (LDO4); also elsewhere on the board
VCCIO_FLASH: C117.1, R56.1; also elsewhere on the board
VCCIO_SD: C87.1, U4.29 (LDO5); also elsewhere on the board
VCCIO_WL: C116.1, R55.1; also elsewhere on the board
VCC_1V8: C47.1, C77.1, C78.1, FB3.1, R45.2, R56.2, U66.2; also elsewhere on the board
VCC_3V3: C43.1, FB1.1, Q3.3 (D); also elsewhere on the board
VCC_5V0: C38.1, C39.1, C40.1, D9.1 (K), FB4.1, R27.2; also elsewhere on the board
VCC_BAT: C28.1, C29.1, C56.1, R39.1, U8.13 (BAT), U8.14 (BAT), U9.2
VCC_DDR: C70.1, C71.1, R43.2, U4.26 (VBUCK3), U65.1; also elsewhere on the board
VCC_SYSIN: C26.1, C27.1, C30.1, C31.1, C36.1, C57.1, C58.1, C65.1, C69.1, C72.2, C73.2, C74.2, C76.1, C102.1, C103.1, L2.1, Q1.2 (S), R23.2, U4.4 (VCC7), U4.10 (VCC2), U4.11 (VCC1), U4.22 (VCC5), U4.24 (VCC3), U4.30 (VCC6), U4.45 (VCC_RTC), U4.54 (VCC9), U4.66 (VCC4), U8.15 (SYS), U8.16 (SYS), U11.D1 (VIN), U11.D2 (VIN), U11.E1 (VIN), U11.E2 (VIN), U63.4 (IN); also elsewhere on the board
VDDA0V9_IMAGE: C45.1, C110.1, FB2.2, FB9.1; also elsewhere on the board
VDDA0V9_IMAGE_P: C83.2, U4.23 (LDO1); also elsewhere on the board
VDDA0V9_PMU: C85.2, U4.20 (LDO3); also elsewhere on the board
VDDA_0V9: C46.1, C108.1, FB7.1, R31.1; also elsewhere on the board
VDDA_0V9_P: C84.2, R31.2, U4.21 (LDO2)
VDD_CPU: C104.1, C105.1, C106.1, C107.2, C199.1, C254.1, C255.1, C256.1, C257.1, R49.1, U1.J15 (VDD_CPU), U1.K15 (VDD_CPU), U1.K16 (VDD_CPU), U1.K17 (VDD_CPU), U1.K18 (VDD_CPU), U1.L15 (VDD_CPU), U1.L16 (VDD_CPU), U1.L17 (VDD_CPU), U1.L18 (VDD_CPU), U1.M17 (VDD_CPU), U13.2
VDD_CPU_COM: C107.1, R49.2, U1.M15 (VDD_CPU_COM), U11.A4 (VOUT)
VDD_GPU: C62.1, C63.1, C64.1, C64.2, C258.1, C259.1, C260.1, C261.1, C262.1, R41.1, R41.2, U1.R13 (VDD_GPU), U1.T13 (VDD_GPU), U1.U11 (VDD_GPU), U1.U12 (VDD_GPU), U1.U13 (VDD_GPU), U4.8 (FB2), U10.1
VDD_LOGIC: C44.1, C59.1, C60.1, C61.1, C61.2, C263.1, C264.1, C265.1, C266.1, C267.1, C268.1, C269.1, FB2.1, R40.1, R40.2, U1.L12 (VDD_LOGIC), U1.M12 (VDD_LOGIC), U1.N13 (VDD_LOGIC), U1.N16 (VDD_LOGIC), U1.P13 (VDD_LOGIC), U1.P16 (VDD_LOGIC), U1.R12 (VDD_LOGIC), U1.R16 (VDD_LOGIC), U1.T12 (VDD_LOGIC), U1.T16 (VDD_LOGIC), U4.13 (FB1), U64.1
VDD_NPU: C66.1, C67.1, C68.1, C68.2, C270.1, C271.1, C272.1, C273.1, R42.1, R42.2, U1.M19 (VDD_NPU), U1.N19 (VDD_NPU), U1.P18 (VDD_NPU), U1.P19 (VDD_NPU), U1.P20 (VDD_NPU), U4.64 (FB4), U67.2

Notes on the sheet:
LCD Power
Should be placed under
VCC_3V3_SD
USB/MIPI PHY Power
USB-C / ESD
VDD_CPU
I2C if needed
USB-C PD
Power Schematics
VCC/VDDA
Differential Channel Crossbar Switch
VCC_3V3 (OFF under SLEEP)
Should be placed close
Peripheral power input source
Check feedback resistor depending on RAM type 47k is for LPDDR4
Power
Frost
FLASH
WIFI/BT IO and CTL IO Power
VCC_5V0
Close to BAT SNSP/N are differential
Note: FLASH_VOL_SEL is pulled up if 1.8v and down if 3.3v
VCC3V3_SYS
PMIC RK809
RK3568
Charger IC

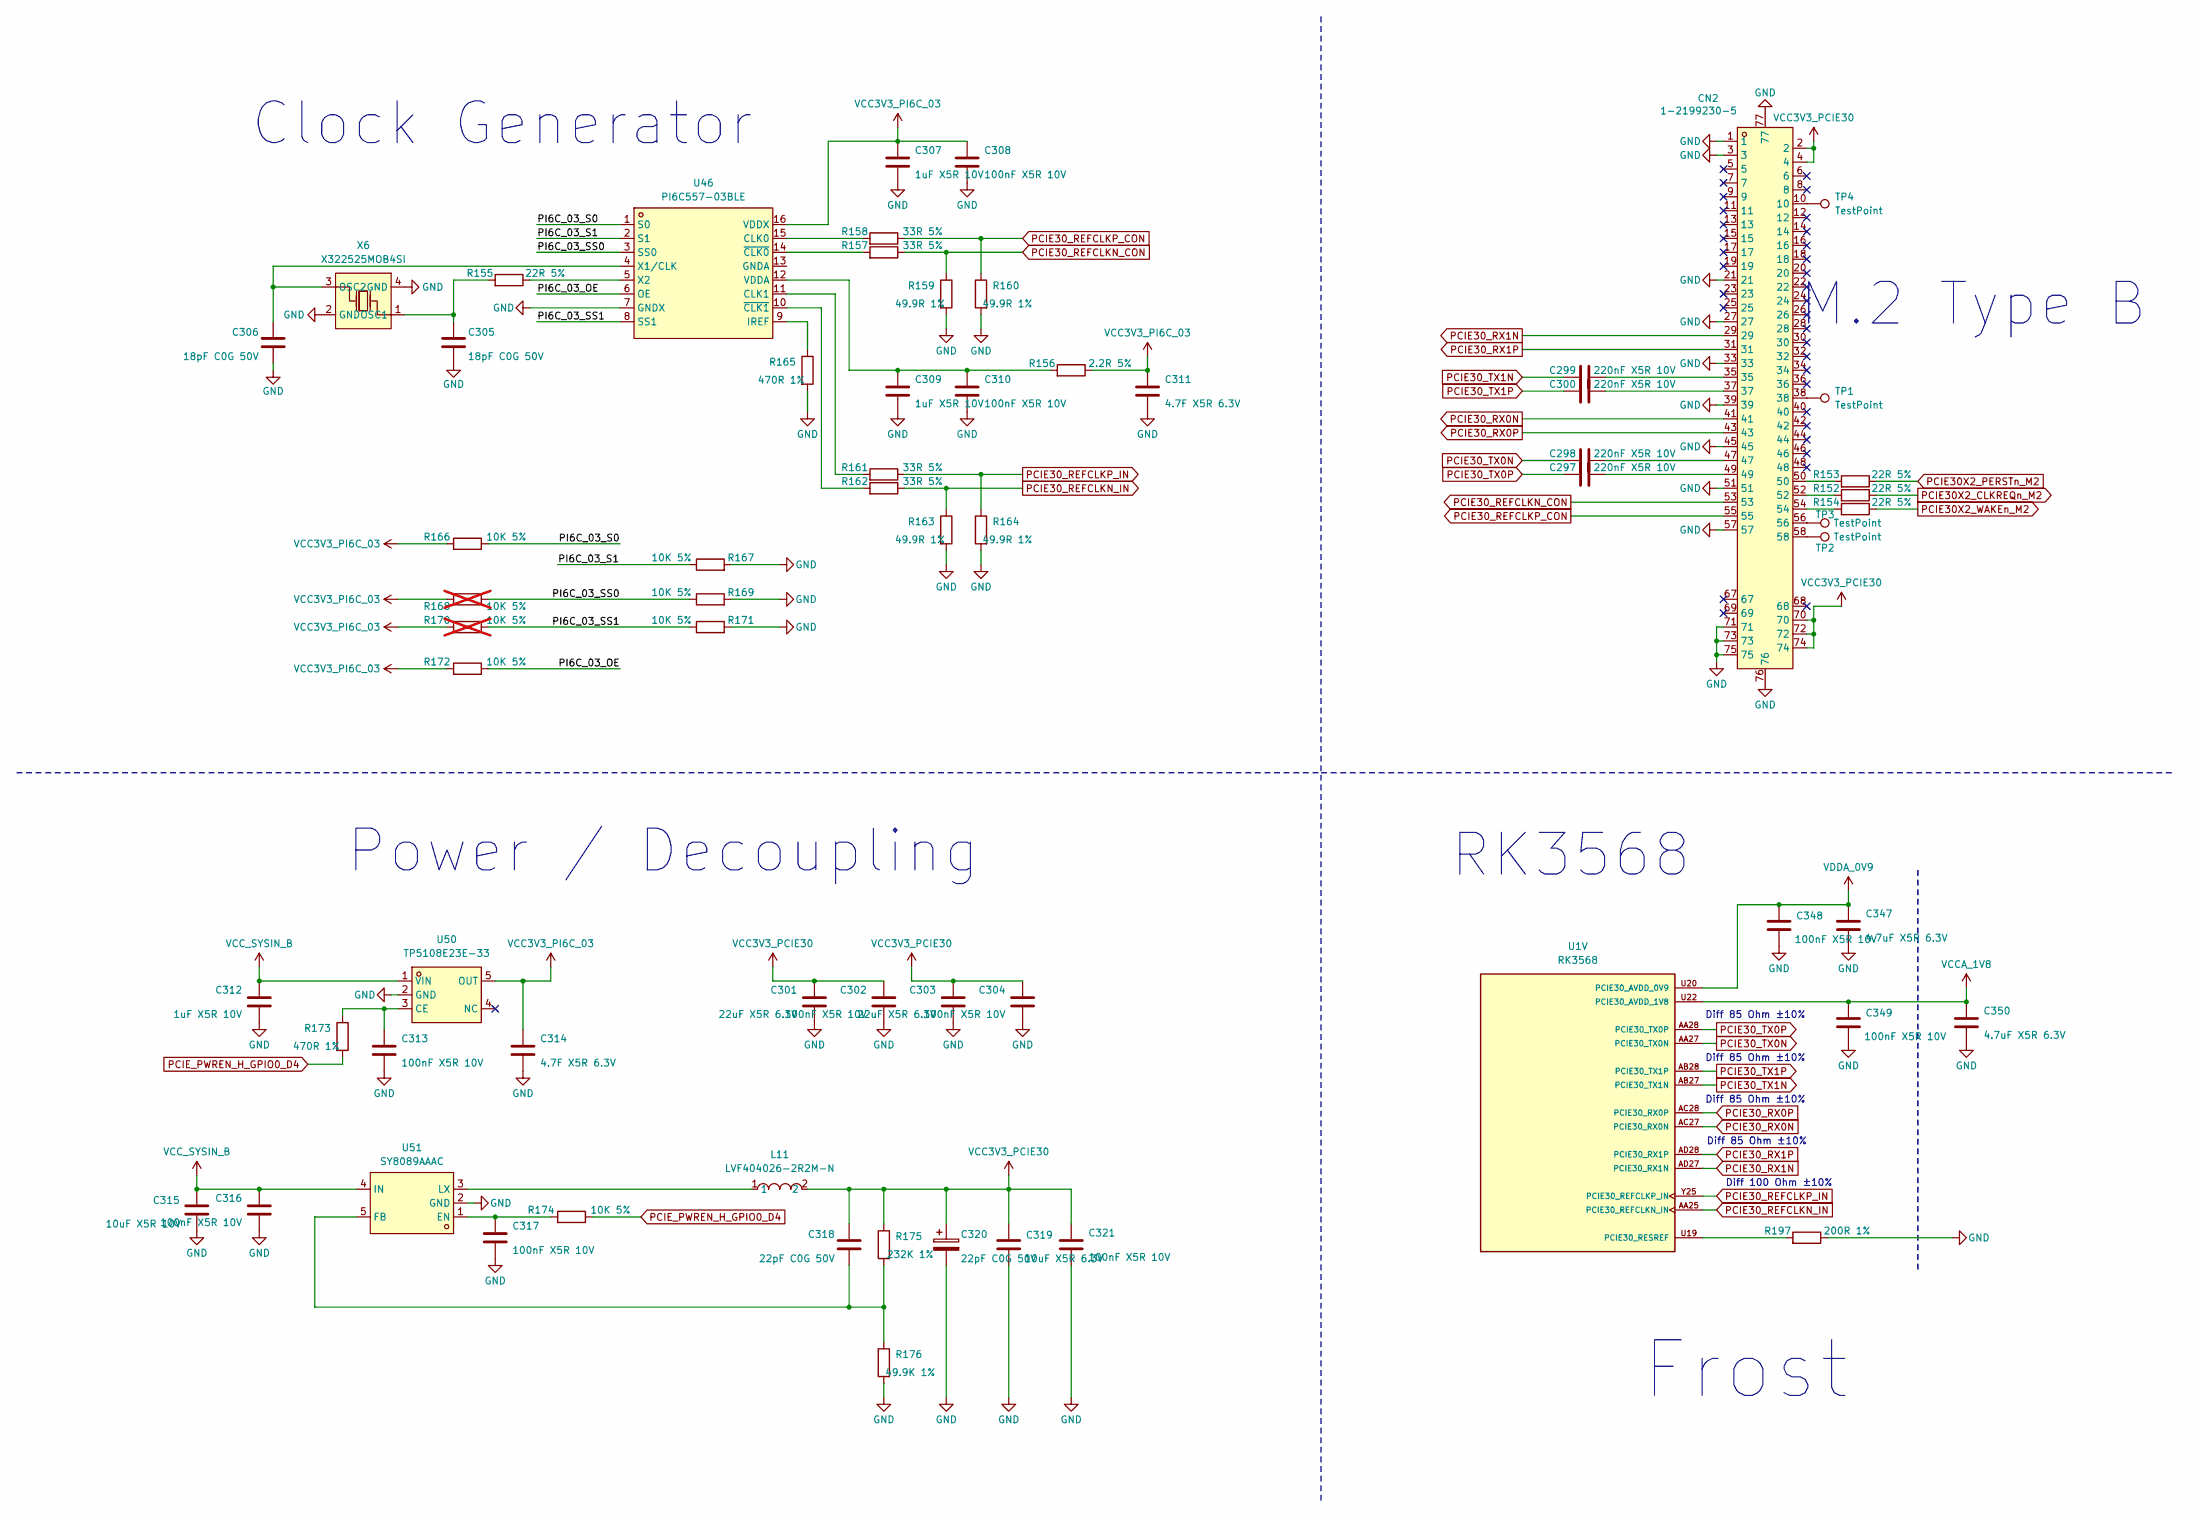
[picture p18: schematic pcie.kicad_sch]

Parts:
C297, C298, C299, C300: 220nF X5R 10V; C_0201_0603Metric
C301, C303: 22uF X5R 6.3V; C_0603_1608Metric
C302, C304, C308, C310, C313, C316, C317, C321: 100nF X5R 10V; C_0402_1005Metric
C305, C306: 18pF C0G 50V; C_0402_1005Metric
C307, C309, C312: 1uF X5R 10V; C_0402_1005Metric
C311, C314: 4.7F X5R 6.3V; C_0402_1005Metric
C315: 10uF X5R 10V; C_0603_1608Metric
C318: 22pF C0G 50V; C_0402_1005Metric
C319: 10uF X5R 6.3V; C_0603_1608Metric
C320: 22pF C0G 50V; CP_Elec_6.3x5.9; LCSC Part C186713
C347, C350: 4.7uF X5R 6.3V; C_0402_1005Metric
C348, C349: 100nF X5R 10V; C_0201_0603Metric
CN2: 1-2199230-5; PCIE-SMD_75P-P0.50_1-2199230-5; LCSC Part C590854
L11: LVF404026-2R2M-N; IND-SMD_L4.0-W4.0; LCSC Part C2847115
R152, R153, R154, R155: 22R 5%; R_0402_1005Metric
R156: 2.2R 5%; R_0402_1005Metric
R157, R158, R161, R162: 33R 5%; R_0201_0603Metric
R159, R160, R163, R164: 49.9R 1%; R_0201_0603Metric
R165, R173: 470R 1%; R_0402_1005Metric
R166, R167, R169, R171, R172, R174: 10K 5%; R_0402_1005Metric
R168, R170: 10K 5%; R_0402_1005Metric; not fitted
R175: 232K 1%; R_0402_1005Metric
R176: 49.9K 1%; R_0402_1005Metric
R197: 200R 1%; R_0201_0603Metric
TP1, TP2, TP3, TP4: TestPoint; TestPoint_Pad_D1.0mm
U1: RK3568; BGA636C65P28X28_1900X1900X168; PARTREV 1.3; LCSC C3345225
U46: PI6C557-03BLE; TSSOP-16_L5.0-W4.4-P0.65-LS6.4-BL; LCSC Part C150743
U50: TP5108E23E-33; SOT-23-5_L3.0-W1.7-P0.95-LS2.8-BL; LCSC Part C587168
U51: SY8089AAAC; SOT-23-5_L3.0-W1.7-P0.95-LS2.8-BR; LCSC Part C78988
X6: X322525MOB4SI; CRYSTAL-SMD_4P-L3.2-W2.5-BL; LCSC Part C9006

Connections:
/PCIE/PI6C_03_OE: R172.1, U46.6 (OE)
/PCIE/PI6C_03_S0: R166.1, U46.1 (S0)
/PCIE/PI6C_03_S1: R167.1, U46.2 (S1)
/PCIE/PI6C_03_SS0: R168.1, R169.1, U46.3 (SS0)
/PCIE/PI6C_03_SS1: R170.1, R171.1, U46.8 (SS1)
unnamed: C297.1, CN2.49
unnamed: C298.1, CN2.47
unnamed: C299.1, CN2.35
unnamed: C300.1, CN2.37
unnamed: CN2.10, TP4.1
unnamed: CN2.38, TP1.1
unnamed: CN2.50, R153.2
unnamed: CN2.52, R152.2
unnamed: CN2.54, R154.2
unnamed: CN2.56, TP3.1
unnamed: CN2.58, TP2.1
unnamed: R197.2, U1.U19 (PCIE30_RESREF)
unnamed: R158.2, U46.15 (CLK0)
unnamed: R161.2, U46.11 (CLK1)
unnamed: R165.1, U46.9 (IREF)
unnamed: C309.1, C310.1, R156.2, U46.12 (VDDA)
unnamed: C306.1, U46.4 (X1/CLK), X6.3 (OSC2)
unnamed: R155.1, U46.5 (X2)
unnamed: R157.2, U46.14 (~CLK0)
unnamed: R162.2, U46.10 (~CLK1)
unnamed: C313.1, R173.1, U50.3 (CE)
unnamed: C317.1, R174.2, U51.1 (EN)
unnamed: C318.2, R175.2, R176.1, U51.5 (FB)
unnamed: L11.1, U51.3 (LX)
unnamed: C305.1, R155.2, X6.1 (OSC1)
PCIE30X2_CLKREQn_M2: R152.1; also elsewhere on the board
PCIE30X2_PERSTn_M2: R153.1; also elsewhere on the board
PCIE30X2_WAKEn_M2: R154.1; also elsewhere on the board
PCIE30_REFCLKN_CON: CN2.53, R157.1, R159.1
PCIE30_REFCLKN_IN: R162.1, R163.1, U1.AA25 (PCIE30_REFCLKN_IN)
PCIE30_REFCLKP_CON: CN2.55, R158.1, R160.1
PCIE30_REFCLKP_IN: R161.1, R164.1, U1.Y25 (PCIE30_REFCLKP_IN)
PCIE30_RX0N: CN2.41, U1.AC27 (PCIE30_RX0N)
PCIE30_RX0P: CN2.43, U1.AC28 (PCIE30_RX0P)
PCIE30_RX1N: CN2.29, U1.AD27 (PCIE30_RX1N)
PCIE30_RX1P: CN2.31, U1.AD28 (PCIE30_RX1P)
PCIE30_TX0N: C298.2, U1.AA27 (PCIE30_TX0N)
PCIE30_TX0P: C297.2, U1.AA28 (PCIE30_TX0P)
PCIE30_TX1N: C299.2, U1.AB27 (PCIE30_TX1N)
PCIE30_TX1P: C300.2, U1.AB28 (PCIE30_TX1P)
PCIE_PWREN_H_GPIO0_D4: R173.2, R174.1; also elsewhere on the board
VCC3V3_PCIE30: C301.1, C302.1, C303.1, C304.1, C318.1, C319.1, C320.1, C321.1, CN2.2, CN2.4, CN2.70, CN2.72, CN2.74, L11.2, R175.1
VCC3V3_PI6C_03: C307.1, C308.1, C311.1, C314.1, R156.1, R166.2, R168.2, R170.2, R172.2, U46.16 (VDDX), U50.5 (OUT)
VCCA_1V8: C349.1, C350.1, U1.U22 (PCIE30_AVDD_1V8); also elsewhere on the board
VCC_SYSIN: C312.1, C315.1, C316.1, U50.1 (VIN), U51.4 (IN); also elsewhere on the board
VDDA_0V9: C347.1, C348.1, U1.U20 (PCIE30_AVDD_0V9), U1.U21 (PCIE30_AVDD_0V9); also elsewhere on the board

Notes on the sheet:
Diff 100 Ohm ±10%
M.2 Type B
Diff 85 Ohm ±10%
RK3568
Clock Generator
Frost
Power / Decoupling
