notaroomba/frost/hardware/board/frost.kicad_pcb

## KiCad design hardware/board/frost.kicad_pcb (continued)

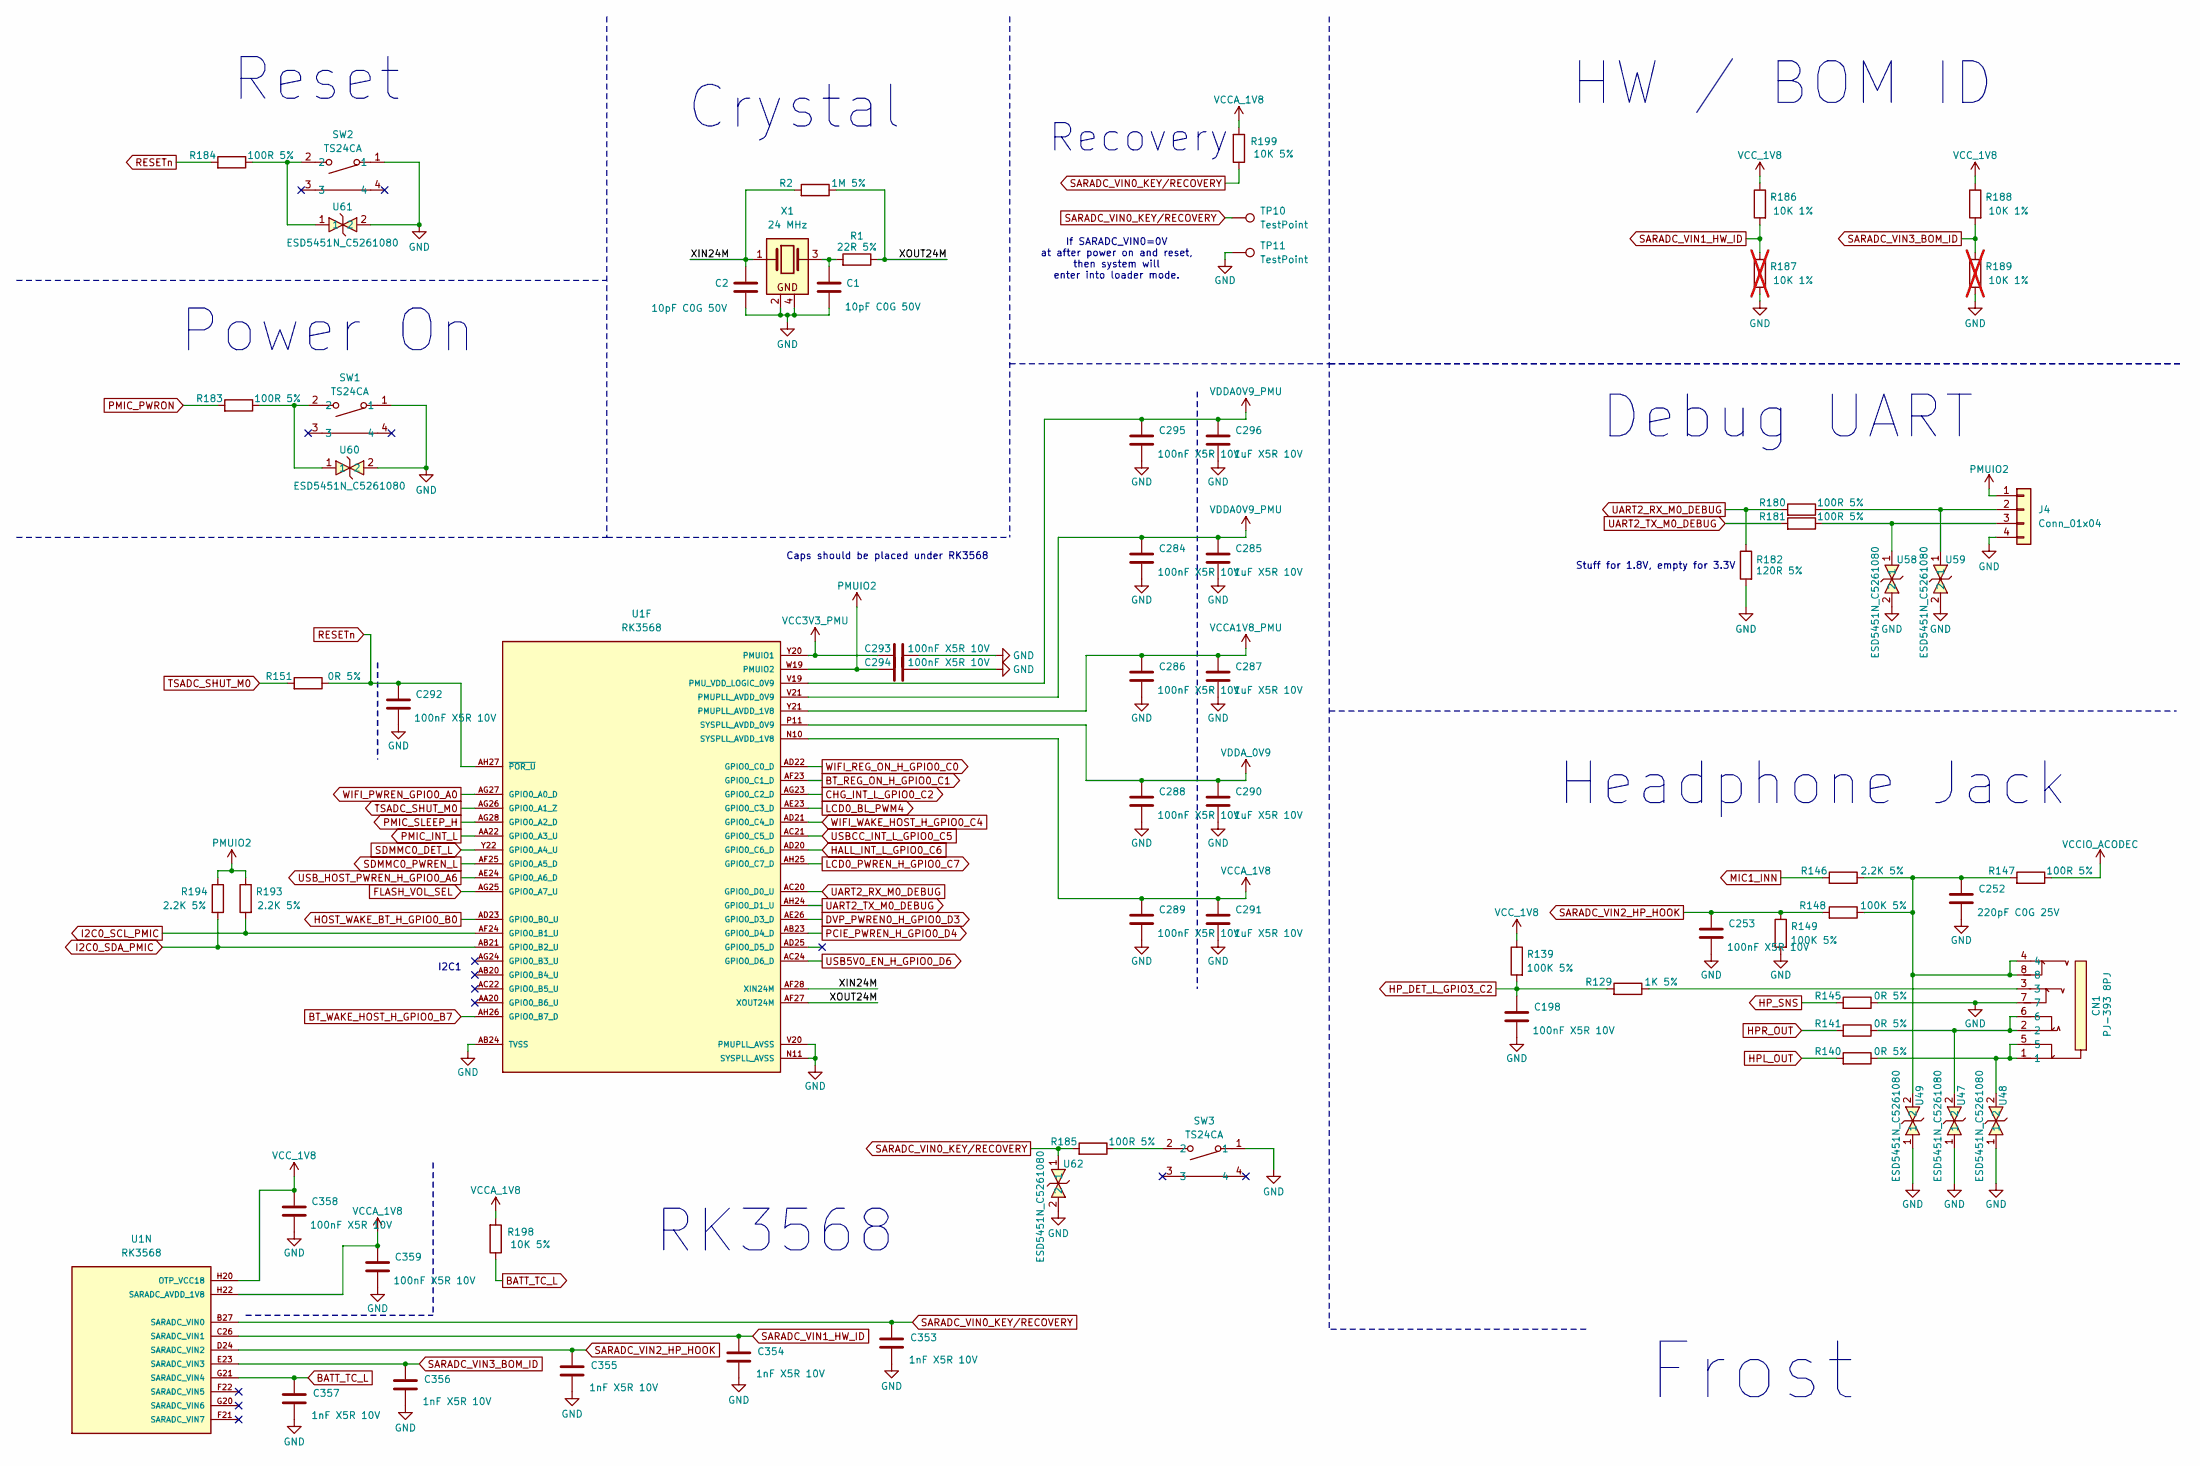
[picture p19: schematic peripherals.kicad_sch]

Parts:
C1, C2: 10pF C0G 50V; C_0402_1005Metric
C198, C253: 100nF X5R 10V; C_0402_1005Metric
C252: 220pF C0G 25V; C_0402_1005Metric
C284, C286, C288, C289, C292, C293, C294, C295, C358, C359: 100nF X5R 10V; C_0201_0603Metric
C285, C287, C290, C291, C296: 1uF X5R 10V; C_0402_1005Metric
C353, C354, C355, C356, C357: 1nF X5R 10V; C_0402_1005Metric
CN1: PJ-393 8PJ; AUDIO-SMD_PJ-393-8PJ; LCSC Part C668609
J4: Conn_01x04; PinHeader_1x04_P2.54mm_Vertical
R1: 22R 5%; R_0402_1005Metric
R2: 1M 5%; R_0402_1005Metric
R129: 1K 5%; R_0402_1005Metric
R139, R148, R149: 100K 5%; R_0402_1005Metric
R140, R141, R145, R151: 0R 5%; R_0402_1005Metric
R146, R193, R194: 2.2K 5%; R_0402_1005Metric
R147, R180, R181, R183, R184, R185: 100R 5%; R_0402_1005Metric
R182: 120R 5%; R_0402_1005Metric
R186, R188: 10K 1%; R_0402_1005Metric
R187, R189: 10K 1%; R_0402_1005Metric; not fitted
R198, R199: 10K 5%; R_0402_1005Metric
SW1, SW2, SW3: TS24CA; SW-SMD_2P-TS24CA; LCSC Part C393942
TP10, TP11: TestPoint; TestPoint_Pad_D1.0mm
U1: RK3568; BGA636C65P28X28_1900X1900X168; PARTREV 1.3; LCSC C3345225
U47, U48, U49, U58, U59, U60, U61, U62: ESD5451N_C5261080; DFN1006-2L-BI; LCSC Part C5261080
X1: 24 MHz; CRYSTAL-SMD_4P-L3.2-W2.5-BL; LCSC C15643

Connections:
/Peripherals/XIN24M: C2.1, R2.2, U1.AF28 (XIN24M), X1.1
/Peripherals/XOUT24M: R1.1, R2.1, U1.AF27 (XOUT24M)
BATT_TC_L: C357.1, R198.1, U1.G21 (SARADC_VIN4)
BT_REG_ON_H_GPIO0_C1: U1.AF23 (GPIO0_C1_D); also elsewhere on the board
BT_WAKE_HOST_H_GPIO0_B7: U1.AH26 (GPIO0_B7_D); also elsewhere on the board
CHG_INT_L_GPIO0_C2: U1.AG23 (GPIO0_C2_D); also elsewhere on the board
DVP_PWREN0_H_GPIO0_D3: U1.AE26 (GPIO0_D3_D); also elsewhere on the board
FLASH_VOL_SEL: U1.AG25 (GPIO0_A7_U); also elsewhere on the board
HALL_INT_L_GPIO0_C6: U1.AD20 (GPIO0_C6_D); also elsewhere on the board
HOST_WAKE_BT_H_GPIO0_B0: U1.AD23 (GPIO0_B0_U); also elsewhere on the board
HPL_OUT: R140.2; also elsewhere on the board
HPR_OUT: R141.2; also elsewhere on the board
HP_DET_L_GPIO3_C2: C198.1, R129.2, R139.2; also elsewhere on the board
HP_SNS: R145.2; also elsewhere on the board
I2C0_SCL_PMIC: R193.2, U1.AF24 (GPIO0_B1_U); also elsewhere on the board
I2C0_SDA_PMIC: R194.2, U1.AB21 (GPIO0_B2_U); also elsewhere on the board
LCD0_BL_PWM4: U1.AE23 (GPIO0_C3_D); also elsewhere on the board
LCD0_PWREN_H_GPIO0_C7: U1.AH25 (GPIO0_C7_D); also elsewhere on the board
MIC1_INN: R146.2; also elsewhere on the board
unnamed: C1.1, R1.2, X1.3
unnamed: C252.1, CN1.4, CN1.8, R146.1, R147.2, R148.1, U49.2
unnamed: CN1.1, CN1.5, R140.1, U48.2
unnamed: CN1.2, CN1.6, R141.1, U47.2
unnamed: CN1.3, R129.1
unnamed: J4.2, R180.1, U59.1
unnamed: J4.3, R181.1, U58.1
unnamed: R183.1, SW1.2, U60.1
unnamed: R184.1, SW2.2, U61.1
unnamed: R185.1, SW3.2
PCIE_PWREN_H_GPIO0_D4: U1.AB23 (GPIO0_D4_D); also elsewhere on the board
PMIC_INT_L: U1.AA22 (GPIO0_A3_U); also elsewhere on the board
PMIC_PWRON: R183.2; also elsewhere on the board
PMIC_SLEEP_H: U1.AG28 (GPIO0_A2_D); also elsewhere on the board
PMUIO2: C294.1, J4.1, R193.1, R194.1, U1.W19 (PMUIO2); also elsewhere on the board
RESETn: C292.1, R151.1, R184.2, U1.AH27 (~POR_U); also elsewhere on the board
SARADC_VIN0_KEY/RECOVERY: C353.1, R185.2, R199.1, TP10.1, U1.B27 (SARADC_VIN0), U62.1
SARADC_VIN1_HW_ID: C354.1, R186.2, R187.1, U1.C26 (SARADC_VIN1)
SARADC_VIN2_HP_HOOK: C253.1, C355.1, R148.2, R149.1, U1.D24 (SARADC_VIN2)
SARADC_VIN3_BOM_ID: C356.1, R188.2, R189.1, U1.E23 (SARADC_VIN3)
SDMMC0_DET_L: U1.Y22 (GPIO0_A4_U); also elsewhere on the board
SDMMC0_PWREN_L: U1.AF25 (GPIO0_A5_D); also elsewhere on the board
TSADC_SHUT_M0: R151.2, U1.AG26 (GPIO0_A1_Z)
UART2_RX_M0_DEBUG: R180.2, R182.1, U1.AC20 (GPIO0_D0_U)
UART2_TX_M0_DEBUG: R181.2, U1.AH24 (GPIO0_D1_U)
USB5V0_EN_H_GPIO0_D6: U1.AC24 (GPIO0_D6_D); also elsewhere on the board
USBCC_INT_L_GPIO0_C5: U1.AC21 (GPIO0_C5_D); also elsewhere on the board
USB_HOST_PWREN_H_GPIO0_A6: U1.AE24 (GPIO0_A6_D); also elsewhere on the board
VCC3V3_PMU: C293.1, U1.Y20 (PMUIO1); also elsewhere on the board
VCCA1V8_PMU: C286.1, C287.1, U1.Y21 (PMUPLL_AVDD_1V8); also elsewhere on the board
VCCA_1V8: C289.1, C291.1, C359.1, R198.2, R199.2, U1.H22 (SARADC_AVDD_1V8), U1.N10 (SYSPLL_AVDD_1V8); also elsewhere on the board
VCCIO_ACODEC: R147.1; also elsewhere on the board
VCC_1V8: C358.1, R139.1, R186.1, R188.1, U1.H20 (OTP_VCC18); also elsewhere on the board
VDDA0V9_PMU: C284.1, C285.1, C295.1, C296.1, U1.V19 (PMU_VDD_LOGIC_0V9), U1.V21 (PMUPLL_AVDD_0V9); also elsewhere on the board
VDDA_0V9: C288.1, C290.1, U1.P11 (SYSPLL_AVDD_0V9); also elsewhere on the board
WIFI_PWREN_GPIO0_A0: U1.AG27 (GPIO0_A0_D)
WIFI_REG_ON_H_GPIO0_C0: U1.AD22 (GPIO0_C0_D); also elsewhere on the board
WIFI_WAKE_HOST_H_GPIO0_C4: U1.AD21 (GPIO0_C4_D); also elsewhere on the board

Notes on the sheet:
If SARADC_VIN0=0V at after power on and reset, then system will enter into loader mode.
HW / BOM ID
RK3568
Headphone Jack
Caps should be placed under RK3568
Debug UART
Recovery
Frost
Crystal
Reset
I2C1
Power On
Stuff for 1.8V, empty for 3.3V

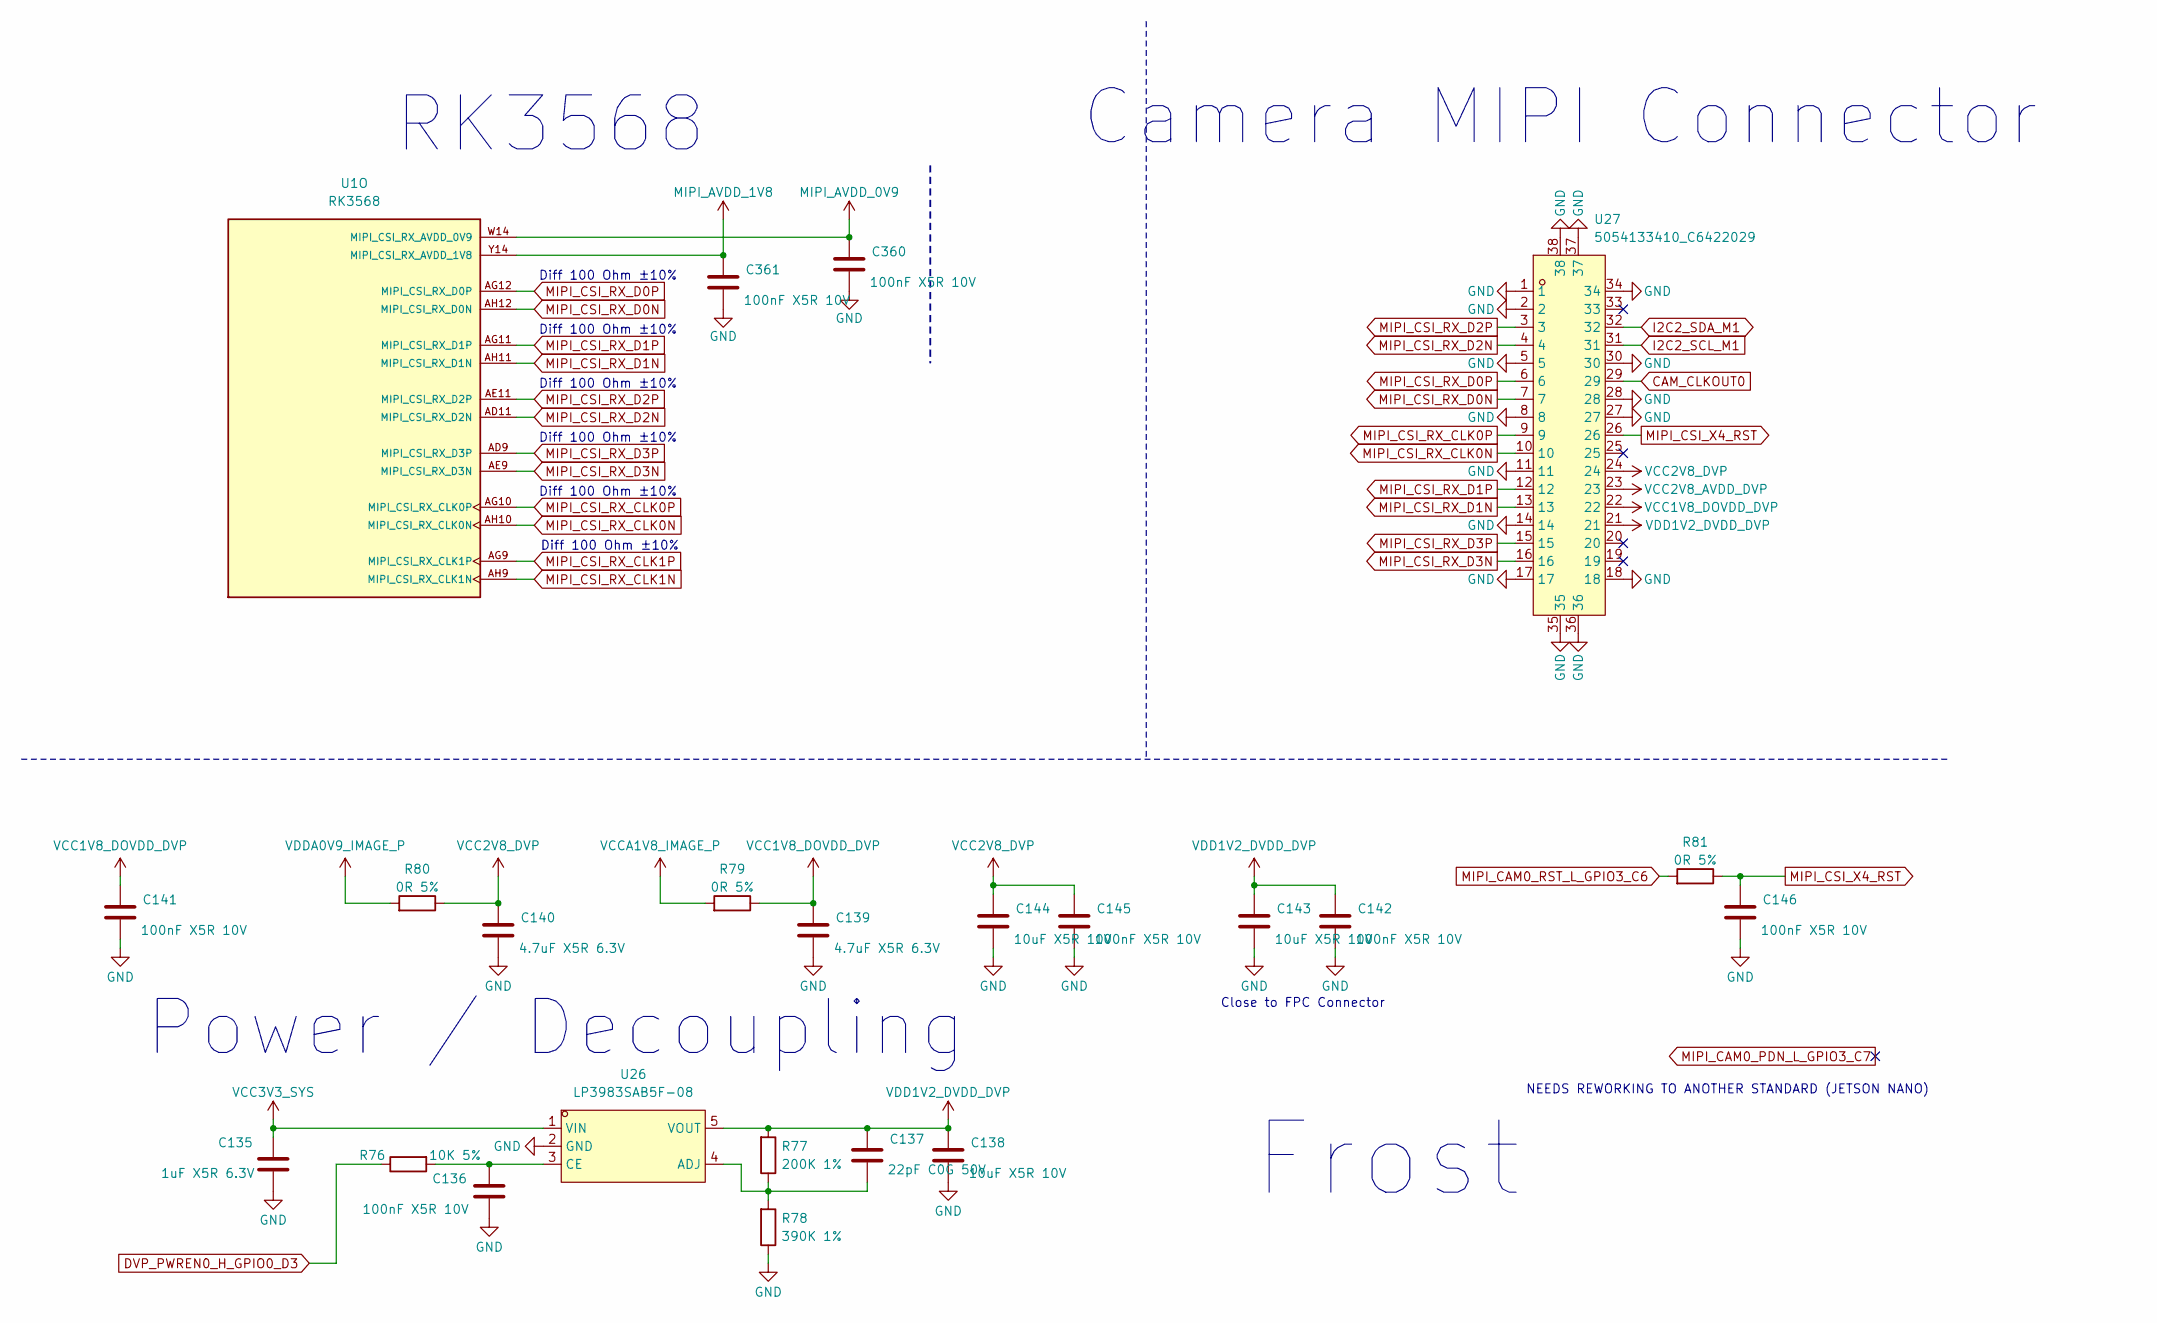
[picture p20: schematic camera.kicad_sch]

Parts:
C135: 1uF X5R 6.3V; C_0402_1005Metric
C136, C141, C142, C145, C146: 100nF X5R 10V; C_0402_1005Metric
C137: 22pF C0G 50V; C_0402_1005Metric
C138, C143, C144: 10uF X5R 10V; C_0603_1608Metric
C139, C140: 4.7uF X5R 6.3V; C_0603_1608Metric
C360, C361: 100nF X5R 10V; C_0201_0603Metric
R76: 10K 5%; R_0402_1005Metric
R77: 200K 1%; R_0402_1005Metric
R78: 390K 1%; R_0402_1005Metric
R79, R80, R81: 0R 5%; R_0402_1005Metric
U1: RK3568; BGA636C65P28X28_1900X1900X168; PARTREV 1.3; LCSC C3345225
U26: LP3983SAB5F-08; SOT-23-5_L3.0-W1.7-P0.95-LS2.8-BR; LCSC Part C324567
U27: 5054133410_C6422029; CONN-SMD_5054133410; LCSC Part C6422029

Connections:
CAM_CLKOUT0: U27.29
DVP_PWREN0_H_GPIO0_D3: R76.1; also elsewhere on the board
I2C2_SCL_M1: U27.31; also elsewhere on the board
I2C2_SDA_M1: U27.32; also elsewhere on the board
MIPI_AVDD_0V9: C360.1, U1.W14 (MIPI_CSI_RX_AVDD_0V9); also elsewhere on the board
MIPI_AVDD_1V8: C361.1, U1.Y14 (MIPI_CSI_RX_AVDD_1V8); also elsewhere on the board
MIPI_CAM0_RST_L_GPIO3_C6: R81.2; also elsewhere on the board
MIPI_CSI_RX_CLK0N: U1.AH10 (MIPI_CSI_RX_CLK0N), U27.10
MIPI_CSI_RX_CLK0P: U1.AG10 (MIPI_CSI_RX_CLK0P), U27.9
MIPI_CSI_RX_CLK1N: U1.AH9 (MIPI_CSI_RX_CLK1N)
MIPI_CSI_RX_CLK1P: U1.AG9 (MIPI_CSI_RX_CLK1P)
MIPI_CSI_RX_D0N: U1.AH12 (MIPI_CSI_RX_D0N), U27.7
MIPI_CSI_RX_D0P: U1.AG12 (MIPI_CSI_RX_D0P), U27.6
MIPI_CSI_RX_D1N: U1.AH11 (MIPI_CSI_RX_D1N), U27.13
MIPI_CSI_RX_D1P: U1.AG11 (MIPI_CSI_RX_D1P), U27.12
MIPI_CSI_RX_D2N: U1.AD11 (MIPI_CSI_RX_D2N), U27.4
MIPI_CSI_RX_D2P: U1.AE11 (MIPI_CSI_RX_D2P), U27.3
MIPI_CSI_RX_D3N: U1.AE9 (MIPI_CSI_RX_D3N), U27.16
MIPI_CSI_RX_D3P: U1.AD9 (MIPI_CSI_RX_D3P), U27.15
MIPI_CSI_X4_RST: C146.1, R81.1, U27.26
unnamed: C137.2, R77.1, R78.2, U26.4 (ADJ)
unnamed: C136.1, R76.2, U26.3 (CE)
VCC1V8_DOVDD_DVP: C139.1, C141.1, R79.1, U27.22
VCC2V8_AVDD_DVP: U27.23
VCC2V8_DVP: C140.1, C144.1, C145.1, R80.1, U27.24
VCC3V3_SYS: C135.1, U26.1 (VIN); also elsewhere on the board
VCCA1V8_IMAGE_P: R79.2; also elsewhere on the board
VDD1V2_DVDD_DVP: C137.1, C138.1, C142.1, C143.1, R77.2, U26.5 (VOUT), U27.21
VDDA0V9_IMAGE_P: R80.2; also elsewhere on the board

Notes on the sheet:
Frost
Camera MIPI Connector
RK3568
Diff 100 Ohm ±10%
Close to FPC Connector
NEEDS REWORKING TO ANOTHER STANDARD (JETSON NANO)
Power / Decoupling

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
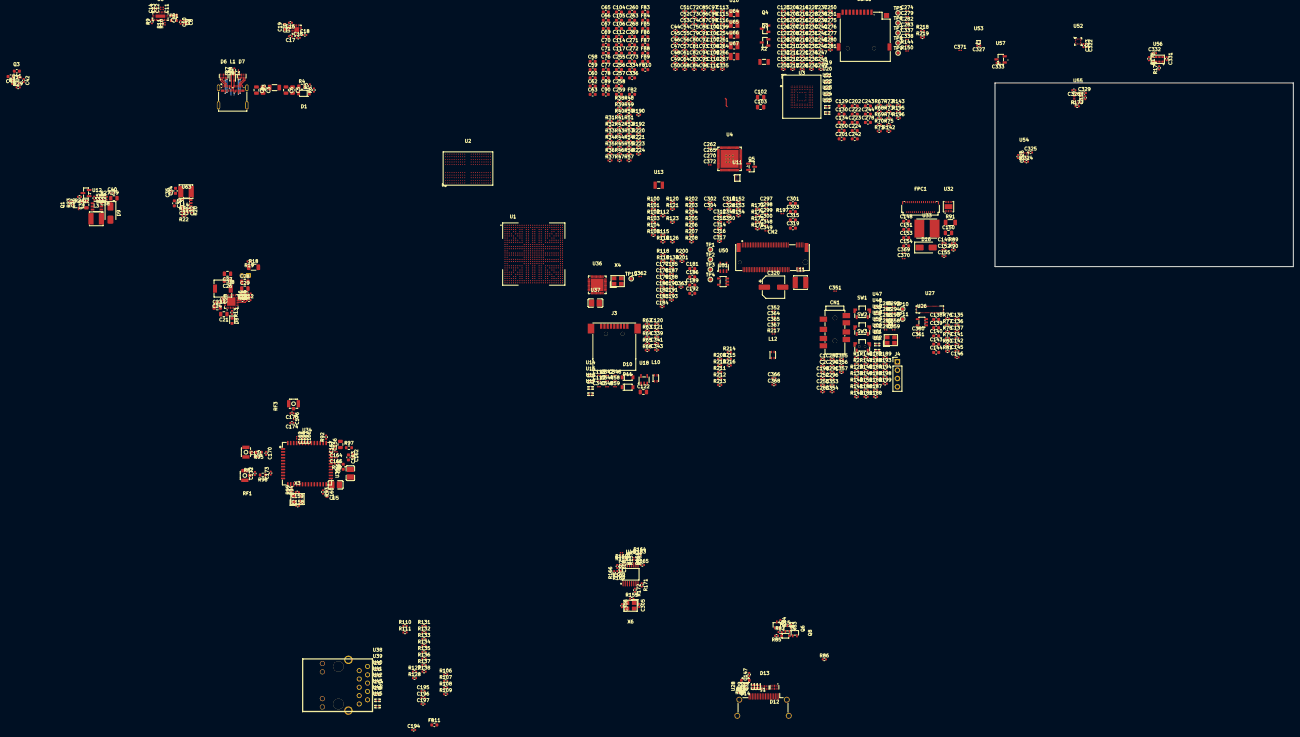
[picture p21: board frost.kicad_pcb from above]

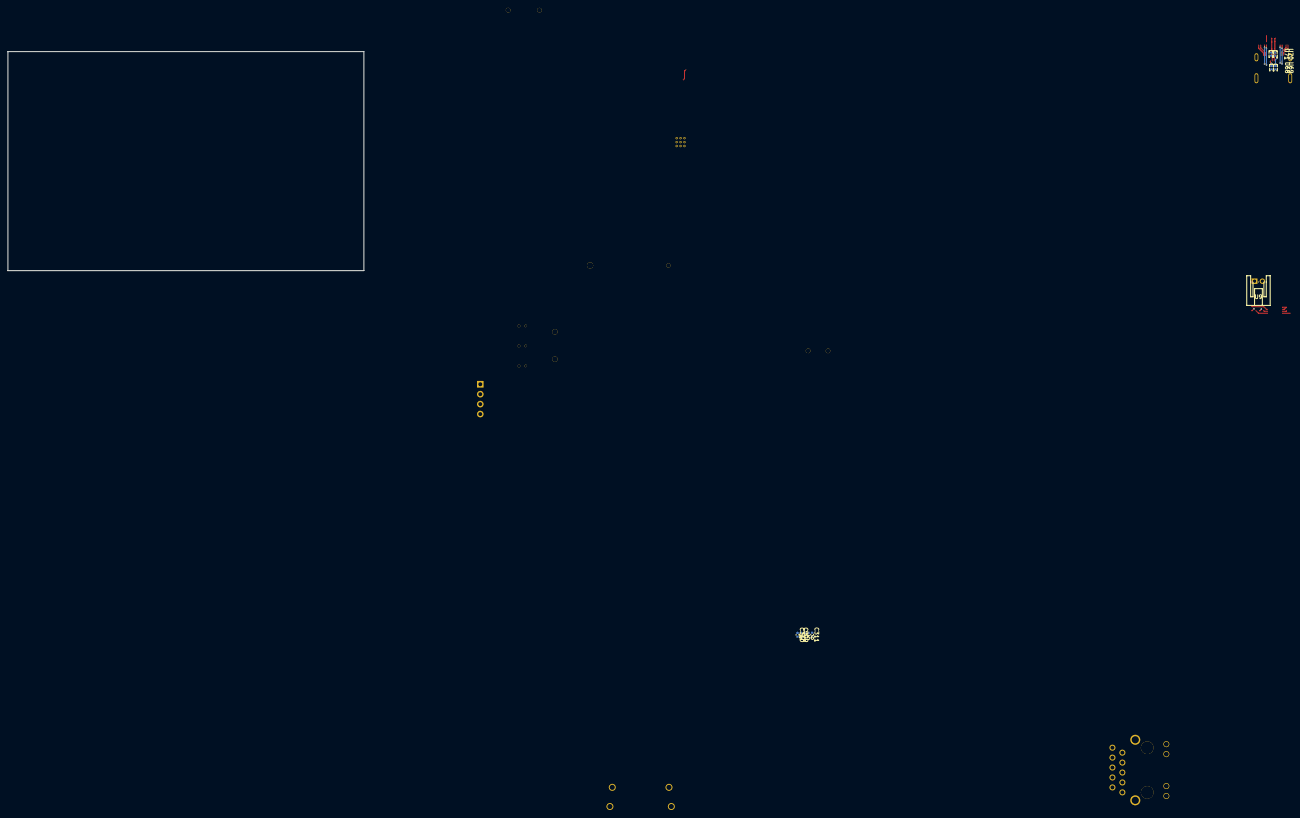
[picture p22: board frost.kicad_pcb from below]

Board: 6 copper layers, 91.0 x 56.0 mm, 726 parts (9 on the bottom side), 529 nets.
