notaroomba/frost/(commit log)

2025-12-03 init commit
    [frost.kicad_pcb, frost.kicad_sch]
2025-12-04 reading up on power
    [ethernet.kicad_sch, frost.kicad_sch, hdmi.kicad_sch, memory_storage.kicad_sch, peripherals.kicad_sch, power.kicad_sch, usb.kicad_sch, wireless.kicad_sch]
2025-12-07 added stuff
    [bom.csv, designators.csv, frost.kicad_pcb, frost.kicad_sch, peripherals.kicad_sch, positions.csv, power.kicad_sch, wireless.kicad_sch]
2025-12-07 added 3v3 buck and bat
    [power.kicad_sch]
2025-12-07 start pmic
    [power.kicad_sch]
2025-12-08 power done
    [power.kicad_sch]
2025-12-08 revised power
    [power.kicad_sch]
2025-12-09 emmc stuff
    [frost.kicad_sch, hdmi.kicad_sch, memory_storage.kicad_sch, peripherals.kicad_sch, power.kicad_sch, usb.kicad_sch]
2025-12-10 MIPI IS FAKE
    [BOM.csv, camera.kicad_sch, frost.kicad_pcb, frost.kicad_sch, memory_storage.kicad_sch, peripherals.kicad_sch]
2025-12-11 change of camera
    [BOM.csv, camera.kicad_sch, frost.kicad_pcb]
2025-12-14 start of ethernet
    [BOM.csv, camera.kicad_sch, display.kicad_sch, ethernet.kicad_sch, frost.kicad_pcb, frost.kicad_sch, hdmi.kicad_sch, power.kicad_sch]
2025-12-14 finish ethernet
    [ethernet.kicad_sch, frost.kicad_pcb]
2026-03-15 add in pcie and ddr4
    [frost.kicad_sch, memory_storage.kicad_sch, pcie.kicad_sch, peripherals.kicad_sch, power.kicad_sch]
2026-03-16 finished schematic!
    [camera.kicad_sch, display.kicad_sch, ethernet.kicad_sch, frost.kicad_pcb, frost.kicad_sch, hdmi.kicad_sch, memory_storage.kicad_sch, pcie.kicad_sch]
2026-03-16 finished beautifying schematic
    [camera.kicad_sch, display.kicad_sch, ethernet.kicad_sch, frost.kicad_pcb, frost.kicad_sch, hdmi.kicad_sch, memory_storage.kicad_sch, pcie.kicad_sch]
2026-03-25 did a thing
    [ethernet.kicad_sch, frost.kicad_pcb, pcie.kicad_sch, power.kicad_sch, usb.kicad_sch, wireless.kicad_sch]
2026-08-28 more stuff
    [frost.kicad_pcb]
